deepak-kapa/PancakeActuator/plots/backlash_comparison.png

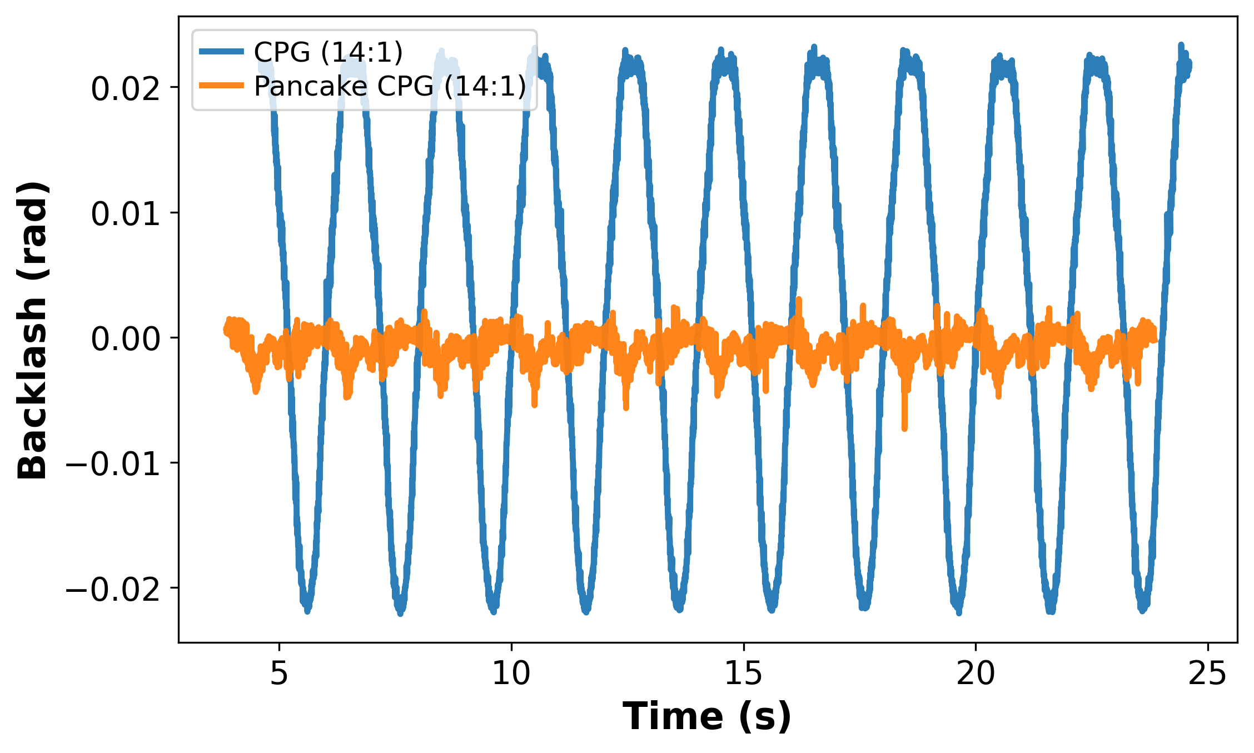
plots/backlash_comparison.png
