deepak-kapa/PancakeActuator/plots/efficiency_comparison.png

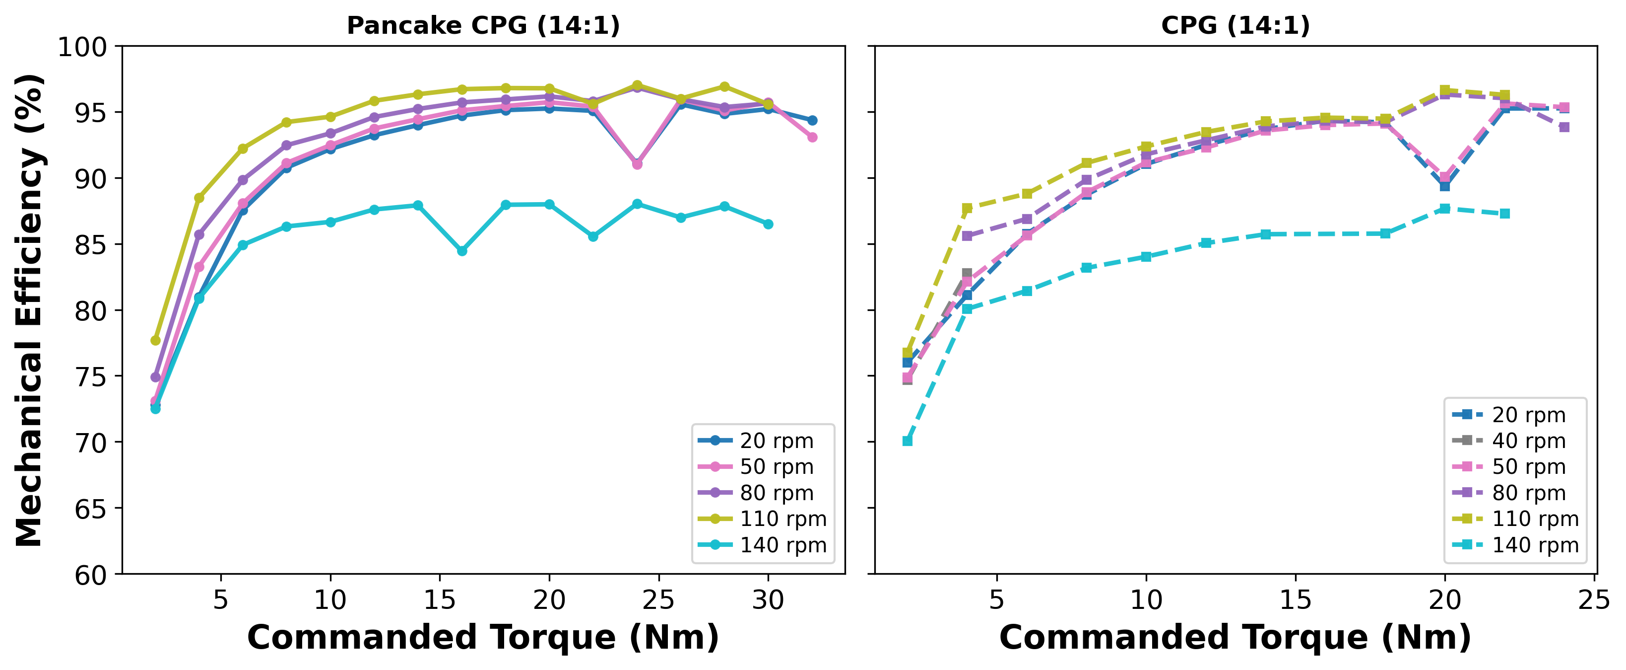
plots/efficiency_comparison.png
