deepak-kapa/PancakeActuator/plots/endurance_eff.png

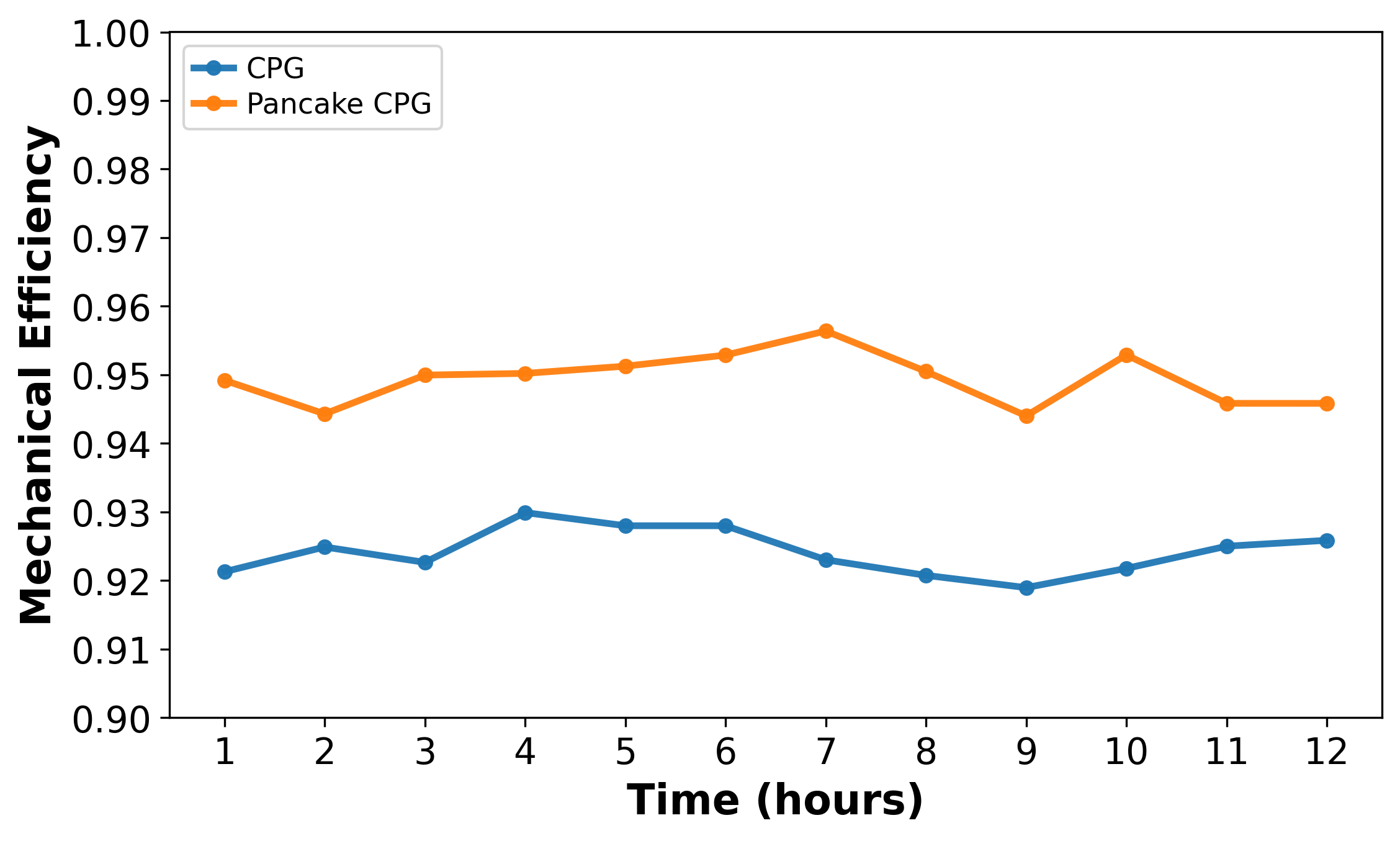
plots/endurance_eff.png
