deepak-kapa/PancakeActuator/plots/mass_width_vs_gear_ratio_metal.png

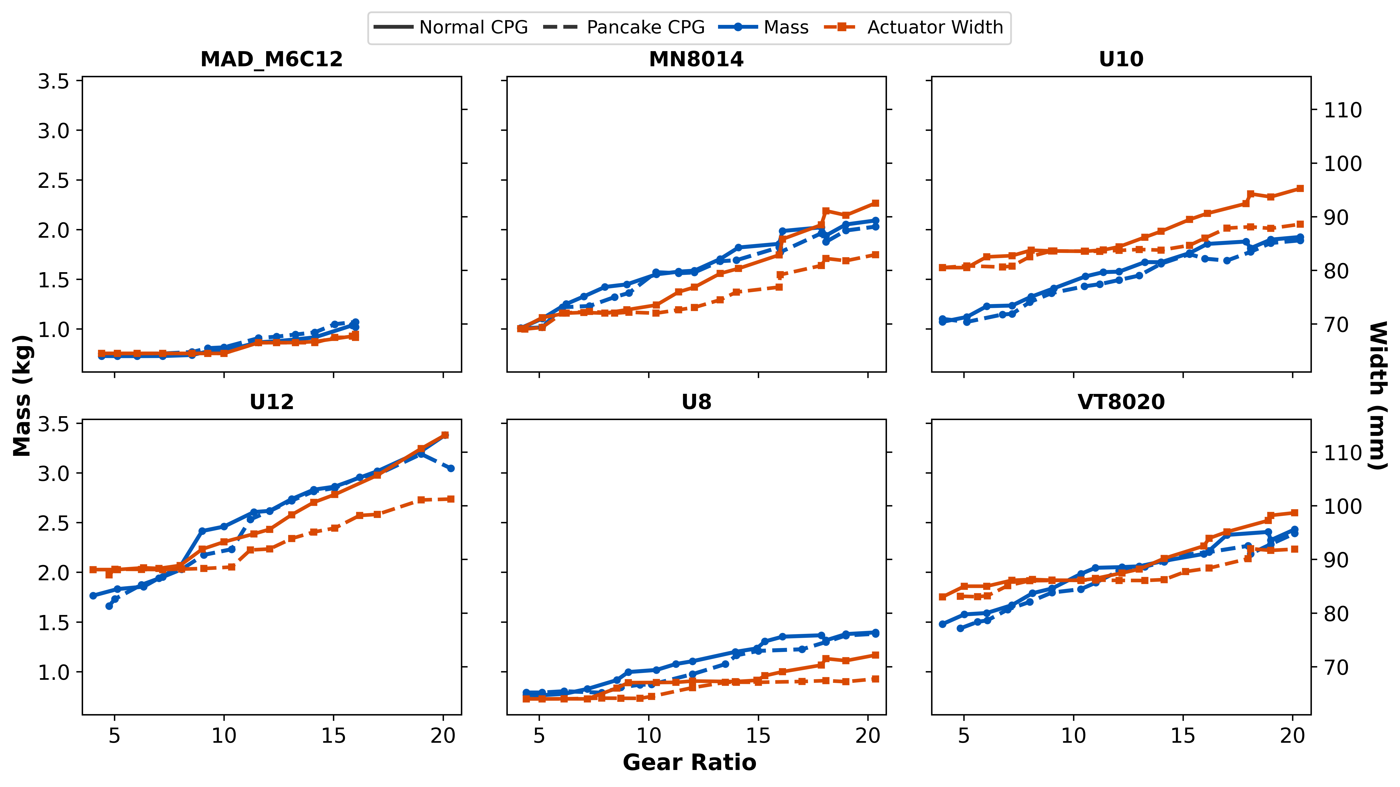
plots/mass_width_vs_gear_ratio_metal.png
