deepak-kapa/PancakeActuator/plots/stiffness_comparison.png

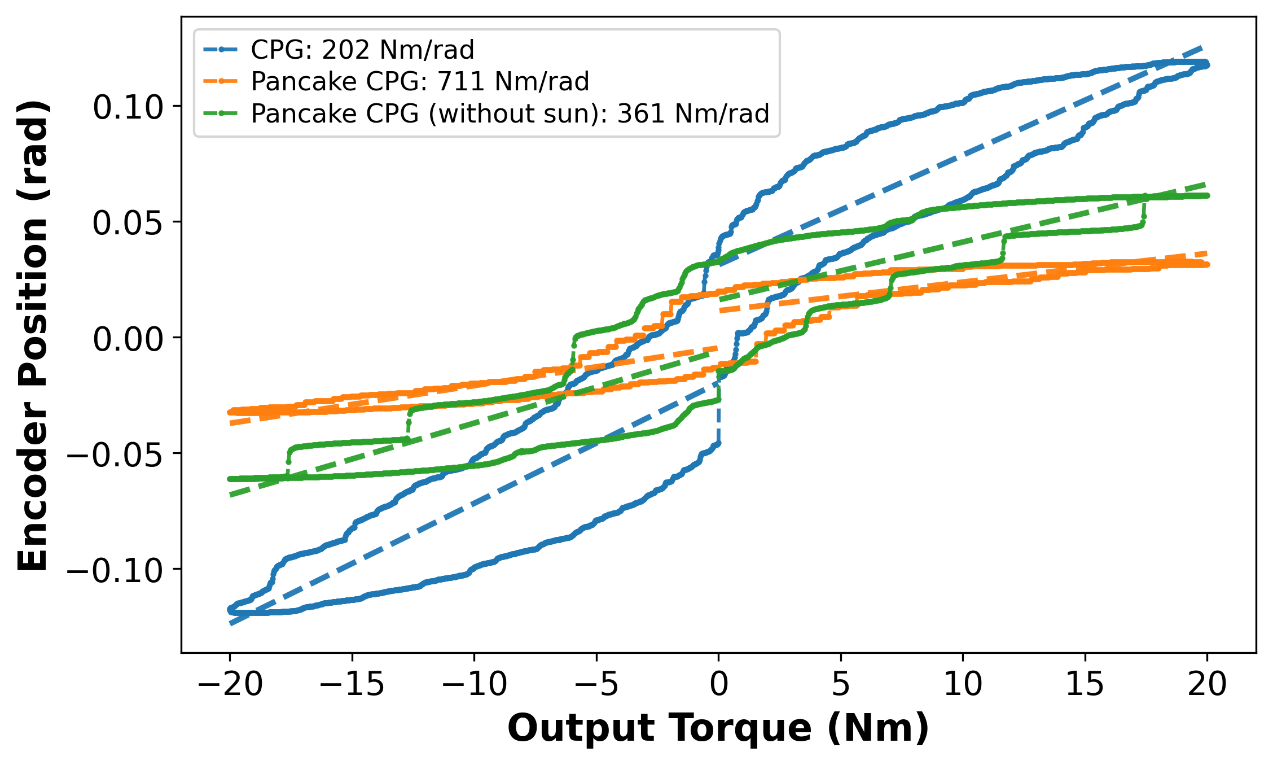
plots/stiffness_comparison.png
