deepak-kapa/PancakeActuator/plots/torque_comparison.png

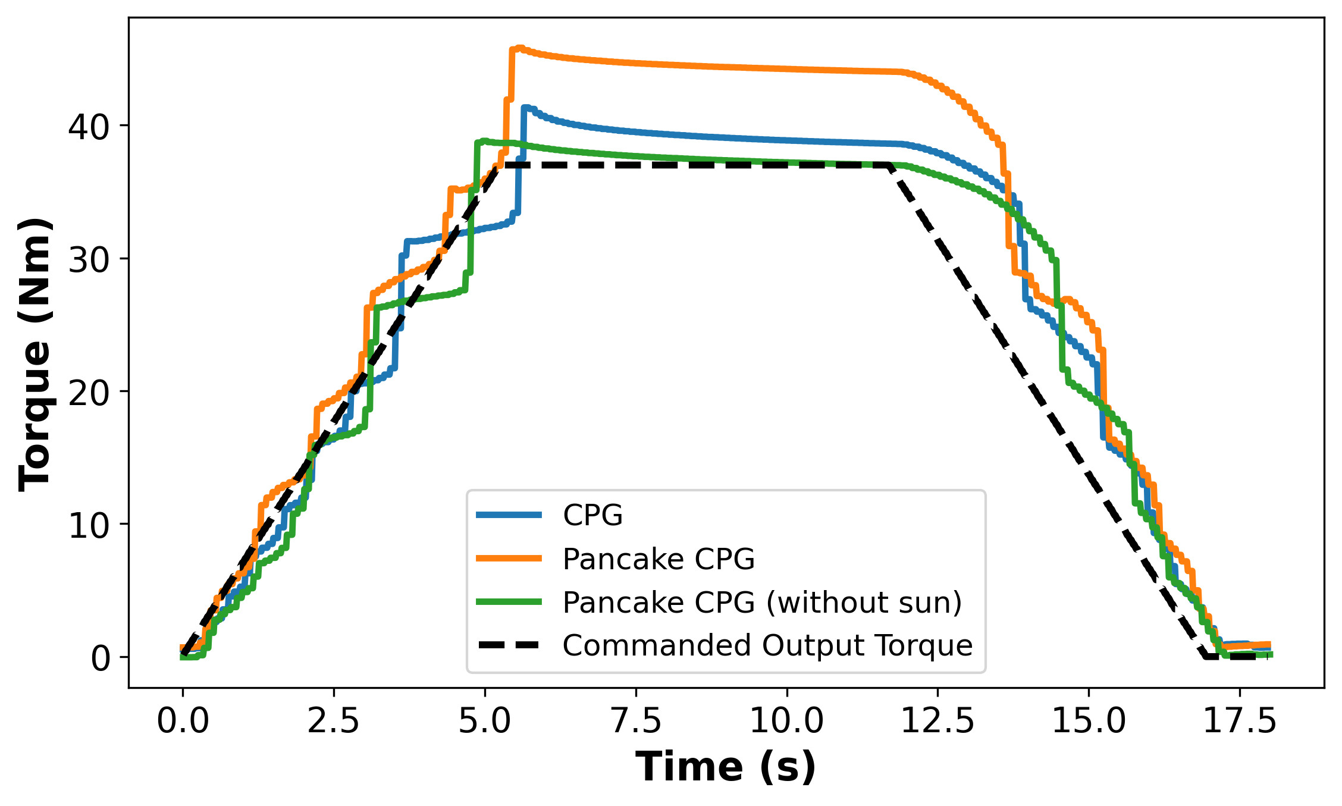
plots/torque_comparison.png
