deepak-kapa/PancakeActuator/CADs/SSPG/sspg_actuator.SLDASM

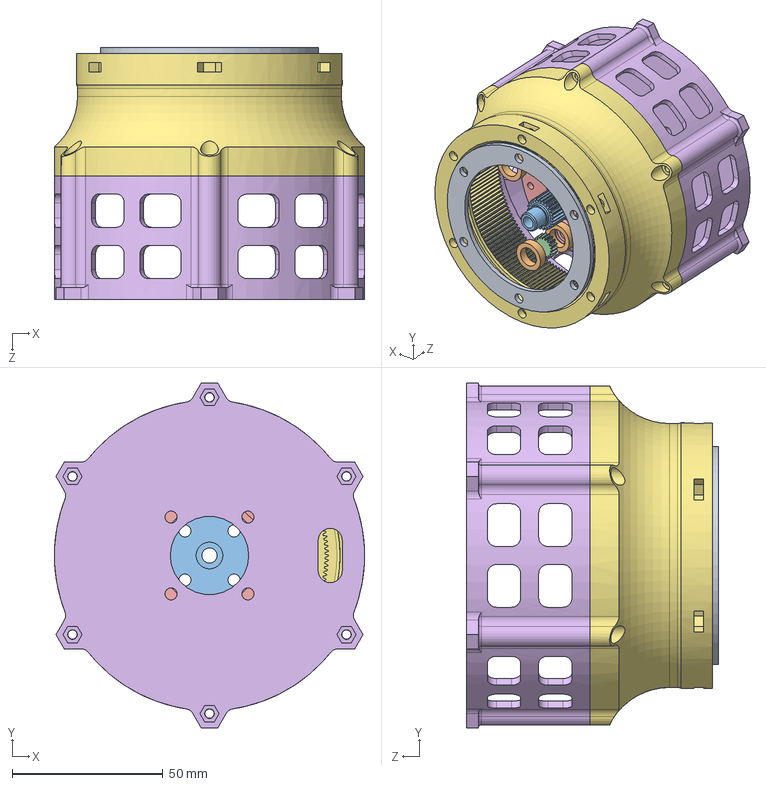
[picture p7: CAD file, 2026-04-23]
CADs/SSPG/sspg_actuator.SLDASM
102.8 x 114.3 x 83.6 mm
sspg_gearbox_casing
sspg_motor_casing
sspg_sec_carrier
sspg_planet x 3
sspg_sun
sspg_planet_bearing x 6
sspg_bearing_retainer
