deepak-kapa/PancakeActuator/CADs/DSPG/dspg_motor.SLDPRT

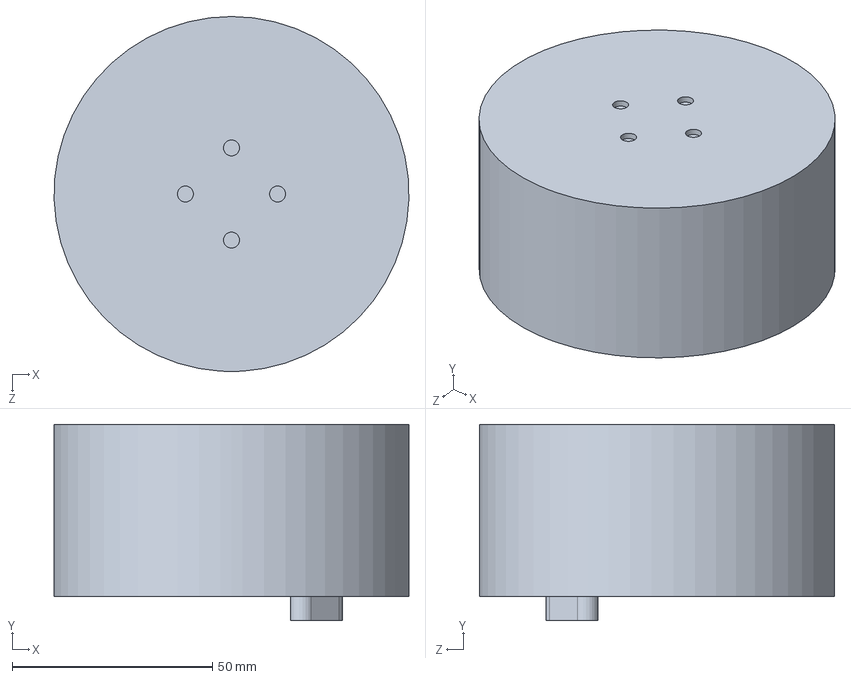
[picture p8: CAD file, 2026-04-23]
CADs/DSPG/dspg_motor.SLDPRT
88.6 x 49.0 x 88.6 mm
