deepak-kapa/PancakeActuator/CADs/WPG/wpg_actuator/wpg_actuator/wpg_bearing.SLDPRT

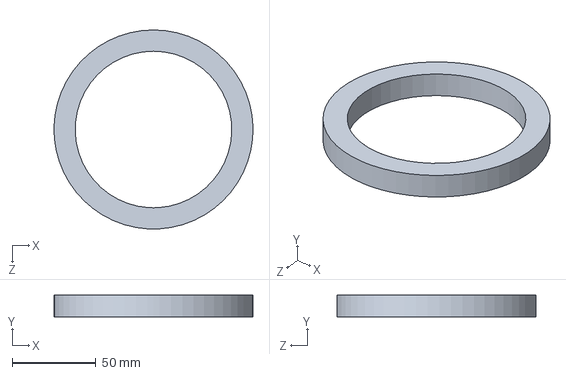
[picture p9: CAD file, 2026-04-23]
CADs/WPG/wpg_actuator/wpg_actuator/wpg_bearing.SLDPRT
119.0 x 13.0 x 119.0 mm
