deepak-kapa/PancakeActuator/pancake cads/cpg_actuator/cpg_motor.SLDPRT

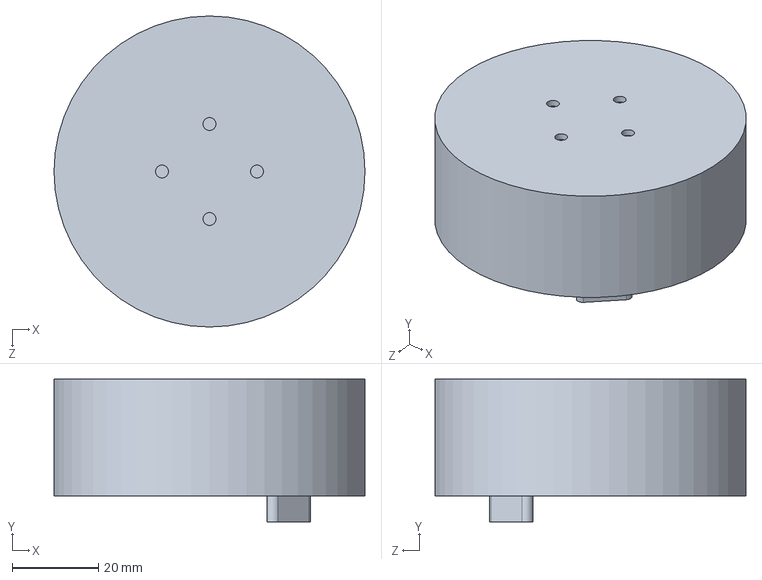
[picture p10: CAD file, 2026-08-31]
pancake cads/cpg_actuator/cpg_motor.SLDPRT
72.0 x 33.0 x 72.0 mm
