deepak-kapa/PancakeActuator/pancake cads/cpg_actuator_pancake/cpg_planet_bearing_pancake.SLDPRT

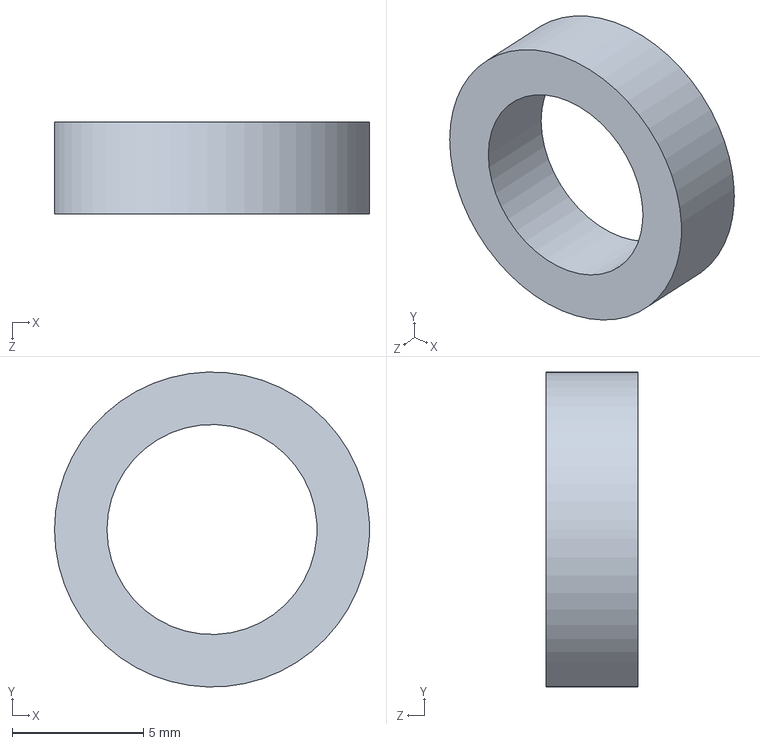
[picture p11: CAD file, 2026-04-23]
pancake cads/cpg_actuator_pancake/cpg_planet_bearing_pancake.SLDPRT
12.0 x 12.0 x 3.50 mm
