deepak-kapa/PancakeActuator/CADs/DSPG/bearing_retainer_stage2.SLDPRT

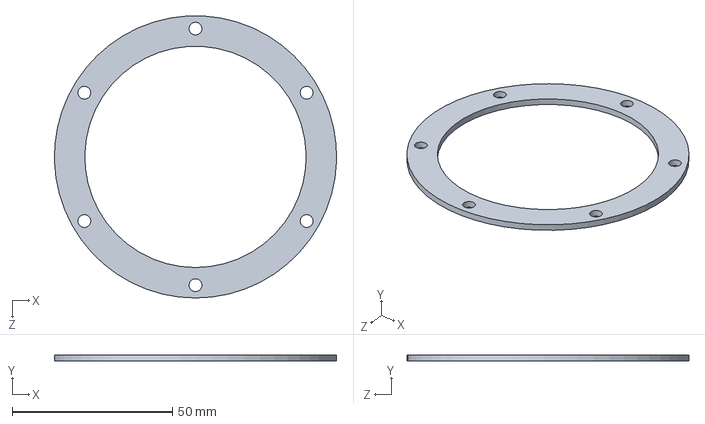
[picture p12: CAD file, 2026-04-23]
CADs/DSPG/bearing_retainer_stage2.SLDPRT
88.0 x 2.00 x 87.9 mm
