deepak-kapa/PancakeActuator/CADs/SSPG/sspg_bearing_retainer.SLDPRT

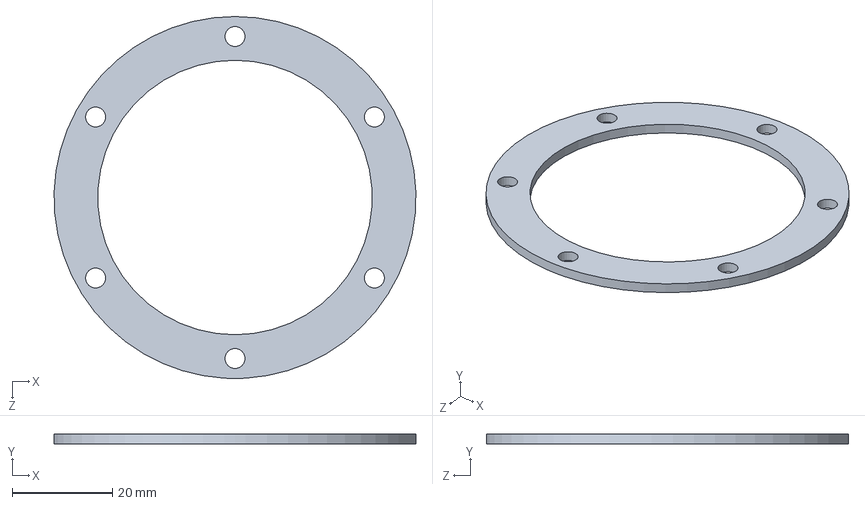
[picture p13: CAD file, 2026-04-23]
CADs/SSPG/sspg_bearing_retainer.SLDPRT
72.3 x 2.00 x 72.4 mm
