deepak-kapa/PancakeActuator/CADs/WPG/wpg_actuator/wpg_actuator/wpg_bearing_retainer.SLDPRT

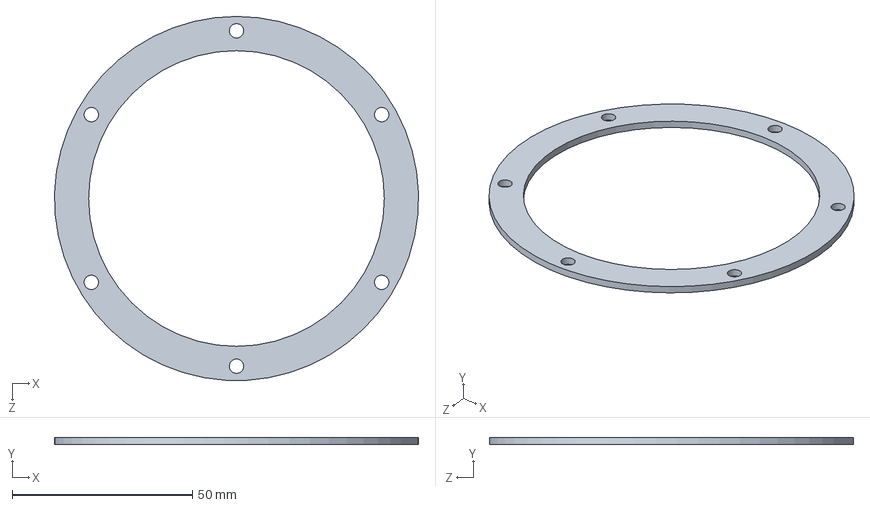
[picture p14: CAD file, 2026-04-23]
CADs/WPG/wpg_actuator/wpg_actuator/wpg_bearing_retainer.SLDPRT
101.0 x 2.00 x 101.0 mm
