deepak-kapa/PancakeActuator/CADs/WPG/wpg_gearbox_casing.SLDPRT

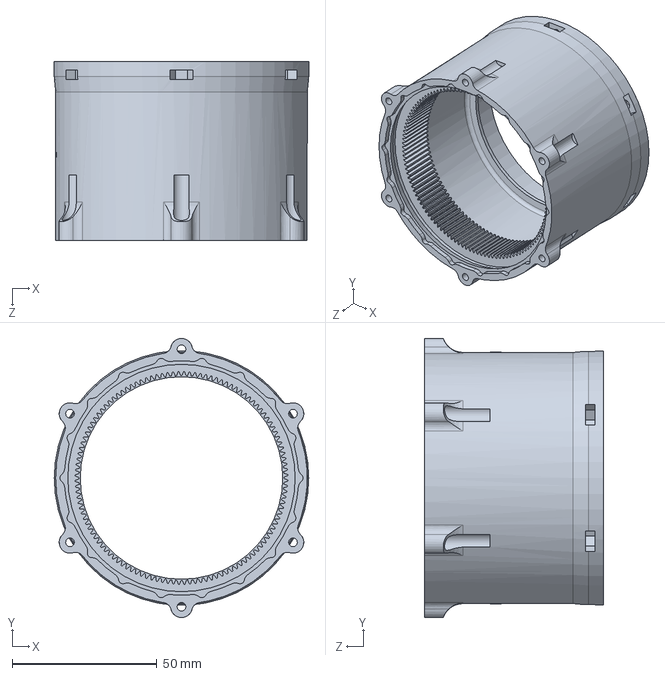
[picture p15: CAD file, 2026-04-23]
CADs/WPG/wpg_gearbox_casing.SLDPRT
88.0 x 96.4 x 61.9 mm
