deepak-kapa/PancakeActuator/pancake cads/cpg_actuator/cpg_motor_casing.SLDPRT

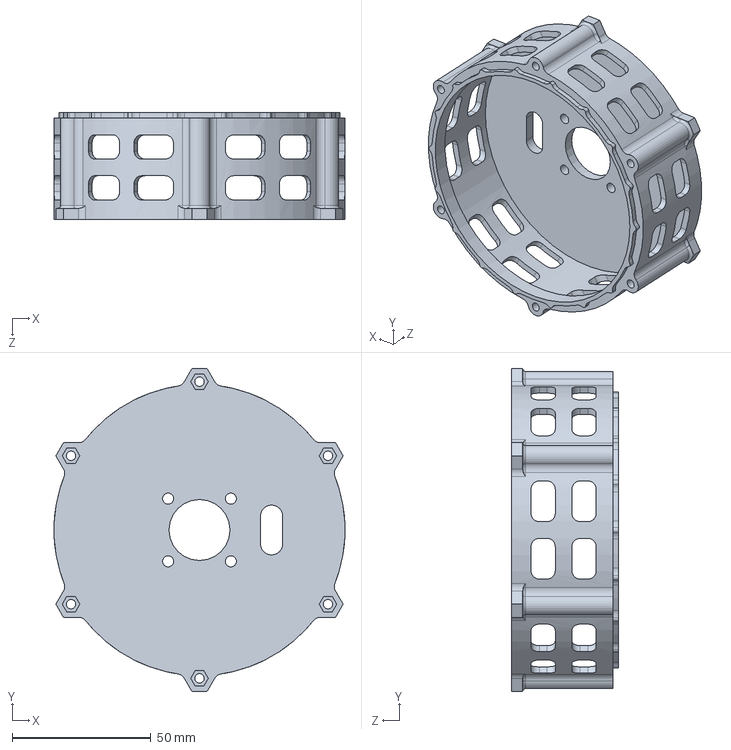
[picture p16: CAD file, 2026-08-31]
pancake cads/cpg_actuator/cpg_motor_casing.SLDPRT
104.8 x 116.5 x 38.5 mm
