deepak-kapa/PancakeActuator/CADs/DSPG/dspg_bearing_stg1.SLDPRT

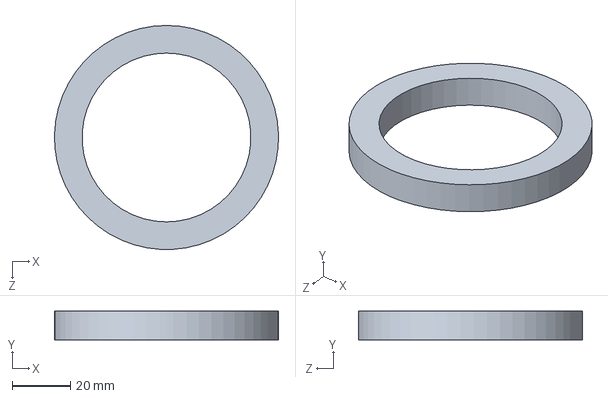
[picture p17: CAD file, 2026-04-23]
CADs/DSPG/dspg_bearing_stg1.SLDPRT
77.0 x 9.84 x 77.0 mm
