deepak-kapa/PancakeActuator/CADs/SSPG/sspg_motor_casing.SLDPRT

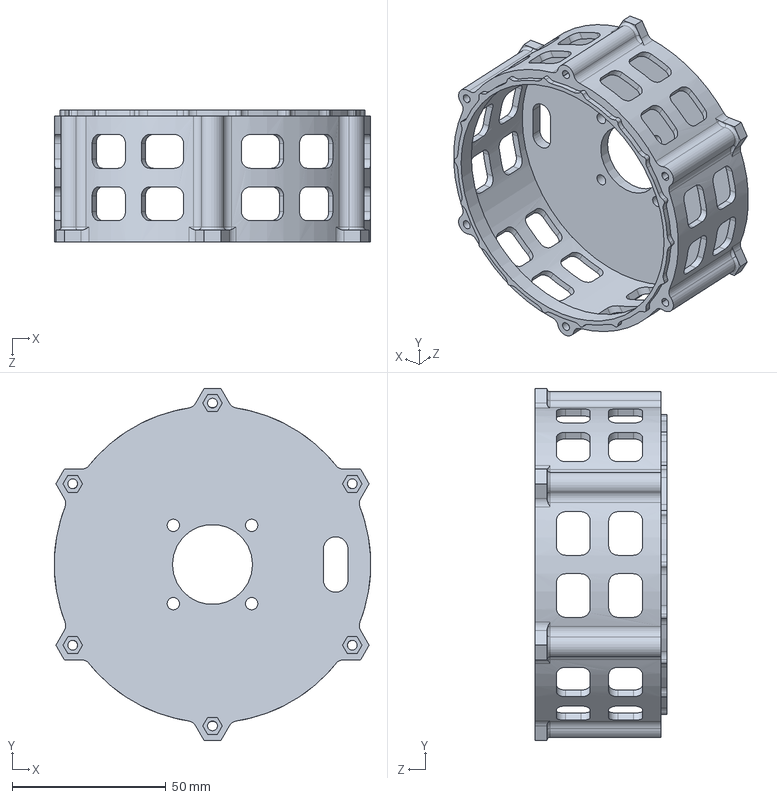
[picture p18: CAD file, 2026-04-23]
CADs/SSPG/sspg_motor_casing.SLDPRT
102.6 x 114.3 x 43.0 mm
