deepak-kapa/PancakeActuator/pancake cads/cpg_actuator/cpg_planet.SLDPRT

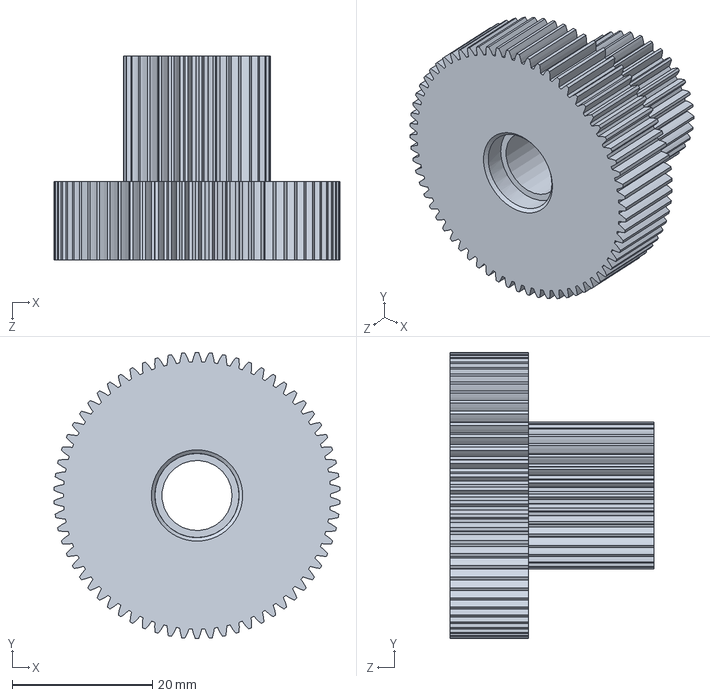
[picture p19: CAD file, 2026-08-31]
pancake cads/cpg_actuator/cpg_planet.SLDPRT
40.8 x 40.8 x 29.1 mm
