deepak-kapa/PancakeActuator/pancake cads/cpg_actuator_pancake/cpg_sec_carrier_pancake.SLDPRT

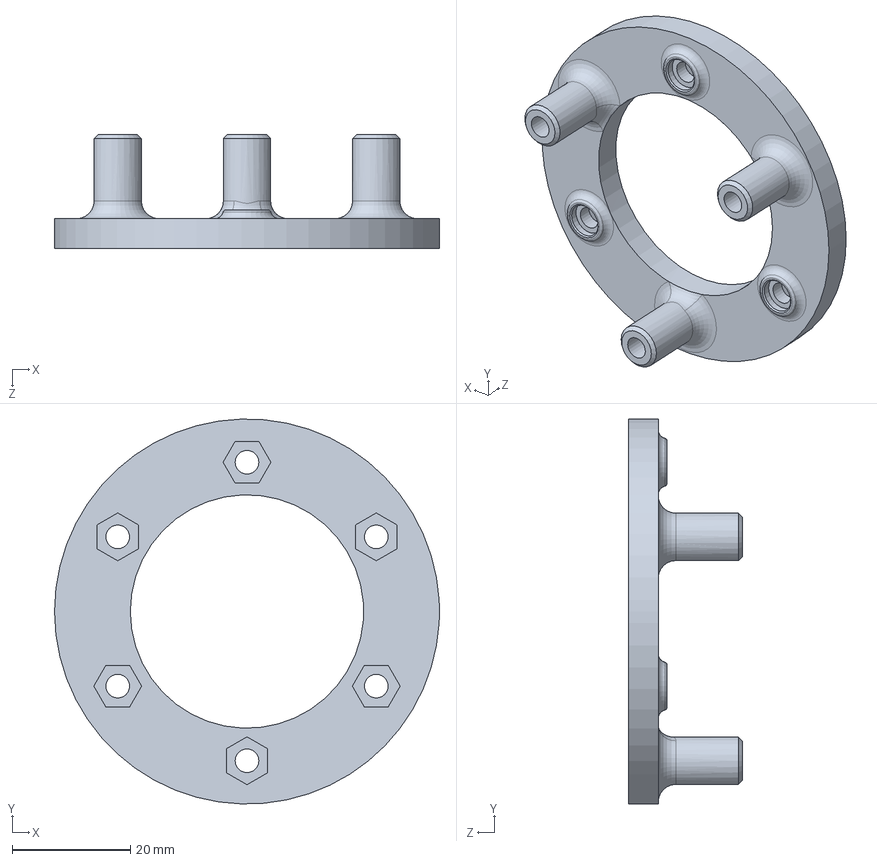
[picture p20: CAD file, 2026-04-23]
pancake cads/cpg_actuator_pancake/cpg_sec_carrier_pancake.SLDPRT
65.0 x 65.0 x 19.2 mm
