deepak-kapa/PancakeActuator/CADs/DSPG/dspg_gearbox_casing_stg1.SLDPRT

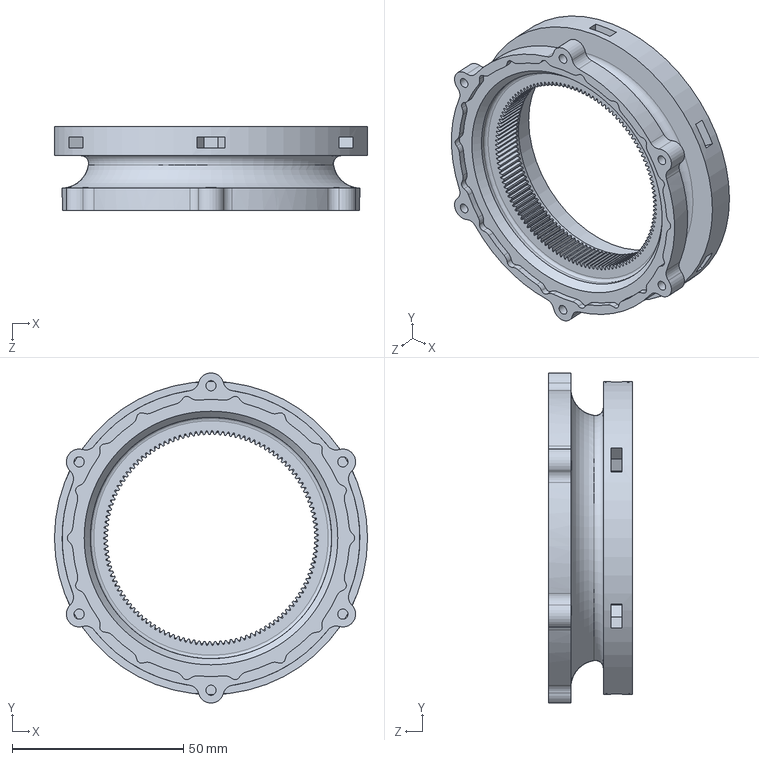
[picture p21: CAD file, 2026-04-23]
CADs/DSPG/dspg_gearbox_casing_stg1.SLDPRT
91.5 x 96.4 x 24.5 mm
