deepak-kapa/PancakeActuator/CADs/SSPG/sspg_gearbox_casing.SLDPRT

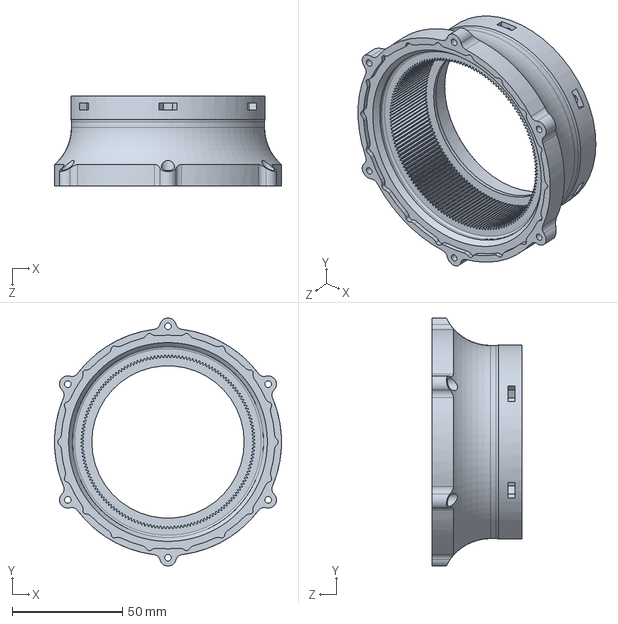
[picture p22: CAD file, 2026-04-23]
CADs/SSPG/sspg_gearbox_casing.SLDPRT
102.8 x 112.3 x 40.6 mm
