deepak-kapa/PancakeActuator/CADs/WPG/wpg_actuator/wpg_actuator/wpg_carrier.SLDPRT

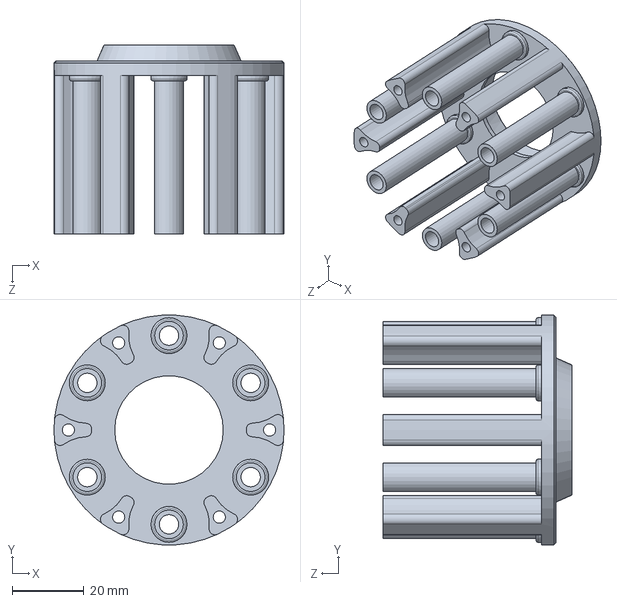
[picture p23: CAD file, 2026-04-23]
CADs/WPG/wpg_actuator/wpg_actuator/wpg_carrier.SLDPRT
64.0 x 63.9 x 52.7 mm
