deepak-kapa/PancakeActuator/CADs/WPG/wpg_small_ring_bearing_shaft.SLDPRT

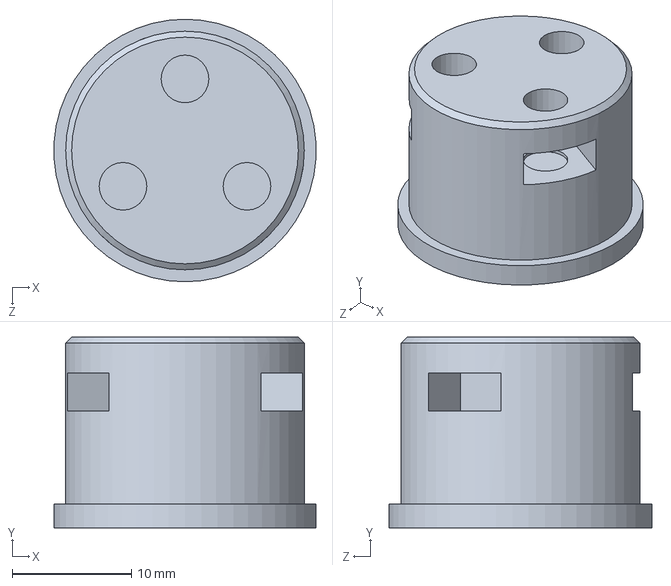
[picture p24: CAD file, 2026-04-23]
CADs/WPG/wpg_small_ring_bearing_shaft.SLDPRT
22.0 x 16.0 x 22.0 mm
