deepak-kapa/PancakeActuator/CADs/DSPG/dspg_planet_stg2.SLDPRT

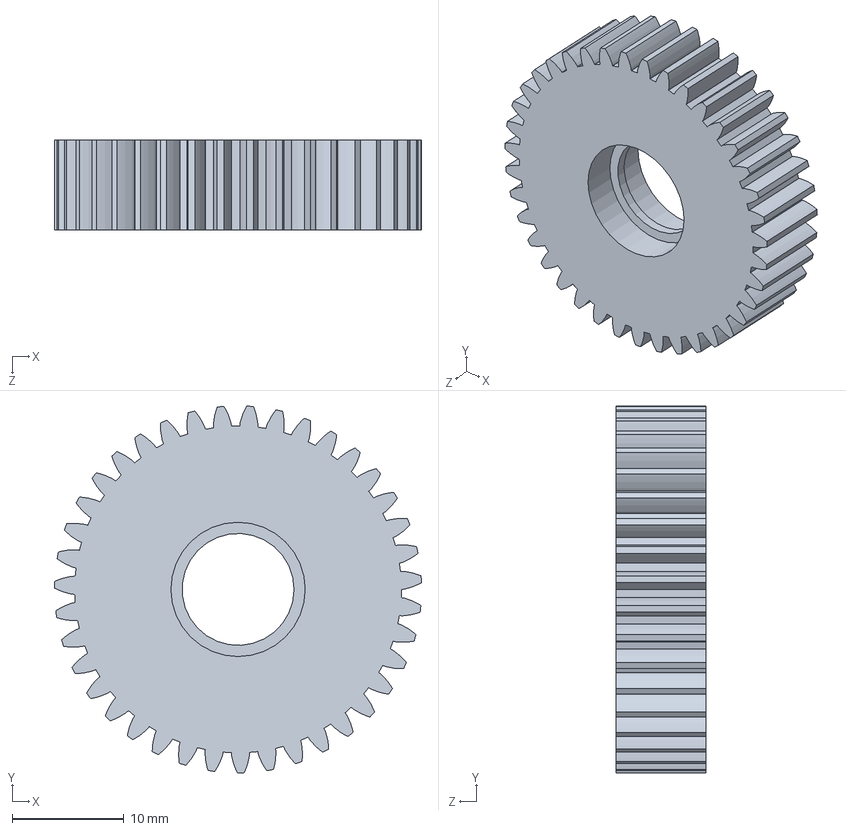
[picture p25: CAD file, 2026-04-23]
CADs/DSPG/dspg_planet_stg2.SLDPRT
32.8 x 32.8 x 8.00 mm
