deepak-kapa/PancakeActuator/CADs/SSPG/sspg_sec_carrier.SLDPRT

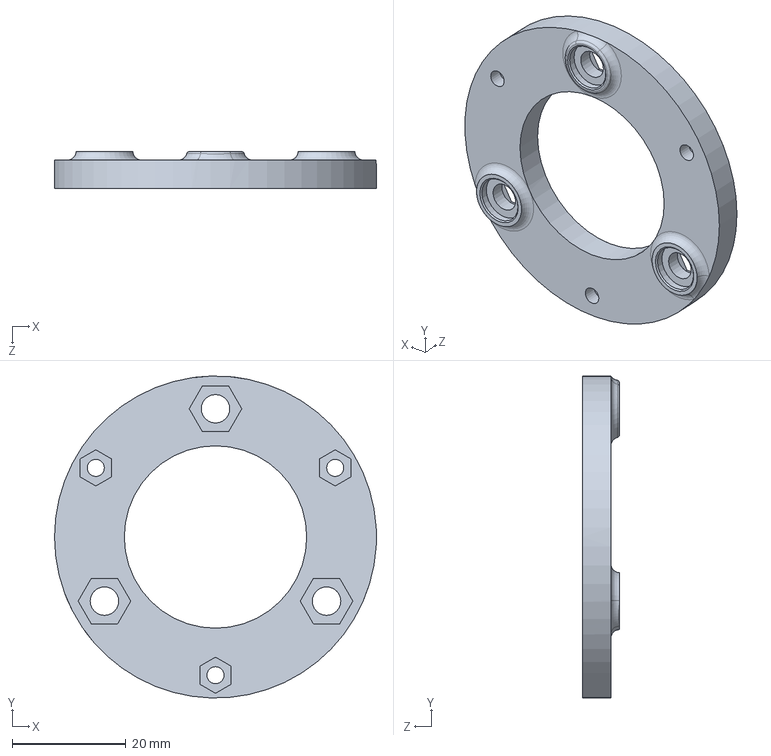
[picture p26: CAD file, 2026-04-23]
CADs/SSPG/sspg_sec_carrier.SLDPRT
56.5 x 56.5 x 6.50 mm
