deepak-kapa/PancakeActuator/pancake cads/cpg_actuator/cpg_carrier.SLDPRT

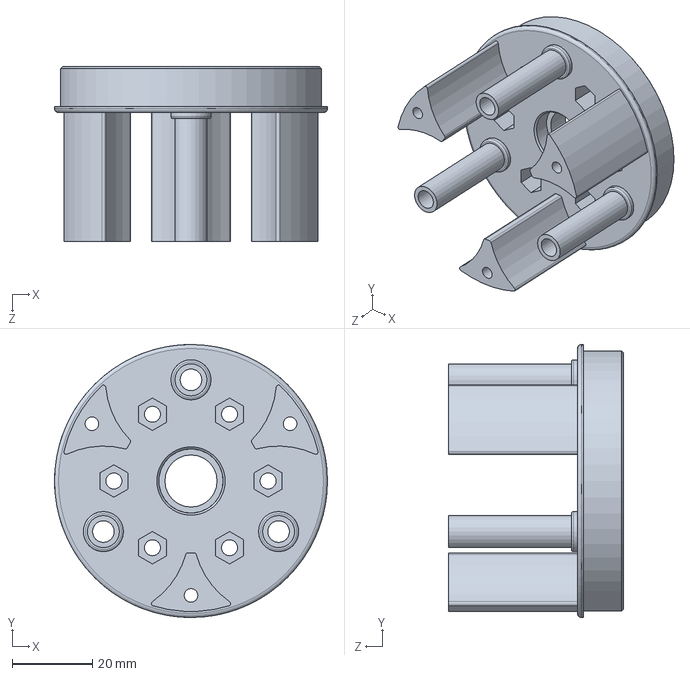
[picture p27: CAD file, 2026-08-31]
pancake cads/cpg_actuator/cpg_carrier.SLDPRT
68.0 x 68.0 x 43.6 mm
