deepak-kapa/PancakeActuator/CADs/DSPG/dspg_carrier_stg1.SLDPRT

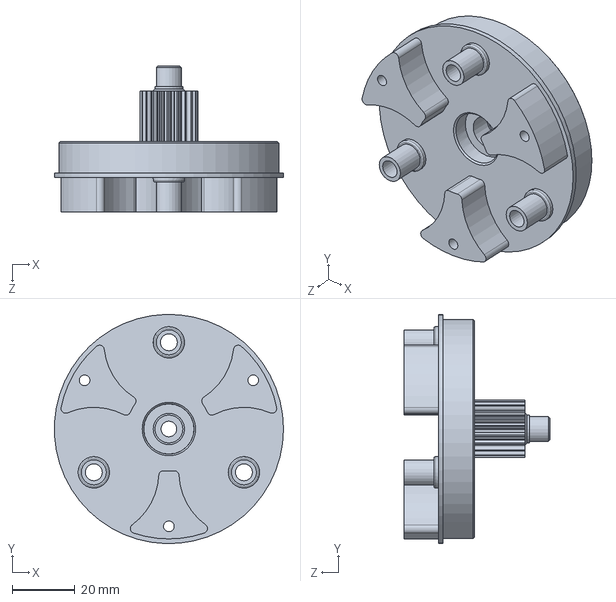
[picture p28: CAD file, 2026-04-23]
CADs/DSPG/dspg_carrier_stg1.SLDPRT
72.9 x 73.0 x 46.5 mm
