deepak-kapa/PancakeActuator/CADs/SSPG/sspg_planet.SLDPRT

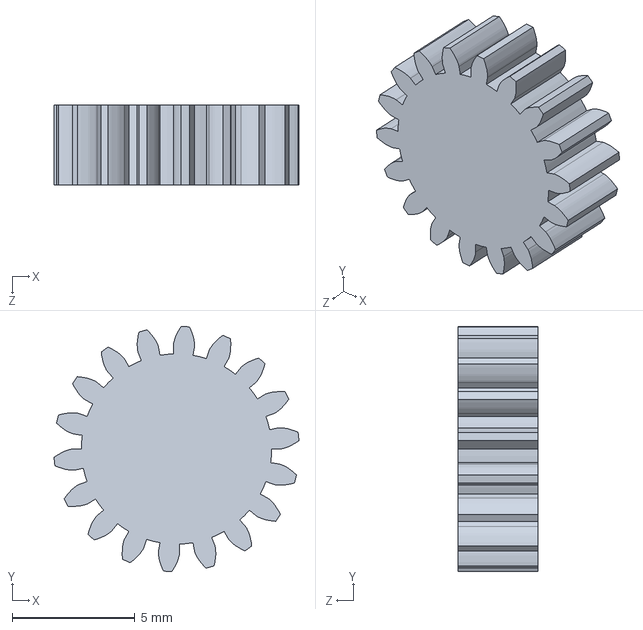
[picture p29: CAD file, 2026-04-23]
CADs/SSPG/sspg_planet.SLDPRT
9.98 x 9.99 x 3.26 mm
