deepak-kapa/PancakeActuator/CADs/WPG/wpg_sec_carrier.SLDPRT

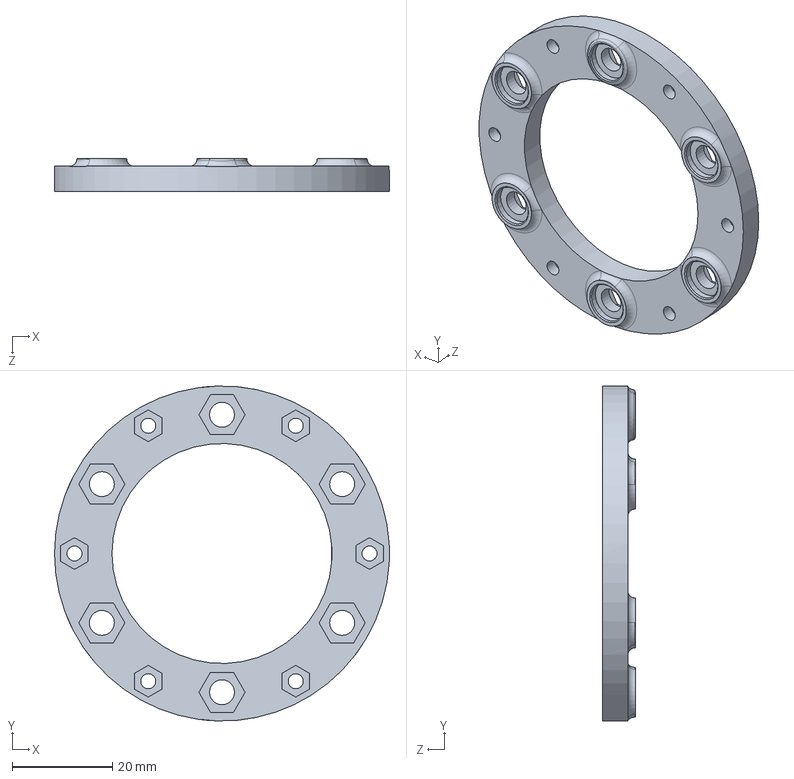
[picture p30: CAD file, 2026-04-23]
CADs/WPG/wpg_sec_carrier.SLDPRT
67.0 x 67.0 x 6.50 mm
