deepak-kapa/PancakeActuator/pancake cads/cpg_actuator/cpg_bearing.SLDPRT

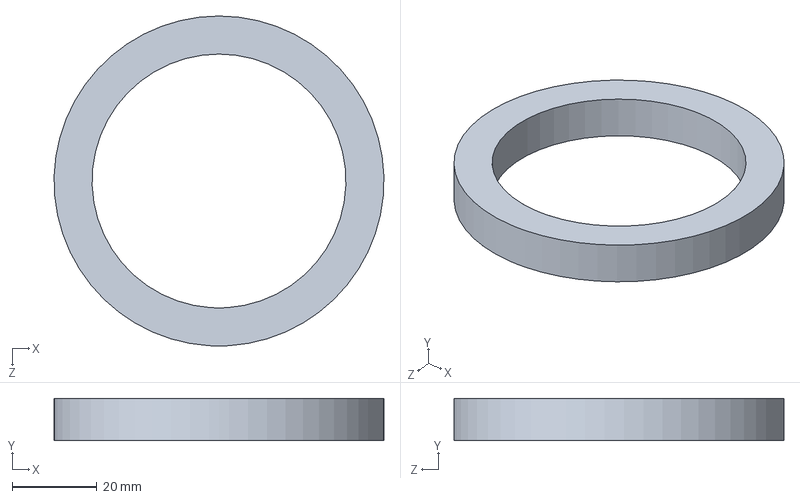
[picture p31: CAD file, 2026-08-31]
pancake cads/cpg_actuator/cpg_bearing.SLDPRT
78.0 x 10.0 x 78.0 mm
