deepak-kapa/PancakeActuator/pancake cads/cpg_actuator_pancake/cpg_sun_shaft_bearing_pancake.SLDPRT

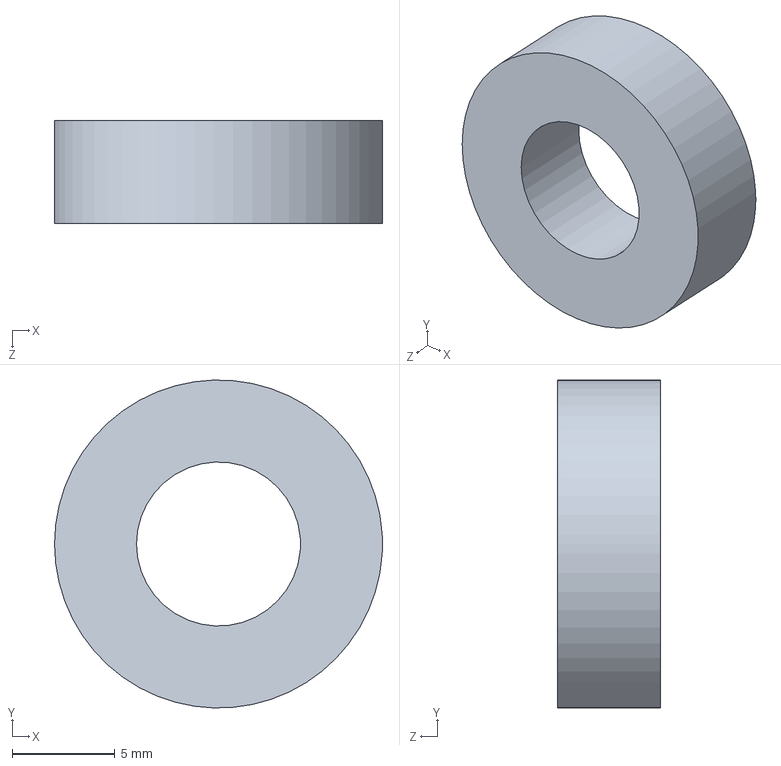
[picture p32: CAD file, 2026-04-23]
pancake cads/cpg_actuator_pancake/cpg_sun_shaft_bearing_pancake.SLDPRT
16.0 x 16.0 x 5.00 mm
