deepak-kapa/PancakeActuator/CADs/DSPG/dspg_driver_mount.SLDPRT

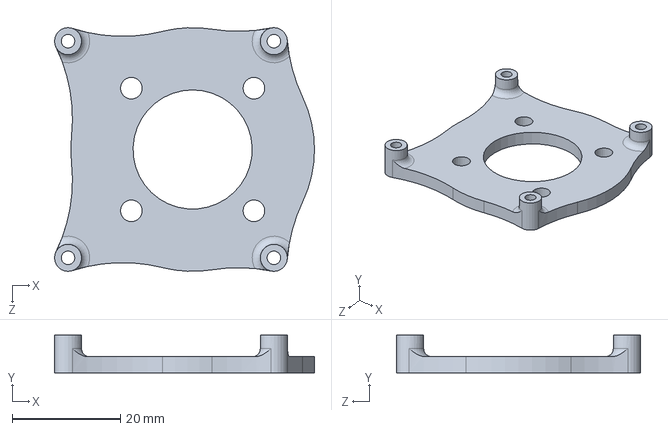
[picture p33: CAD file, 2026-04-23]
CADs/DSPG/dspg_driver_mount.SLDPRT
48.0 x 7.00 x 45.0 mm
