deepak-kapa/PancakeActuator/CADs/SSPG/sspg_sun.SLDPRT

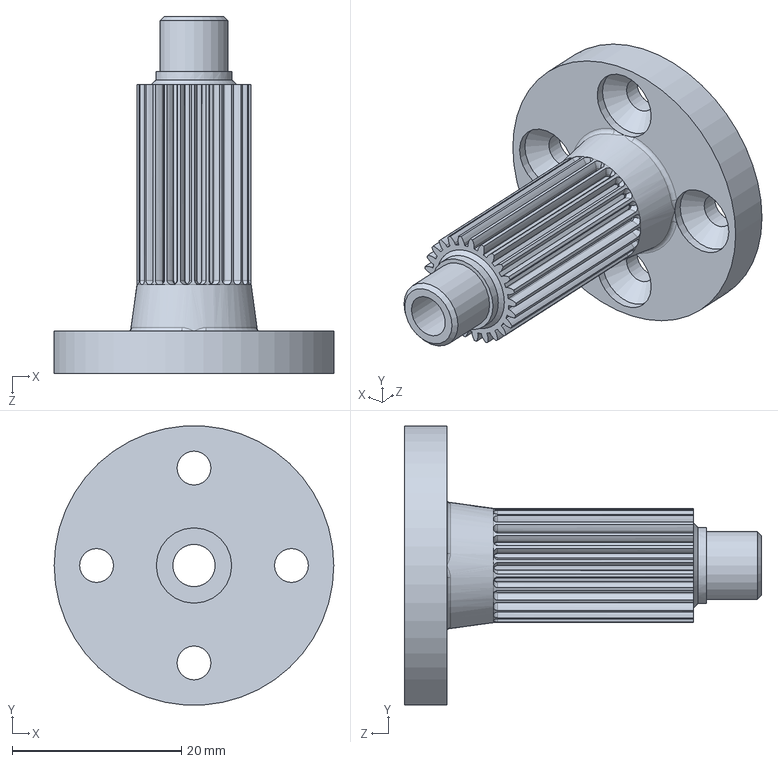
[picture p34: CAD file, 2026-04-23]
CADs/SSPG/sspg_sun.SLDPRT
33.0 x 32.9 x 42.1 mm
