deepak-kapa/PancakeActuator/pancake cads/cpg_actuator/cpg_sun.SLDPRT

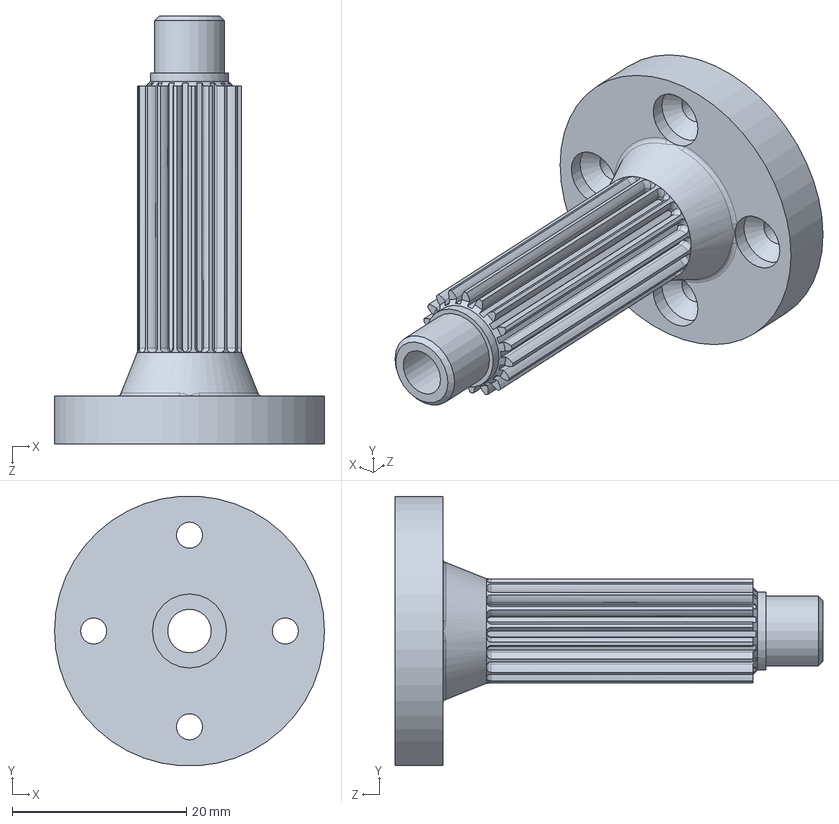
[picture p35: CAD file, 2026-08-31]
pancake cads/cpg_actuator/cpg_sun.SLDPRT
31.0 x 30.9 x 49.1 mm
