deepak-kapa/PancakeActuator/pancake cads/cpg_actuator_pancake/carrier_iros.SLDPRT

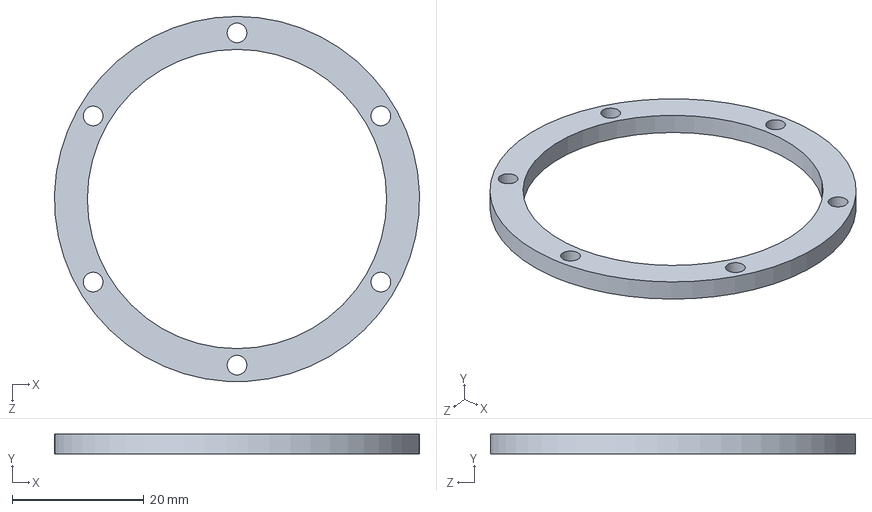
[picture p36: CAD file, 2026-04-23]
pancake cads/cpg_actuator_pancake/carrier_iros.SLDPRT
55.4 x 3.00 x 55.4 mm
