deepak-kapa/PancakeActuator/CADs/CPG/cpg_magnet_mount.SLDPRT

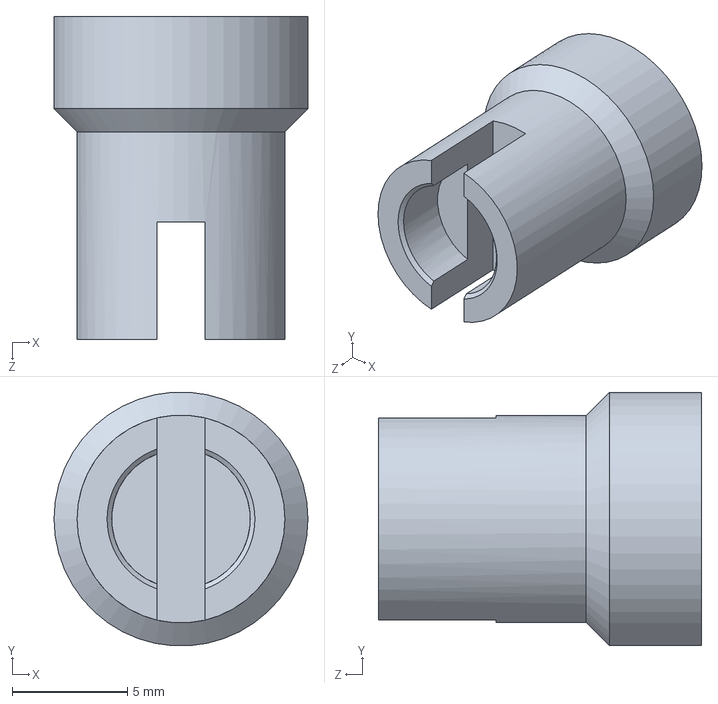
[picture p37: CAD file, 2026-04-23]
CADs/CPG/cpg_magnet_mount.SLDPRT
11.0 x 11.0 x 14.0 mm
