deepak-kapa/PancakeActuator/CADs/DSPG/dspg_gearbox_casing_stg2_new.SLDPRT

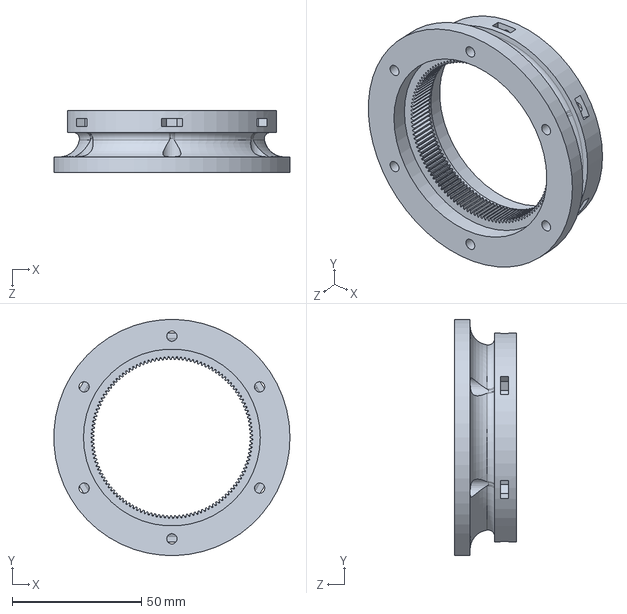
[picture p38: CAD file, 2026-04-23]
CADs/DSPG/dspg_gearbox_casing_stg2_new.SLDPRT
91.4 x 91.5 x 24.0 mm
