deepak-kapa/PancakeActuator/CADs/WPG/wpg_motor_casing.SLDPRT

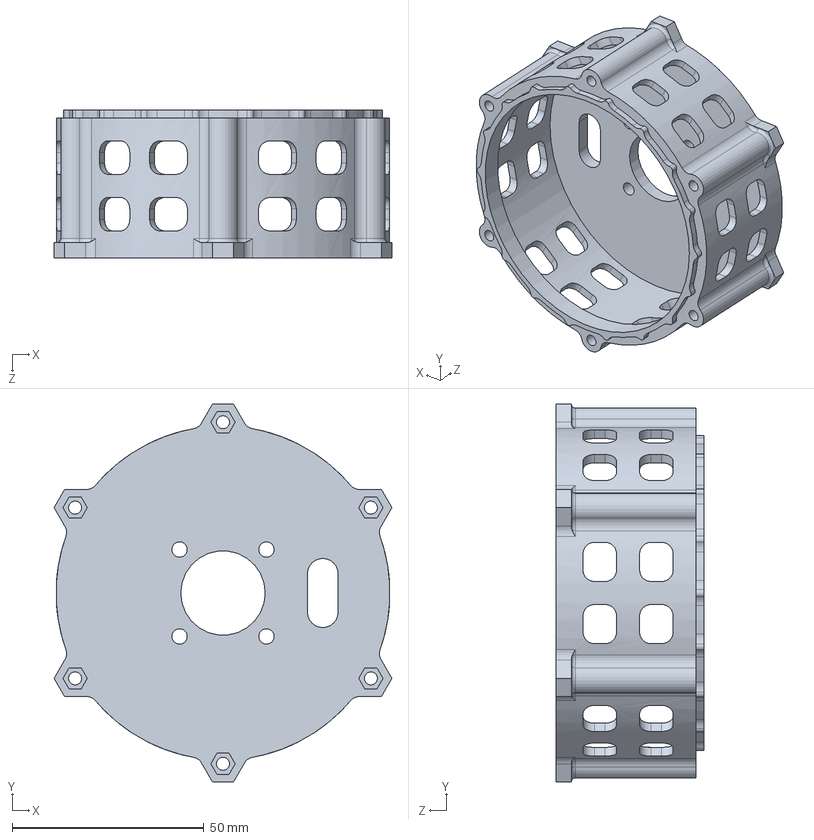
[picture p39: CAD file, 2026-04-23]
CADs/WPG/wpg_motor_casing.SLDPRT
88.0 x 98.5 x 38.5 mm
