deepak-kapa/PancakeActuator/pancake cads/cpg_actuator/cpg_sec_carrier.SLDPRT

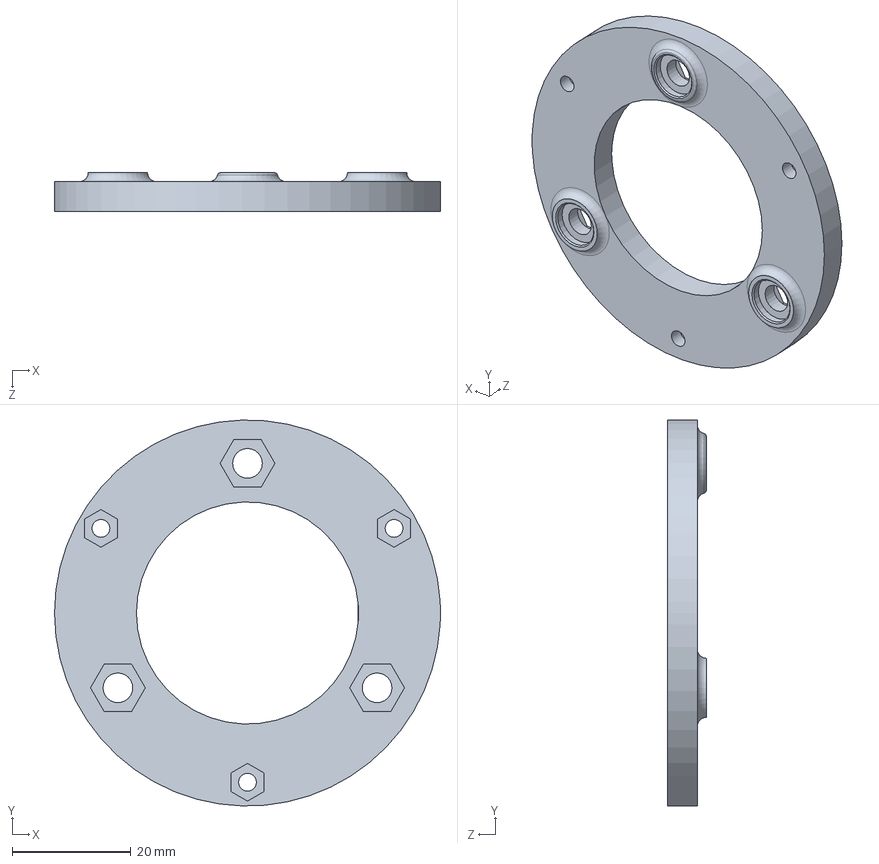
[picture p40: CAD file, 2026-08-31]
pancake cads/cpg_actuator/cpg_sec_carrier.SLDPRT
65.0 x 65.0 x 6.50 mm
