deepak-kapa/PancakeActuator/CADs/DSPG/dspg_sec_carrier_stg2.SLDPRT

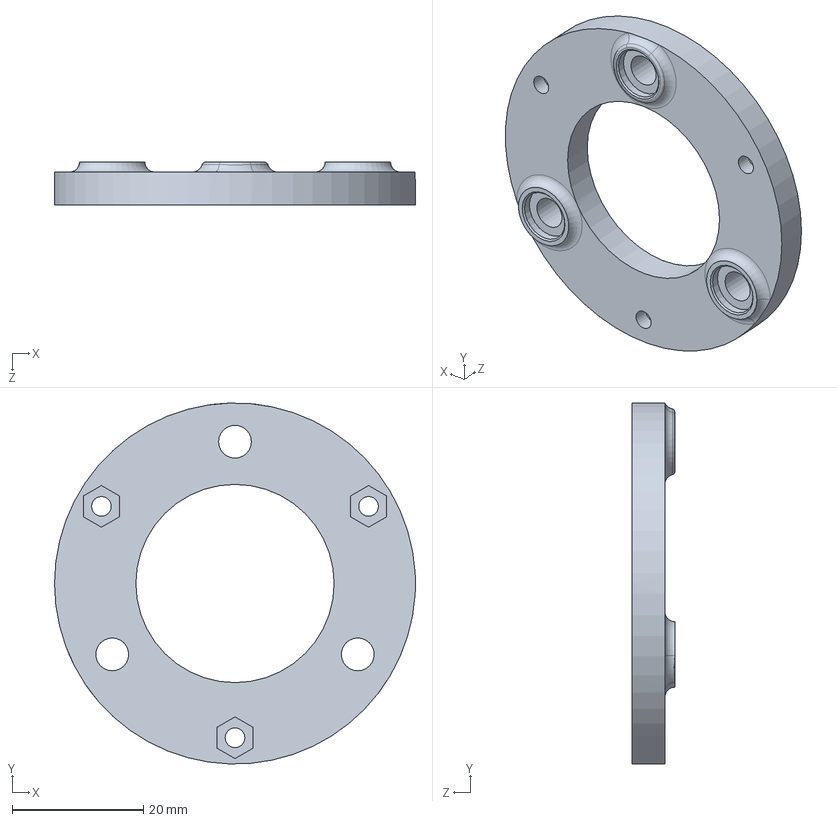
[picture p41: CAD file, 2026-04-23]
CADs/DSPG/dspg_sec_carrier_stg2.SLDPRT
55.0 x 55.0 x 6.50 mm
