deepak-kapa/PancakeActuator/CADs/SSPG/sspg_bearing.SLDPRT

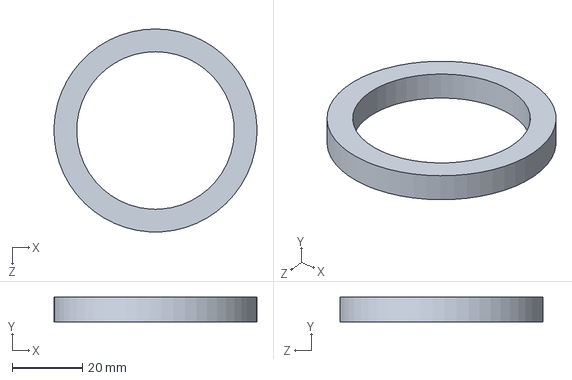
[picture p42: CAD file, 2026-04-23]
CADs/SSPG/sspg_bearing.SLDPRT
58.0 x 7.00 x 58.0 mm
