deepak-kapa/PancakeActuator/CADs/WPG/wpg_actuator/wpg_actuator/wpg_sun.SLDPRT

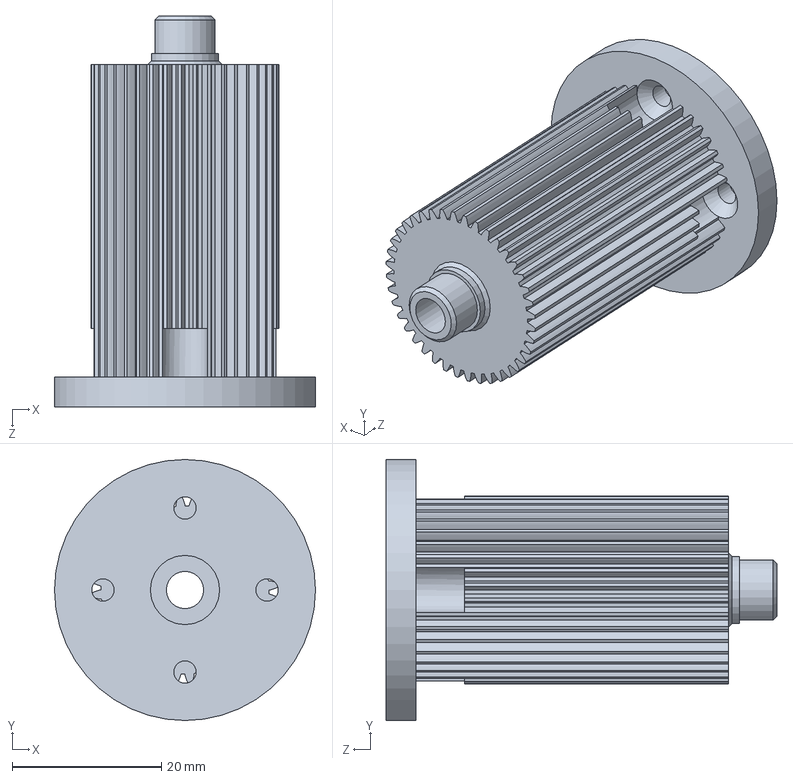
[picture p43: CAD file, 2026-04-23]
CADs/WPG/wpg_actuator/wpg_actuator/wpg_sun.SLDPRT
35.0 x 35.0 x 52.4 mm
