deepak-kapa/PancakeActuator/pancake cads/cpg_actuator/cpg_bearing_retainer.SLDPRT

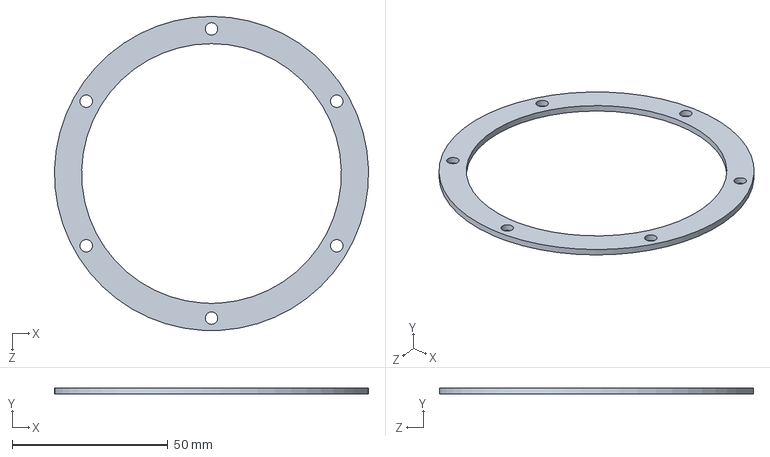
[picture p44: CAD file, 2026-08-31]
pancake cads/cpg_actuator/cpg_bearing_retainer.SLDPRT
101.0 x 2.00 x 101.0 mm
