deepak-kapa/PancakeActuator/CADs/CPG/cpg_sun.SLDPRT

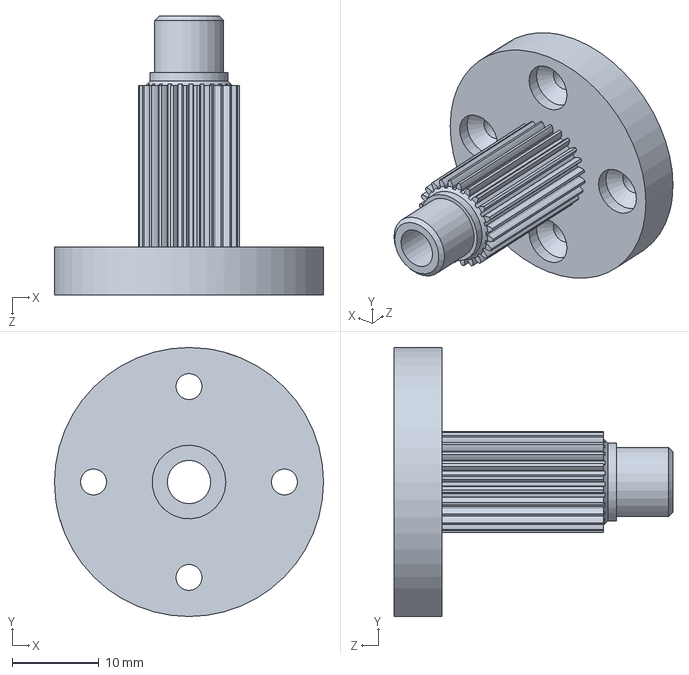
[picture p45: CAD file, 2026-04-23]
CADs/CPG/cpg_sun.SLDPRT
31.0 x 31.0 x 32.1 mm
