deepak-kapa/PancakeActuator/CADs/DSPG/dspg_planet_stg1.SLDPRT

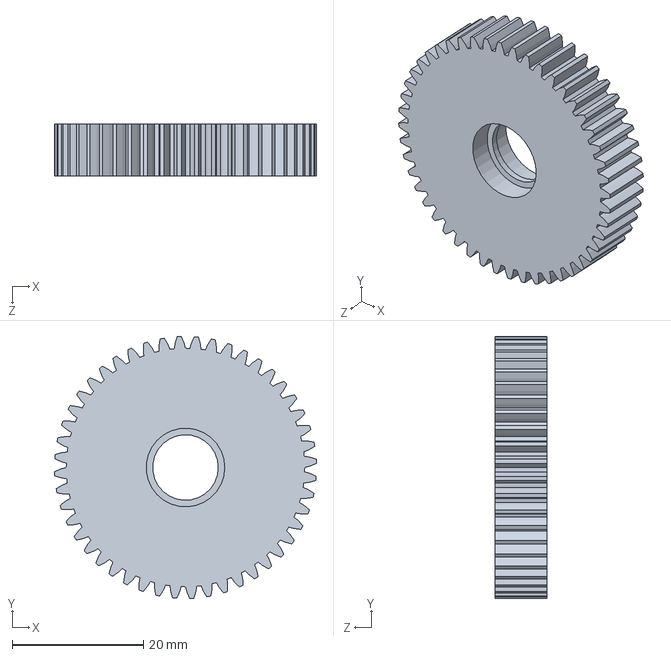
[picture p46: CAD file, 2026-04-23]
CADs/DSPG/dspg_planet_stg1.SLDPRT
40.0 x 40.0 x 8.00 mm
