deepak-kapa/PancakeActuator/CADs/SSPG/sspg_carrier.SLDPRT

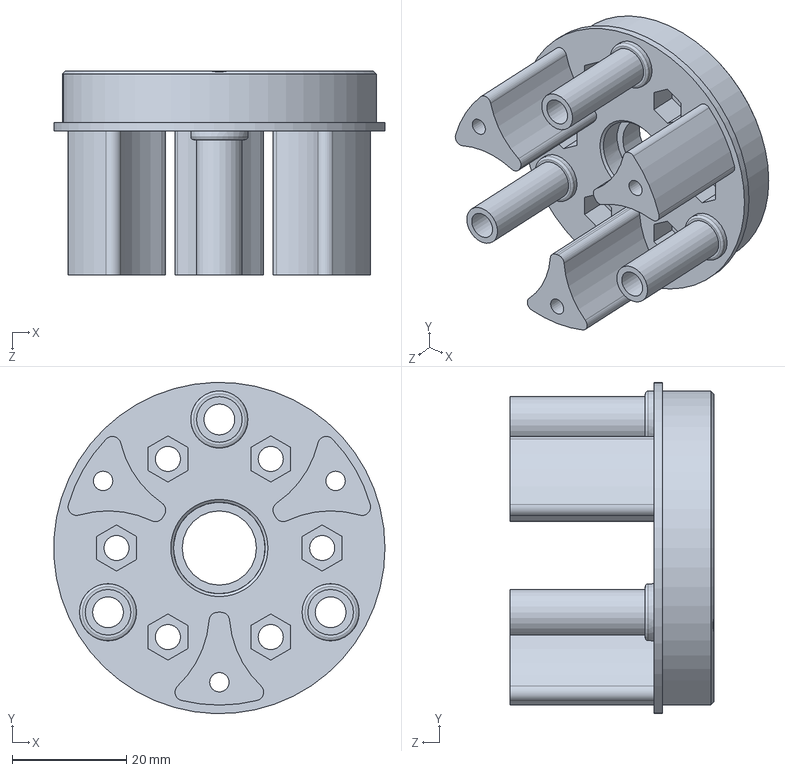
[picture p47: CAD file, 2026-04-23]
CADs/SSPG/sspg_carrier.SLDPRT
57.9 x 58.0 x 35.6 mm
