deepak-kapa/PancakeActuator/pancake cads/cpg_actuator/cpg_driver_mount.SLDPRT

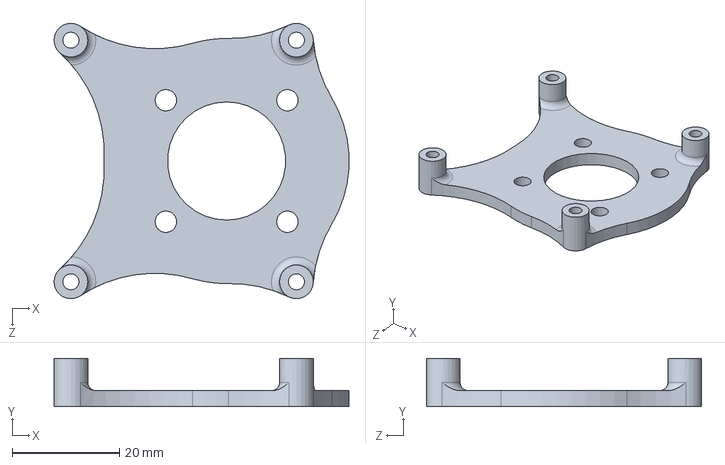
[picture p48: CAD file, 2026-08-31]
pancake cads/cpg_actuator/cpg_driver_mount.SLDPRT
54.9 x 9.00 x 51.3 mm
