deepak-kapa/PancakeActuator/CADs/DSPG/dspg_sun_stg1.SLDPRT

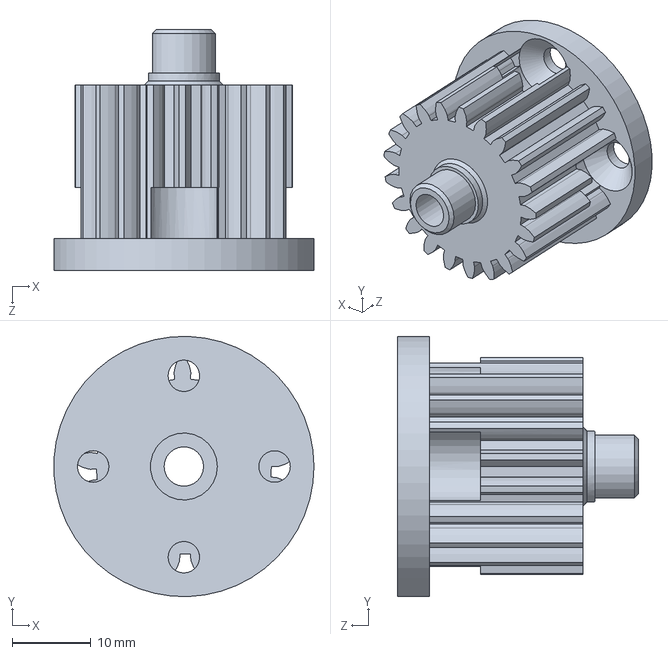
[picture p49: CAD file, 2026-04-23]
CADs/DSPG/dspg_sun_stg1.SLDPRT
33.0 x 33.0 x 30.5 mm
