deepak-kapa/PancakeActuator/CADs/WPG/wpg_small_ring.SLDPRT

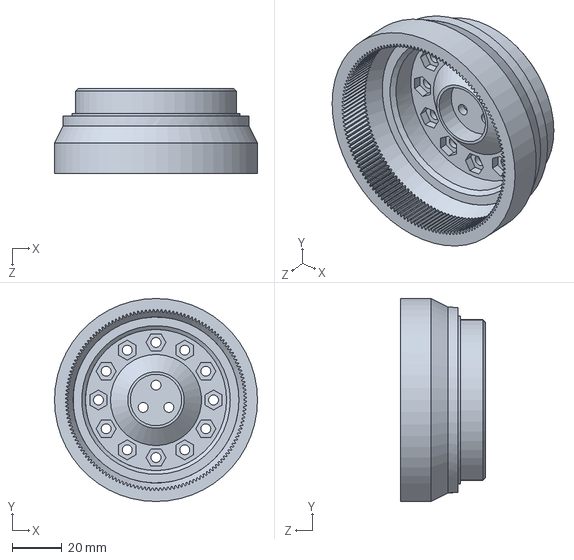
[picture p50: CAD file, 2026-04-23]
CADs/WPG/wpg_small_ring.SLDPRT
82.0 x 82.0 x 34.2 mm
