deepak-kapa/PancakeActuator/pancake cads/cpg_actuator_pancake/cpg_gearbox_casing_pancake.SLDPRT

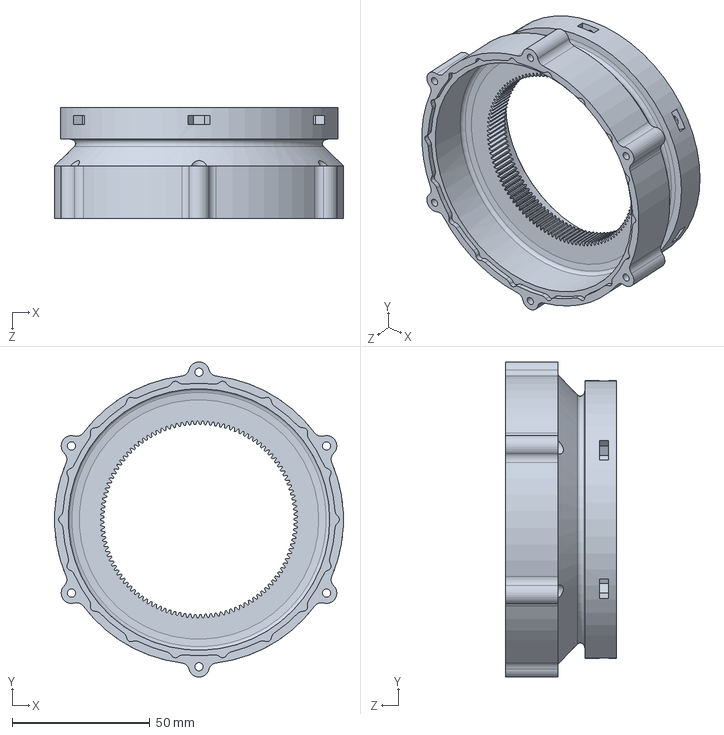
[picture p51: CAD file, 2026-04-23]
pancake cads/cpg_actuator_pancake/cpg_gearbox_casing_pancake.SLDPRT
105.0 x 114.4 x 40.4 mm
