deepak-kapa/PancakeActuator/CADs/WPG/wpg_motor.SLDPRT

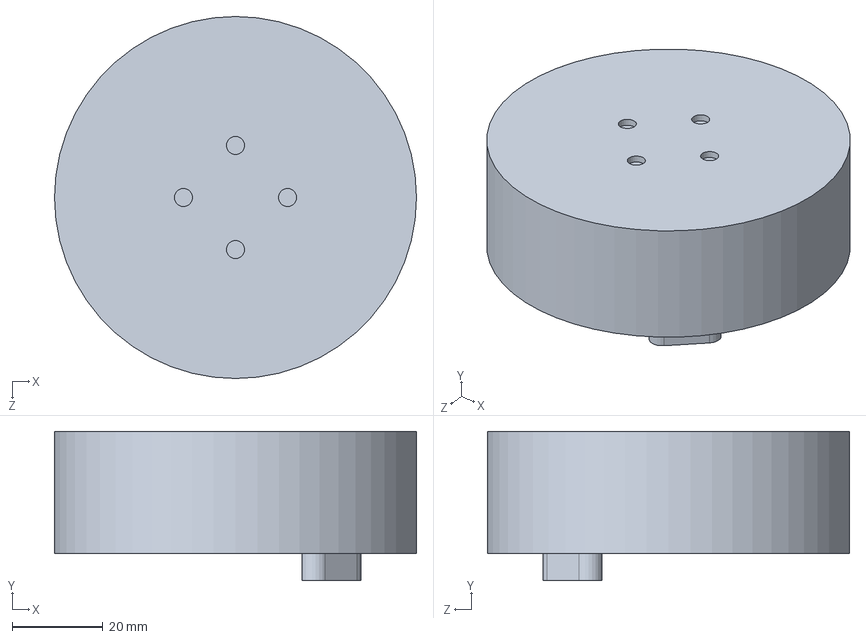
[picture p52: CAD file, 2026-04-23]
CADs/WPG/wpg_motor.SLDPRT
80.0 x 33.0 x 80.0 mm
