deepak-kapa/PancakeActuator/pancake cads/cpg_actuator/cpg_gearbox_casing.SLDPRT

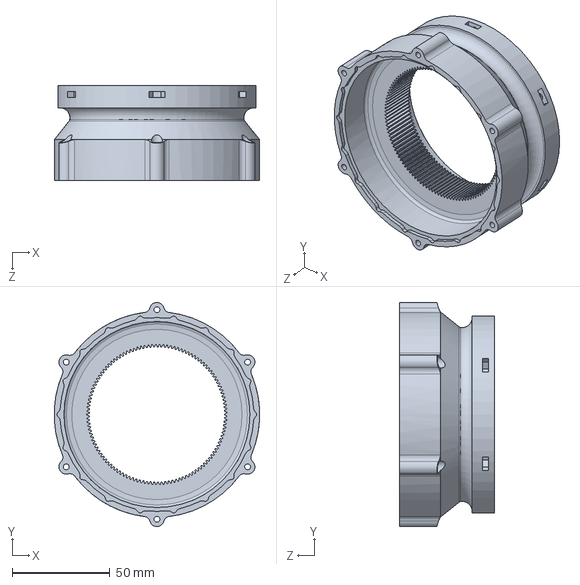
[picture p53: CAD file, 2026-08-31]
pancake cads/cpg_actuator/cpg_gearbox_casing.SLDPRT
104.9 x 114.4 x 48.6 mm
