deepak-kapa/PancakeActuator/CADs/DSPG/dspg_gearbox_casing_stg2.SLDPRT

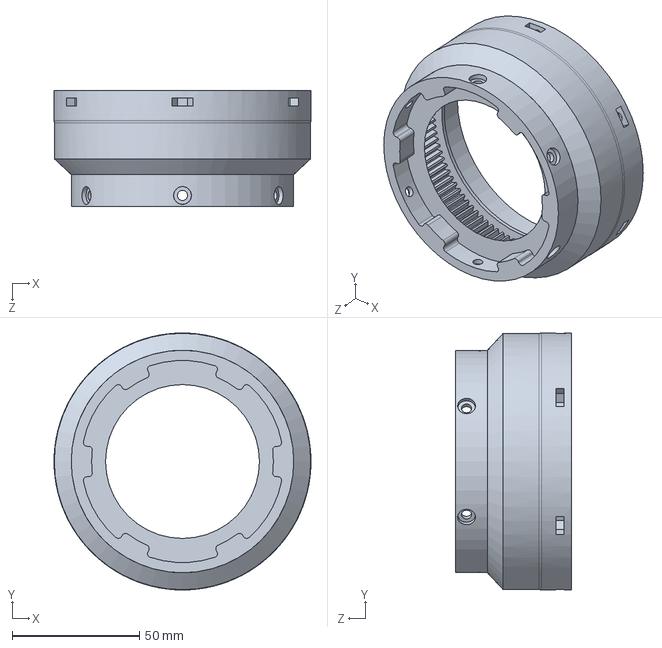
[picture p54: CAD file, 2026-04-23]
CADs/DSPG/dspg_gearbox_casing_stg2.SLDPRT
101.2 x 101.2 x 45.8 mm
