deepak-kapa/PancakeActuator/CADs/DSPG/dspg_motor_casing.SLDPRT

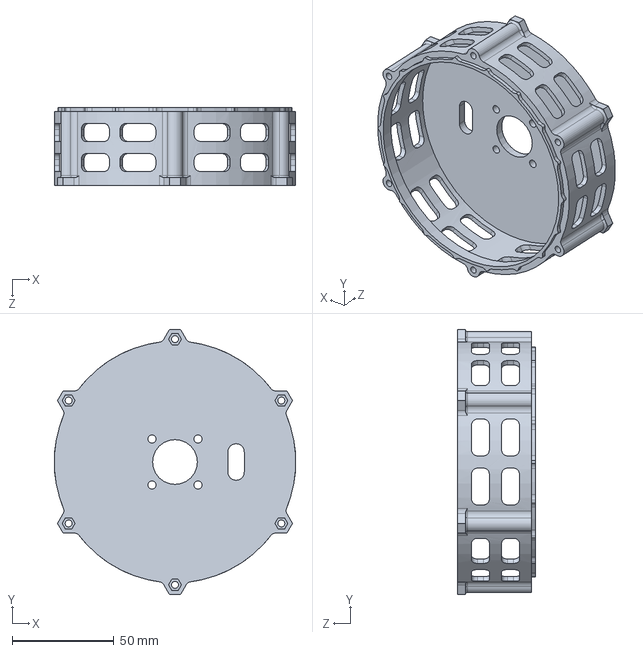
[picture p55: CAD file, 2026-04-23]
CADs/DSPG/dspg_motor_casing.SLDPRT
118.4 x 130.1 x 38.5 mm
