deepak-kapa/PancakeActuator/CADs/DSPG/dspg_sec_carrier_stg1.SLDPRT

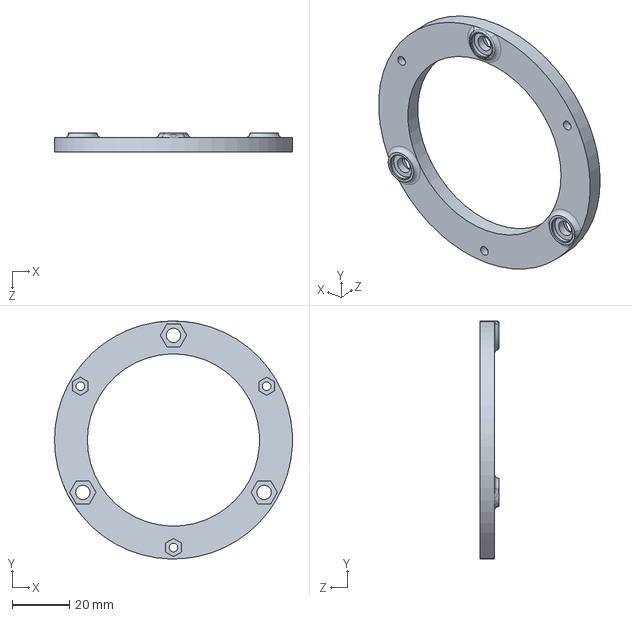
[picture p56: CAD file, 2026-04-23]
CADs/DSPG/dspg_sec_carrier_stg1.SLDPRT
83.2 x 83.2 x 6.50 mm
