deepak-kapa/PancakeActuator/CADs/DSPG/dspg_bearing_stg2.SLDPRT

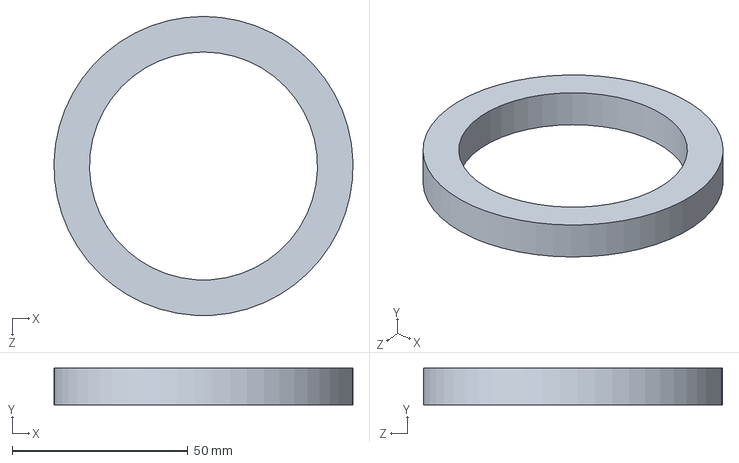
[picture p57: CAD file, 2026-04-23]
CADs/DSPG/dspg_bearing_stg2.SLDPRT
85.1 x 10.5 x 85.2 mm
