deepak-kapa/PancakeActuator/CADs/DSPG/bearing_retainer_stage1.SLDPRT

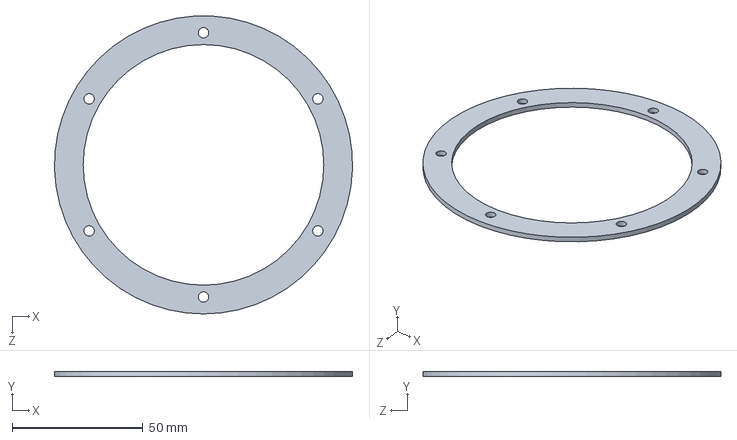
[picture p58: CAD file, 2026-04-23]
CADs/DSPG/bearing_retainer_stage1.SLDPRT
113.9 x 2.00 x 113.9 mm
