deepak-kapa/PancakeActuator/CADs/DSPG/dspg_carrier_stg2.SLDPRT

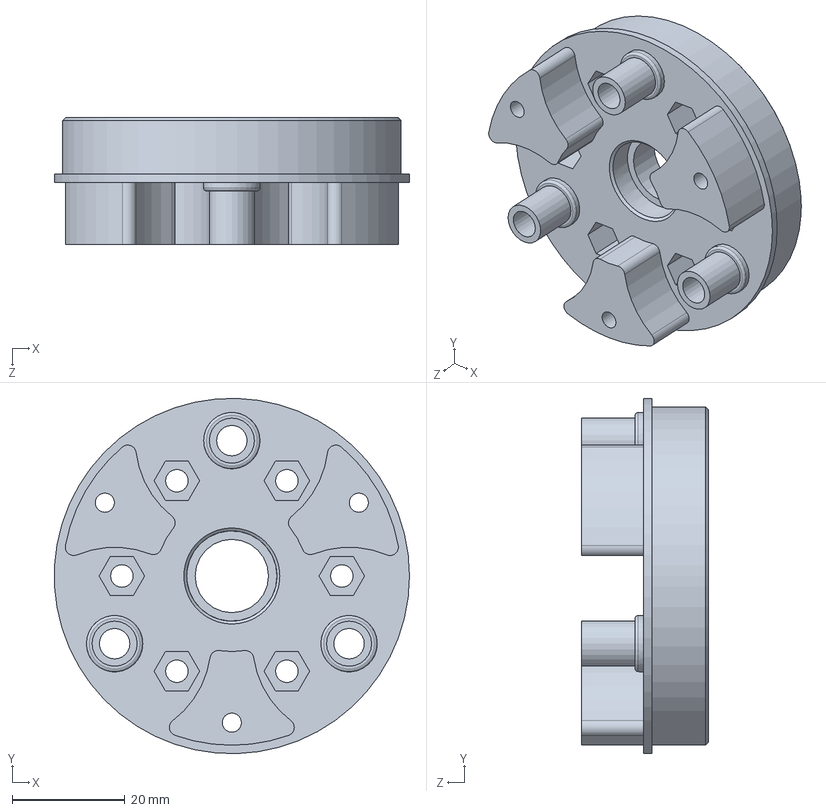
[picture p59: CAD file, 2026-04-23]
CADs/DSPG/dspg_carrier_stg2.SLDPRT
62.9 x 63.0 x 22.5 mm
