deepak-kapa/PancakeActuator/CADs/DSPG/dspg_sun_stg2.SLDPRT

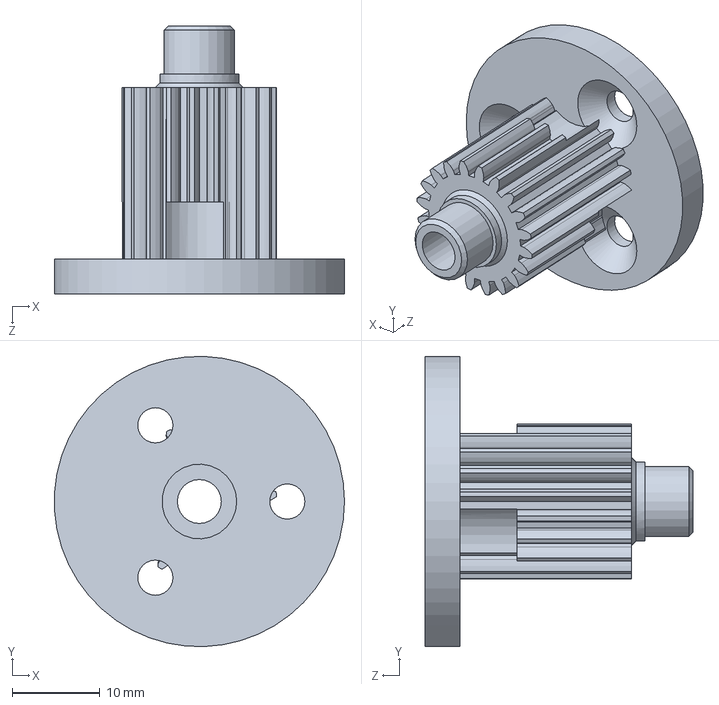
[picture p60: CAD file, 2026-04-23]
CADs/DSPG/dspg_sun_stg2.SLDPRT
33.0 x 33.0 x 30.5 mm
