deepak-kapa/PancakeActuator/pancake cads/cpg_actuator/cpg_actuator.SLDASM

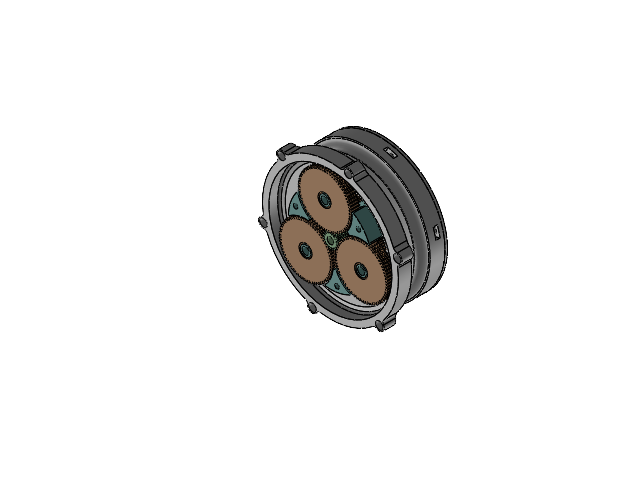
[picture p61: CAD file, 2026-08-31]
pancake cads/cpg_actuator/cpg_actuator.SLDASM
cpg_sec_carrier
cpg_carrier
cpg_planet x 3
cpg_motor
cpg_motor_casing
cpg_bearing
cpg_planet_bearing x 6
cpg_sun
cpg_sun_shaft_bearing
cpg_gearbox_casing
cpg_bearing_retainer
cpg_driver_mount
