deepak-kapa/PancakeActuator/pancake cads/cpg_actuator_pancake/iros_pancake_ci.SLDASM

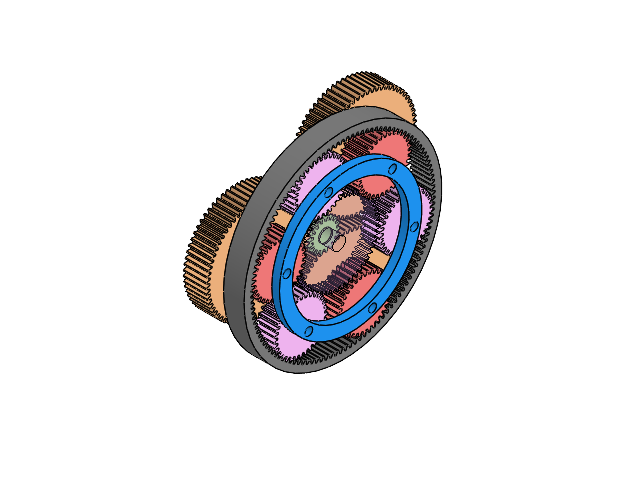
[picture p62: CAD file, 2026-04-23]
pancake cads/cpg_actuator_pancake/iros_pancake_ci.SLDASM
ISO - Spur gear 0.6M 51T 20PA 5FW ---S51A75H50L5.0N
ISO - Internal spur gear 0.6M 117T 20PA 8FW ---S117S77OD 1.0AF
ISO - Spur gear 0.6M 33T 20PA 8FW ---S33A75H50L5.0N x 3
ISO - Spur gear 0.6M 33T 20PA 7.5FW ---S33A75H50L5.0N x 3
ISO - Spur gear 0.6M 66T 20PA 9FW ---S66A75H50L5.0N x 3
carrier_iros
ISO - Spur gear 0.6M 18T 20PA 10FW ---S18A75H50L5.0N
