deepak-kapa/PancakeActuator/CADs/DSPG/dspg_actuator.SLDASM

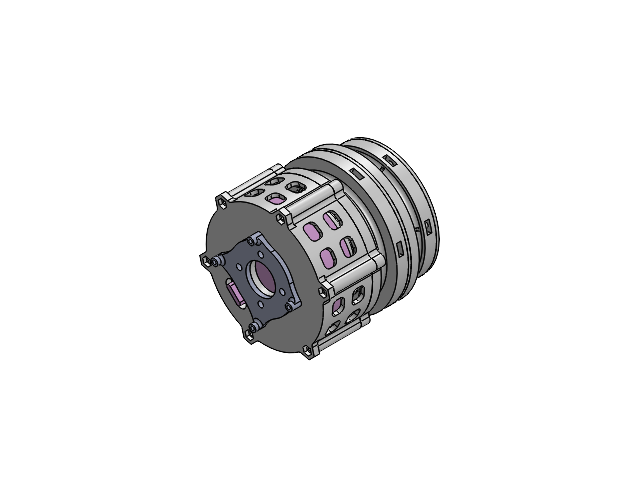
[picture p63: CAD file, 2026-04-23]
CADs/DSPG/dspg_actuator.SLDASM
dspg_carrier_stg1
dspg_gearbox_casing_stg1
dspg_motor
dspg_motor_casing
dspg_planet_stg1 x 3
dspg_sec_carrier_stg1
dspg_sun_stg1
dspg_bearing_stg1
dspg_planet_bearing x 12
dspg_sun_shaft_bearing x 2
dspg_carrier_stg2
dspg_sec_carrier_stg2
dspg_planet_stg2 x 3
dspg_bearing_stg2
dspg_gearbox_casing_stg2_new
bearing_retainer_stage1
bearing_retainer_stage2
dspg_driver_mount
