deepak-kapa/PancakeActuator/CADs/WPG/wpg_actuator/wpg_actuator/wpg_actuator.SLDASM

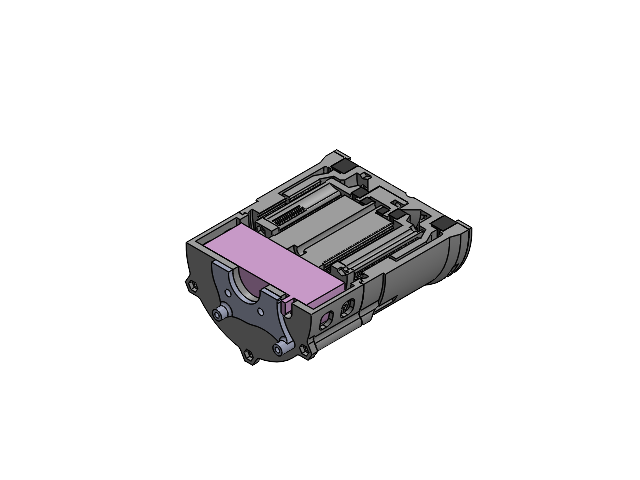
[picture p64: CAD file, 2026-04-23]
CADs/WPG/wpg_actuator/wpg_actuator/wpg_actuator.SLDASM
wpg_gearbox_casing
wpg_motor_casing
wpg_small_ring
wpg_bearing
wpg_planet x 6
wpg_sec_carrier
wpg_carrier
wpg_motor
wpg_sun
wpg_sun_shaft_bearing
wpg_carrier_ring_small_bearing
wpg_small_ring_bearing_shaft
wpg_planet_bearing x 12
wpg_driver_mount
wpg_bearing_retainer
