deepak-kapa/PancakeActuator/pancake cads/cpg_actuator_pancake/cpg_actuator_pancake.SLDASM

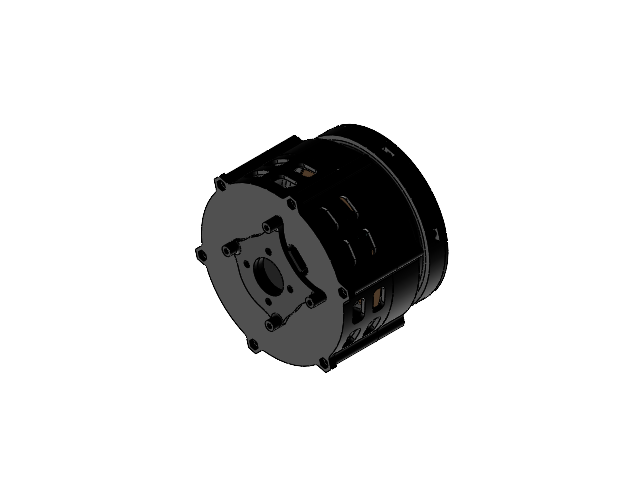
[picture p65: CAD file, 2026-04-23]
pancake cads/cpg_actuator_pancake/cpg_actuator_pancake.SLDASM
cpg_sec_carrier_pancake
cpg_carrier_pancake
cpg_planet_pancake x 3
cpg_motor_pancake
cpg_motor_casing_pancake
cpg_bearing_pancake
cpg_planet_bearing_pancake x 12
cpg_sun_pancake
cpg_sun_shaft_bearing_pancake x 2
cpg_gearbox_casing_pancake
cpg_bearing_retainer_pancake
cpg_driver_mount_pancake
cpg_planet_pancake - Copy x 3
cpg_planet_pancake - Copy - Copy
