deepak-kapa/PancakeActuator/(list of files, cad)

Other CAD files:
pancake cads/cpg_actuator_pancake/cpg_motor_casing_pancake.SLDPRT
CADs/WPG/wpg_actuator/wpg_actuator/wpg_planet.SLDPRT
CADs/WPG/wpg_sun_shaft_bearing.SLDPRT
CADs/SSPG/sspg_planet_bearing.SLDPRT
CADs/WPG/wpg_actuator/wpg_actuator/wpg_carrier_ring_small_bearing.SLDPRT
CADs/SSPG/sspg_motor.SLDPRT
CADs/WPG/wpg_carrier_ring_small_bearing.SLDPRT
pancake cads/cpg_actuator/cpg_sun_shaft_bearing.SLDPRT
pancake cads/cpg_actuator_pancake/cpg_motor_pancake.SLDPRT
CADs/WPG/wpg_planet_bearing.SLDPRT
CADs/WPG/wpg_actuator/wpg_actuator/wpg_planet_bearing.SLDPRT
CADs/SSPG/sspg_sun_shaft_bearing.SLDPRT
pancake cads/cpg_actuator/cpg_planet_bearing.SLDPRT
CADs/DSPG/dspg_planet_bearing.SLDPRT
pancake cads/cpg_actuator_pancake/cpg_bearing_retainer_pancake.SLDPRT
CADs/WPG/wpg_planet.SLDPRT
CADs/DSPG/dspg_sun_shaft_bearing.SLDPRT
CADs/WPG/wpg_actuator/wpg_actuator/wpg_sun_shaft_bearing.SLDPRT
pancake cads/cpg_actuator_pancake/cpg_bearing_pancake.SLDPRT
pancake cads/cpg_actuator_pancake/cpg_driver_mount_pancake.SLDPRT
pancake cads/cpg_actuator_pancake/cpg_planet_pancake - Copy - Copy.SLDPRT
pancake cads/cpg_actuator_pancake/cpg_planet_pancake - Copy.SLDPRT
