deepak-kapa/PancakeActuator/plots/hardware_results/no_load_backlash/cpg_pancake2_sine_vel_2.500tps_2.00s.csv

time_s | odrive_pos_rad | output_pos_rad | diff_rad
3.867094 | 6.372127 | 4.877292 | 1.494835
3.868413 | 6.372526 | 4.877292 | 1.495234
3.871108 | 6.371871 | 4.877292 | 1.494579
3.874677 | 6.371872 | 4.876908 | 1.494963
3.877671 | 6.372200 | 4.877292 | 1.494908
3.880474 | 6.372555 | 4.877292 | 1.495264
3.884027 | 6.373182 | 4.877292 | 1.495890
3.888417 | 6.373719 | 4.877292 | 1.496427
3.890868 | 6.374391 | 4.877292 | 1.497099
3.894510 | 6.375739 | 4.877292 | 1.498448
3.897960 | 6.379197 | 4.876908 | 1.502289
3.901284 | 6.381702 | 4.876908 | 1.504794
3.904328 | 6.383848 | 4.876525 | 1.507323
3.908371 | 6.385285 | 4.876525 | 1.508760
3.910460 | 6.386886 | 4.875758 | 1.511128
3.913773 | 6.389070 | 4.876525 | 1.512546
3.918695 | 6.394340 | 4.875758 | 1.518583
3.920449 | 6.396120 | 4.875758 | 1.520362
3.923572 | 6.401826 | 4.875374 | 1.526452
3.928430 | 6.406875 | 4.874991 | 1.531884
3.930555 | 6.409123 | 4.875374 | 1.533749
3.934098 | 6.413480 | 4.874607 | 1.538873
3.938345 | 6.430527 | 4.873457 | 1.557070
3.940641 | 6.438358 | 4.872690 | 1.565668
3.943538 | 6.453310 | 4.871539 | 1.581771
3.946612 | 6.464608 | 4.871156 | 1.593453
3.950020 | 6.482134 | 4.869622 | 1.612512
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
