deepak-kapa/PancakeActuator/plots/hardware_results/no_load_backlash/cpg_pancake_sine_vel_2.500tps_2.00s.csv

time_s | odrive_pos_rad | output_pos_rad | diff_rad | odrive_disp_rad | output_disp_rad | motor_on_output_side_rad | backlash_rad
3.867094 | 6.372127 | 4.877292 | 1.494835 | -4.827198999999999 | -0.345529 | -0.34479992857142855 | 0.0007290714285714262
3.868413 | 6.372526 | 4.877292 | 1.495234 | -4.8267999999999995 | -0.345529 | -0.34477142857142856 | 0.000757571428571413
3.871108 | 6.371871 | 4.877292 | 1.494579 | -4.827455 | -0.345529 | -0.34481821428571424 | 0.0007107857142857332
3.874677 | 6.371872 | 4.876908 | 1.494963 | -4.8274539999999995 | -0.3451450000000005 | -0.3448181428571428 | 0.00032685714285768386
3.877671 | 6.3722 | 4.877292 | 1.494908 | -4.827125999999999 | -0.345529 | -0.34479471428571423 | 0.0007342857142857429
3.880474 | 6.372555 | 4.877292 | 1.495264 | -4.826770999999999 | -0.345529 | -0.34476935714285706 | 0.000759642857142917
3.884027 | 6.373182 | 4.877292 | 1.49589 | -4.826143999999999 | -0.345529 | -0.3447245714285714 | 0.0008044285714285948
3.888417 | 6.373719 | 4.877292 | 1.496427 | -4.825606999999999 | -0.345529 | -0.3446862142857142 | 0.0008427857142857542
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
