deepak-kapa/PancakeActuator/plots/hardware_results/transmission_stiffness/transmission_stiffness_pancake_cpg.csv

time_s | encoder_pos_rad | output_torque_Nm
0.021667 | -0.227921045 | 0.080000
0.032433 | -0.227921045 | 0.120000
0.043093 | -0.227921045 | 0.160000
0.053733 | -0.227921045 | 0.200000
0.064486 | -0.227921045 | 0.240000
0.075213 | -0.227921045 | 0.280000
0.085888 | -0.227921045 | 0.320000
0.096625 | -0.227921045 | 0.360000
0.107326 | -0.227921045 | 0.400000
0.117872 | -0.225276464 | 0.440000
0.128501 | -0.225276464 | 0.480000
0.139141 | -0.225276464 | 0.520000
0.149823 | -0.225276464 | 0.560000
0.160503 | -0.225276464 | 0.600000
0.171171 | -0.225276464 | 0.640000
0.181787 | -0.225276464 | 0.680000
0.192513 | -0.225276464 | 0.720000
0.203166 | -0.225276464 | 0.760000
0.213839 | -0.225276464 | 0.800000
0.224526 | -0.220508427 | 0.840000
0.235171 | -0.220508427 | 0.880000
0.245849 | -0.220508427 | 0.920000
0.256659 | -0.220508427 | 0.960000
0.267390 | -0.220508427 | 1.000000
0.277961 | -0.220508427 | 1.040000
0.288704 | -0.220508427 | 1.080000
0.299394 | -0.220508427 | 1.120000
0.310023 | -0.220508427 | 1.160000
0.320955 | -0.212497535 | 1.200000
0.331595 | -0.212497535 | 1.240000
0.342355 | -0.212497535 | 1.280000
0.352977 | -0.212497535 | 1.320000
0.363513 | -0.212497535 | 1.360000
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
