deepak-kapa/PancakeActuator/Experimental_Data/PANCAKE_NEW_30AUG/Data_Without_Dummy_sun_and_without_planets/Stiffness_Test/stiffness_20260910_005136.csv

time_s | encoder_pos_rad | output_torque_Nm | cycle
0.012214 | 0.000479369 | 0.000000 | 1
0.026063 | -0.000479369 | 0.015000 | 1
0.039906 | 0.000766990 | 0.030000 | 1
0.053791 | 0.000575243 | 0.045000 | 1
0.067681 | 0.000191748 | 0.060000 | 1
0.082201 | 0.000191748 | 0.075000 | 1
0.095465 | -0.000095874 | 0.090000 | 1
0.109646 | 0.000191748 | 0.105000 | 1
0.123507 | -0.000287621 | 0.120000 | 1
0.137378 | 0.000191748 | 0.135000 | 1
0.151550 | -0.000383495 | 0.150000 | 1
0.165323 | -0.000095874 | 0.165000 | 1
0.179114 | -0.000095874 | 0.180000 | 1
0.193387 | -0.000383495 | 0.195000 | 1
0.206781 | -0.000383495 | 0.210000 | 1
0.220696 | -0.000095874 | 0.225000 | 1
0.235441 | -0.000383495 | 0.240000 | 1
0.248764 | -0.000862864 | 0.255000 | 1
0.262326 | -0.000671117 | 0.270000 | 1
0.276233 | -0.000766990 | 0.285000 | 1
0.289793 | -0.000862864 | 0.300000 | 1
0.303426 | -0.001054612 | 0.315000 | 1
0.317779 | -0.000862864 | 0.330000 | 1
0.331040 | -0.001246359 | 0.345000 | 1
0.344591 | -0.001150486 | 0.360000 | 1
0.358338 | -0.001246359 | 0.375000 | 1
0.371924 | -0.001917476 | 0.390000 | 1
0.385853 | -0.001533981 | 0.405000 | 1
0.400136 | -0.001725728 | 0.420000 | 1
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
