deepak-kapa/PancakeActuator/Experimental_Data/PANCAKE_NEW_30AUG/Data_Without_Dummy_sun_and_without_planets/Stiffness_Test/stiffness_20260910_005525.csv

time_s | encoder_pos_rad | output_torque_Nm | cycle
0.008262 | -0.000479369 | 0.000000 | 1
0.021700 | -0.001438107 | 0.012000 | 1
0.035487 | 0.000383495 | 0.024000 | 1
0.049375 | -0.000479369 | 0.036000 | 1
0.063296 | -0.000287621 | 0.048000 | 1
0.078732 | -0.000095874 | 0.060000 | 1
0.092317 | -0.000958738 | 0.072000 | 1
0.105691 | -0.000575243 | 0.084000 | 1
0.120621 | -0.000287621 | 0.096000 | 1
0.134000 | -0.000191748 | 0.108000 | 1
0.147880 | -0.000575243 | 0.120000 | 1
0.162505 | -0.000383495 | 0.132000 | 1
0.175879 | -0.001054612 | 0.144000 | 1
0.189458 | -0.000862864 | 0.156000 | 1
0.203758 | -0.000479369 | 0.168000 | 1
0.217610 | -0.000479369 | 0.180000 | 1
0.230834 | -0.000287621 | 0.192000 | 1
0.244770 | -0.000479369 | 0.204000 | 1
0.258288 | -0.000479369 | 0.216000 | 1
0.272060 | -0.000383495 | 0.228000 | 1
0.286175 | -0.000575243 | 0.240000 | 1
0.300713 | -0.000287621 | 0.252000 | 1
0.314173 | -0.001054612 | 0.264000 | 1
0.328017 | 0.000000000 | 0.276000 | 1
0.341851 | -0.000766990 | 0.288000 | 1
0.356634 | -0.000095874 | 0.300000 | 1
0.370282 | -0.000671117 | 0.312000 | 1
0.384304 | -0.000383495 | 0.324000 | 1
0.398000 | -0.000383495 | 0.336000 | 1
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
