deepak-kapa/PancakeActuator/Experimental_Data/PANCAKE_NEW_30AUG/Data_Without_Dummy_sun_and_without_planets/Stiffness_Test/stiffness_20260910_010118.csv

time_s | encoder_pos_rad | output_torque_Nm | cycle
0.010036 | -0.000575243 | 0.000000 | 1
0.023684 | -0.000191748 | 0.012000 | 1
0.037508 | -0.000479369 | 0.024000 | 1
0.051551 | -0.000191748 | 0.036000 | 1
0.065722 | 0.000000000 | 0.048000 | 1
0.080128 | -0.000575243 | 0.060000 | 1
0.093808 | 0.000095874 | 0.072000 | 1
0.108019 | -0.000095874 | 0.084000 | 1
0.122105 | 0.000095874 | 0.096000 | 1
0.136089 | -0.000479369 | 0.108000 | 1
0.150043 | -0.000191748 | 0.120000 | 1
0.164855 | 0.000000000 | 0.132000 | 1
0.178658 | 0.000000000 | 0.144000 | 1
0.192616 | 0.000191748 | 0.156000 | 1
0.206275 | 0.000191748 | 0.168000 | 1
0.220527 | 0.000191748 | 0.180000 | 1
0.233946 | 0.000575243 | 0.192000 | 1
0.248307 | -0.000191748 | 0.204000 | 1
0.262407 | 0.000479369 | 0.216000 | 1
0.275785 | 0.000287621 | 0.228000 | 1
0.289537 | 0.000862864 | 0.240000 | 1
0.303507 | 0.000671117 | 0.252000 | 1
0.317541 | -0.000095874 | 0.264000 | 1
0.331305 | 0.000575243 | 0.276000 | 1
0.345021 | 0.000862864 | 0.288000 | 1
0.359061 | 0.000479369 | 0.300000 | 1
0.373165 | 0.001054612 | 0.312000 | 1
0.386856 | 0.000958738 | 0.324000 | 1
0.400592 | 0.000383495 | 0.336000 | 1
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
