deepak-kapa/PancakeActuator/plots/hardware_results/pancake/CPG_PANCAKE_M6C12_14/Stiffness Test/stiffness_20251223_173844.csv

time_s | encoder_pos_rad | output_torque_Nm
0.074876 | 0.001029145 | 0.280000
0.085461 | 0.001029145 | 0.320000
0.096112 | 0.001029145 | 0.360000
0.106810 | 0.001029145 | 0.400000
0.117464 | 0.001029145 | 0.440000
0.128083 | 0.001029145 | 0.480000
0.138758 | 0.001029145 | 0.520000
0.149396 | 0.001029145 | 0.560000
0.160135 | 0.001029145 | 0.600000
0.170704 | 0.002168021 | 0.640000
0.181358 | 0.002168021 | 0.680000
0.192027 | 0.002168021 | 0.720000
0.202775 | 0.002168021 | 0.760000
0.213406 | 0.002168021 | 0.800000
0.224045 | 0.002168021 | 0.840000
0.234972 | 0.002168021 | 0.880000
0.245627 | 0.002168021 | 0.920000
0.256311 | 0.002168021 | 0.960000
0.267697 | 0.002168021 | 1.000000
0.278368 | 0.010267110 | 1.040000
0.289139 | 0.010267110 | 1.080000
0.299777 | 0.010267110 | 1.120000
0.310478 | 0.010267110 | 1.160000
0.321224 | 0.010267110 | 1.200000
0.331858 | 0.010267110 | 1.240000
0.342520 | 0.010267110 | 1.280000
0.353270 | 0.010267110 | 1.320000
0.363942 | 0.010267110 | 1.360000
0.374586 | 0.027650603 | 1.400000
0.385382 | 0.027650603 | 1.440000
0.396033 | 0.027650603 | 1.480000
0.406735 | 0.027650603 | 1.520000
0.417432 | 0.027650603 | 1.560000
0.428082 | 0.027650603 | 1.600000
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
