deepak-kapa/PancakeActuator/plots/hardware_results/pancake/CPG_PANCAKE_M6C12_14/Stiffness Test/stiffness_20251223_174012.csv

time_s | encoder_pos_rad | output_torque_Nm
0.096133 | -0.232135373 | 0.360000
0.106847 | -0.232135373 | 0.400000
0.117620 | -0.232135373 | 0.440000
0.128386 | -0.232135373 | 0.480000
0.139073 | -0.232135373 | 0.520000
0.149803 | -0.232135373 | 0.560000
0.160493 | -0.232135373 | 0.600000
0.171021 | -0.232135373 | 0.640000
0.181582 | -0.232135373 | 0.680000
0.192822 | -0.232135373 | 0.720000
0.203666 | -0.224767321 | 0.760000
0.214325 | -0.224767321 | 0.800000
0.225037 | -0.224767321 | 0.840000
0.235753 | -0.224767321 | 0.880000
0.246398 | -0.224767321 | 0.920000
0.257154 | -0.224767321 | 0.960000
0.267966 | -0.224767321 | 1.000000
0.278615 | -0.224767321 | 1.040000
0.289367 | -0.224767321 | 1.080000
0.300007 | -0.219640320 | 1.120000
0.310613 | -0.219640320 | 1.160000
0.321245 | -0.219640320 | 1.200000
0.331967 | -0.219640320 | 1.240000
0.342657 | -0.219640320 | 1.280000
0.353364 | -0.219640320 | 1.320000
0.364063 | -0.219640320 | 1.360000
0.374810 | -0.219640320 | 1.400000
0.385639 | -0.219640320 | 1.440000
0.396465 | -0.193996700 | 1.480000
0.407084 | -0.193996700 | 1.520000
0.417852 | -0.193996700 | 1.560000
0.428619 | -0.193996700 | 1.600000
0.439284 | -0.193996700 | 1.640000
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
