deepak-kapa/PancakeActuator/Experimental_Data/CPG_NEW/Backdrivability test/backdrive_0to-2.0Nm_40s_t1_opp.csv

time_s | load_velocity_rpm | load_torque_nm | load_pos_native_deg | load_pos_integrated_deg | test_velocity_rpm | test_torque_nm | test_pos_native_deg | test_pos_integrated_deg | static_torque_cell_nm | cmd_test_torque_nm | load_voltage_v | test_voltage_v | load_temp_c | test_temp_c
0.014 | 0.03 | 0.000 | 0.0000 | 0.0018 | -1.92 | 0.000 | 0.0000 | -0.1151 | nan | -0.001 | 48.01 | 48.28 | 31.8 | nan
0.022 | -0.02 | 0.000 | 0.0000 | 0.0005 | -1.92 | 0.000 | 0.0000 | -0.2301 | 0.000 | -0.001 | 48.01 | 48.28 | 31.8 | nan
0.031 | -0.02 | 0.000 | 0.0000 | -0.0005 | 1.75 | 0.015 | 0.0989 | -0.1253 | 0.000 | -0.001 | 48.01 | 48.28 | 31.8 | nan
0.038 | 0.05 | 0.000 | 0.0000 | 0.0023 | 1.75 | 0.015 | 0.0989 | -0.0204 | 0.000 | -0.001 | 48.01 | 48.28 | 31.8 | nan
0.052 | -0.04 | 0.000 | 0.0000 | -0.0002 | -1.70 | 0.015 | 0.0220 | -0.1226 | 0.000 | -0.002 | 48.01 | 48.28 | 31.7 | nan
0.059 | -0.06 | 0.000 | 0.0000 | -0.0040 | -1.70 | 0.015 | 0.0220 | -0.2247 | 0.000 | -0.002 | 48.02 | 48.28 | 31.7 | nan
0.070 | 0.02 | 0.000 | 0.0000 | -0.0030 | -0.46 | 0.005 | 0.0549 | -0.2524 | 0.000 | -0.003 | 48.00 | 48.31 | 31.7 | nan
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
