deepak-kapa/PancakeActuator/Experimental_Data/CPG_NEW/Backdrivability test/backdrive_0to-2.0Nm_40s_t2_opp.csv

time_s | load_velocity_rpm | load_torque_nm | load_pos_native_deg | load_pos_integrated_deg | test_velocity_rpm | test_torque_nm | test_pos_native_deg | test_pos_integrated_deg | static_torque_cell_nm | cmd_test_torque_nm | load_voltage_v | test_voltage_v | load_temp_c | test_temp_c
0.018 | 0.08 | 0.000 | 0.0000 | 0.0049 | -6.43 | 0.000 | 0.0000 | -0.3856 | 0.000 | -0.001 | 48.01 | 48.28 | 31.6 | nan
0.027 | 0.09 | 0.000 | 0.0126 | 0.0104 | -6.35 | 0.005 | 0.0220 | -0.7665 | 0.000 | -0.001 | 48.02 | 48.28 | 31.6 | nan
0.034 | -0.00 | 0.000 | 0.0000 | 0.0102 | -6.35 | 0.005 | 0.0220 | -1.1473 | 0.000 | -0.001 | 48.01 | 48.28 | 31.6 | nan
0.044 | 0.04 | 0.000 | 0.0126 | 0.0128 | -1.28 | -0.006 | 0.1868 | -1.2241 | 0.000 | -0.002 | 48.02 | 48.28 | 31.6 | nan
0.050 | -0.12 | 0.000 | 0.0000 | 0.0058 | -1.28 | -0.006 | 0.1868 | -1.3010 | 0.000 | -0.002 | 48.02 | 48.28 | 31.6 | nan
0.062 | -0.05 | 0.000 | 0.0000 | 0.0028 | -1.28 | -0.006 | 0.1868 | -1.3778 | 0.000 | -0.003 | 48.02 | 48.28 | 31.6 | nan
0.070 | -0.04 | 0.000 | 0.0126 | 0.0005 | -3.31 | -0.001 | 0.0879 | -1.5766 | 0.000 | -0.003 | 48.01 | 48.31 | 31.6 | nan
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
