deepak-kapa/PancakeActuator/Experimental_Data/CPG_NEW/Backdrivability test/backdrive_0to-2.0Nm_40s_t3_opp.csv

time_s | load_velocity_rpm | load_torque_nm | load_pos_native_deg | load_pos_integrated_deg | test_velocity_rpm | test_torque_nm | test_pos_native_deg | test_pos_integrated_deg | static_torque_cell_nm | cmd_test_torque_nm | load_voltage_v | test_voltage_v | load_temp_c | test_temp_c
0.020 | 0.06 | 0.000 | 0.0000 | 0.0036 | 2.93 | 0.000 | 0.0000 | 0.1759 | 0.010 | -0.001 | 48.02 | 48.28 | 31.6 | nan
0.027 | 0.19 | 0.000 | 0.0000 | 0.0152 | 2.93 | 0.000 | 0.0000 | 0.3517 | 0.010 | -0.001 | 48.01 | 48.28 | 31.6 | nan
0.035 | 0.07 | 0.000 | 0.0000 | 0.0195 | 10.48 | 0.003 | 0.0989 | 0.9806 | 0.010 | -0.001 | 48.01 | 48.28 | 31.6 | nan
0.045 | -0.00 | 0.000 | 0.0126 | 0.0194 | 10.48 | 0.003 | 0.0989 | 1.6094 | 0.010 | -0.002 | 48.01 | 48.28 | 31.6 | nan
0.054 | 0.01 | 0.000 | 0.0000 | 0.0200 | 2.92 | -0.001 | -0.1099 | 1.7849 | 0.010 | -0.002 | 48.01 | 48.28 | 31.6 | nan
0.065 | 0.04 | 0.000 | 0.0000 | 0.0227 | -6.13 | -0.006 | -0.1758 | 1.4170 | 0.010 | -0.003 | 48.01 | 48.31 | 31.6 | nan
0.072 | -0.09 | 0.000 | 0.0000 | 0.0170 | -6.13 | -0.006 | -0.1758 | 1.0490 | 0.010 | -0.003 | 48.01 | 48.31 | 31.6 | nan
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
