deepak-kapa/PancakeActuator/Experimental_Data/CPG_NEW/Backdrivability test/backdrive_0to-2.0Nm_40s_t4_opp.csv

time_s | load_velocity_rpm | load_torque_nm | load_pos_native_deg | load_pos_integrated_deg | test_velocity_rpm | test_torque_nm | test_pos_native_deg | test_pos_integrated_deg | static_torque_cell_nm | cmd_test_torque_nm | load_voltage_v | test_voltage_v | load_temp_c | test_temp_c
0.015 | -0.06 | 0.000 | 0.0000 | -0.0038 | -4.78 | 0.000 | 0.0000 | -0.2867 | nan | -0.001 | 48.02 | 48.28 | 31.5 | nan
0.021 | 0.00 | 0.000 | 0.0126 | -0.0035 | -4.78 | 0.000 | 0.0000 | -0.5734 | nan | -0.001 | 48.02 | 48.28 | 31.5 | nan
0.031 | 0.09 | 0.000 | 0.0126 | 0.0018 | 4.82 | -0.001 | 0.1978 | -0.2845 | nan | -0.001 | 48.00 | 48.28 | 31.5 | nan
0.041 | 0.01 | 0.000 | 0.0126 | 0.0024 | 4.82 | -0.001 | 0.1978 | 0.0045 | 0.000 | -0.001 | 48.02 | 48.28 | 31.5 | nan
0.050 | -0.03 | 0.000 | 0.0126 | 0.0006 | -2.28 | 0.004 | -0.0110 | -0.1322 | 0.000 | -0.002 | 48.01 | 48.28 | 31.5 | nan
0.058 | 0.01 | 0.000 | 0.0126 | 0.0012 | -2.28 | 0.004 | -0.0110 | -0.2690 | 0.000 | -0.002 | 48.01 | 48.28 | 31.5 | nan
0.069 | 0.01 | 0.000 | 0.0126 | 0.0019 | -0.14 | -0.020 | 0.0110 | -0.2775 | 0.000 | -0.003 | 48.02 | 48.28 | 31.5 | nan
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
