deepak-kapa/PancakeActuator/Experimental_Data/CPG_NEW/Backdrivability test/backdrive_0to-2.0Nm_40s_t5_opp.csv

time_s | load_velocity_rpm | load_torque_nm | load_pos_native_deg | load_pos_integrated_deg | test_velocity_rpm | test_torque_nm | test_pos_native_deg | test_pos_integrated_deg | static_torque_cell_nm | cmd_test_torque_nm | load_voltage_v | test_voltage_v | load_temp_c | test_temp_c
0.014 | -0.00 | 0.000 | 0.0000 | -0.0002 | 4.24 | 0.000 | 0.0000 | 0.2543 | nan | -0.001 | 48.01 | 48.28 | 31.5 | nan
0.021 | -0.15 | 0.000 | -0.0126 | -0.0094 | 4.24 | 0.000 | 0.0000 | 0.5086 | nan | -0.001 | 48.01 | 48.28 | 31.5 | nan
0.032 | 0.08 | 0.000 | 0.0000 | -0.0047 | -2.36 | 0.002 | -0.1208 | 0.3670 | 0.000 | -0.001 | 48.02 | 48.28 | 31.5 | nan
0.039 | -0.06 | 0.000 | 0.0000 | -0.0081 | -2.36 | 0.002 | -0.1208 | 0.2254 | 0.000 | -0.001 | 48.01 | 48.28 | 31.5 | nan
0.050 | 0.22 | 0.000 | -0.0126 | 0.0049 | -0.41 | -0.002 | -0.1099 | 0.2008 | 0.000 | -0.002 | 48.02 | 48.28 | 31.5 | nan
0.056 | 0.01 | 0.000 | 0.0000 | 0.0056 | -0.41 | -0.002 | -0.1099 | 0.1763 | 0.000 | -0.002 | 48.02 | 48.28 | 31.5 | nan
0.068 | 0.06 | 0.000 | 0.0000 | 0.0093 | 3.10 | -0.019 | 0.0110 | 0.3626 | 0.000 | -0.003 | 48.02 | 48.28 | 31.5 | nan
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
