deepak-kapa/PancakeActuator/Experimental_Data/CPG_NEW/Backdrivability test/backdrive_0to2.0Nm_40s_t1.csv

time_s | load_velocity_rpm | load_torque_nm | load_pos_native_deg | load_pos_integrated_deg | test_velocity_rpm | test_torque_nm | test_pos_native_deg | test_pos_integrated_deg | static_torque_cell_nm | cmd_test_torque_nm | load_voltage_v | test_voltage_v | load_temp_c | test_temp_c
0.019 | 0.11 | 0.000 | 0.0000 | 0.0064 | -4.03 | 0.000 | 0.0000 | -0.2418 | 0.040 | 0.001 | 48.01 | 48.28 | 31.9 | nan
0.027 | 0.08 | 0.000 | -0.0014 | 0.0109 | -4.03 | 0.000 | 0.0000 | -0.4837 | 0.040 | 0.001 | 48.02 | 48.28 | 31.9 | nan
0.040 | 0.01 | 0.000 | 0.0002 | 0.0116 | -2.95 | -0.006 | 0.0824 | -0.6608 | 0.040 | 0.001 | 48.01 | 48.28 | 31.9 | nan
0.053 | 0.00 | 0.000 | -0.0016 | 0.0117 | 1.73 | 0.015 | 0.1758 | -0.5568 | 0.040 | 0.002 | 48.00 | 48.28 | 31.9 | nan
0.070 | -0.00 | 0.000 | -0.0004 | 0.0115 | -2.03 | -0.005 | 0.1428 | -0.6785 | 0.040 | 0.003 | 48.00 | 48.28 | 31.9 | nan
0.088 | 0.15 | 0.000 | 0.0024 | 0.0206 | 1.52 | 0.010 | 0.1538 | -0.5870 | 0.040 | 0.003 | 48.00 | 48.28 | 31.9 | nan
0.110 | -0.06 | 0.000 | -0.0016 | 0.0168 | 2.24 | -0.010 | 0.1318 | -0.4528 | 0.040 | 0.004 | 48.01 | 48.31 | 31.9 | nan
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
