deepak-kapa/PancakeActuator/Experimental_Data/CPG_NEW/Backlash_Fixed_Output_data/backlash.png

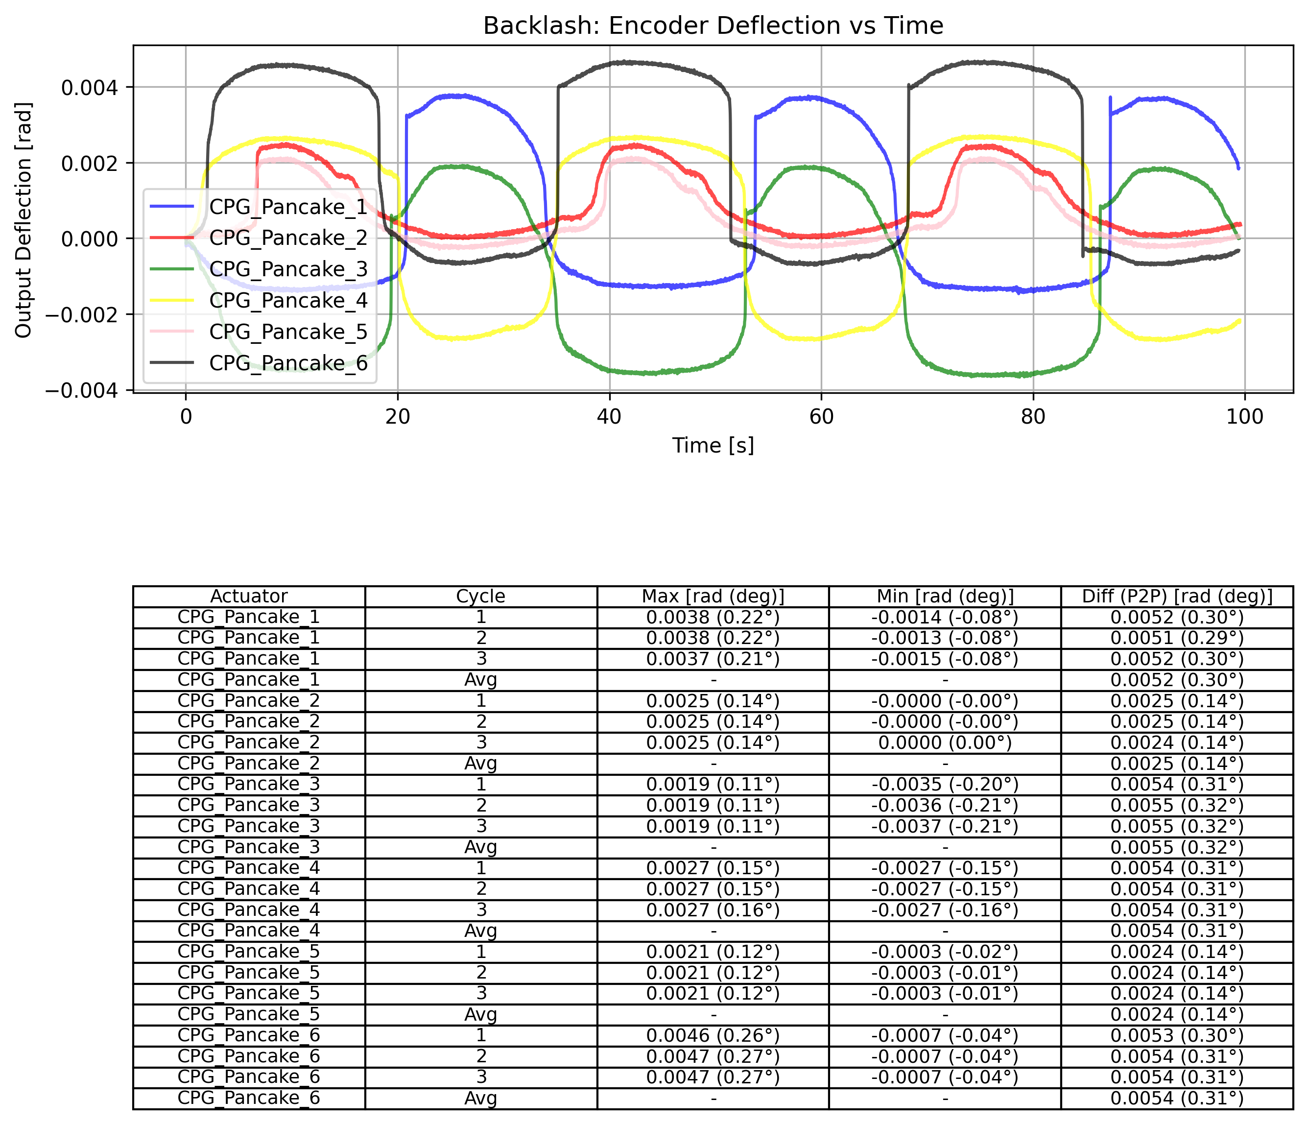
Experimental_Data/CPG_NEW/Backlash_Fixed_Output_data/backlash.png
