deepak-kapa/PancakeActuator/Experimental_Data/CPG_NEW/Stiffness_Fixed_Output_data/stiffness.png

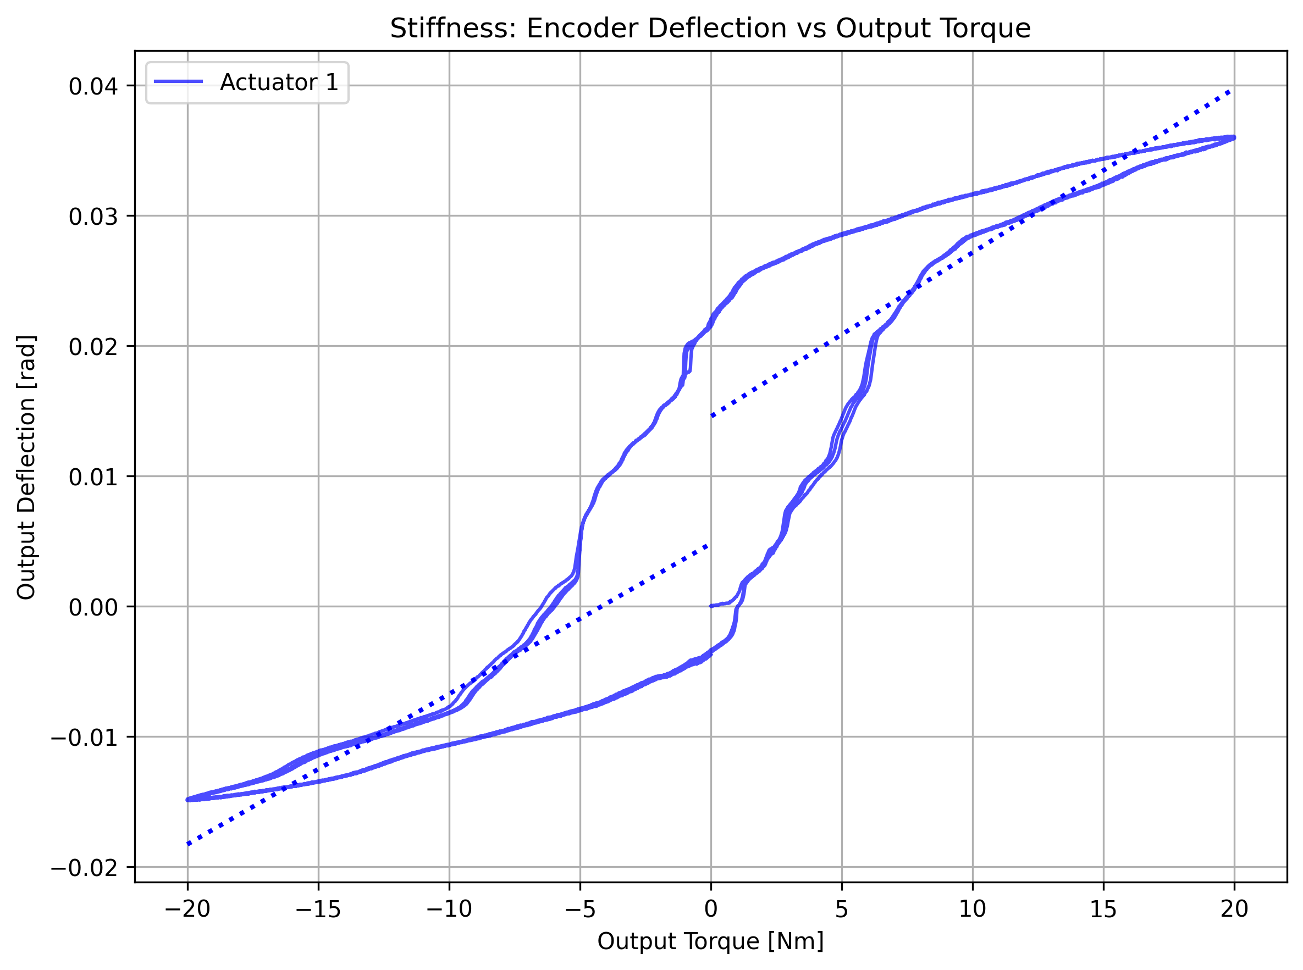
Experimental_Data/CPG_NEW/Stiffness_Fixed_Output_data/stiffness.png
