deepak-kapa/PancakeActuator/Experimental_Data/efficiency_static_torque_cell.png

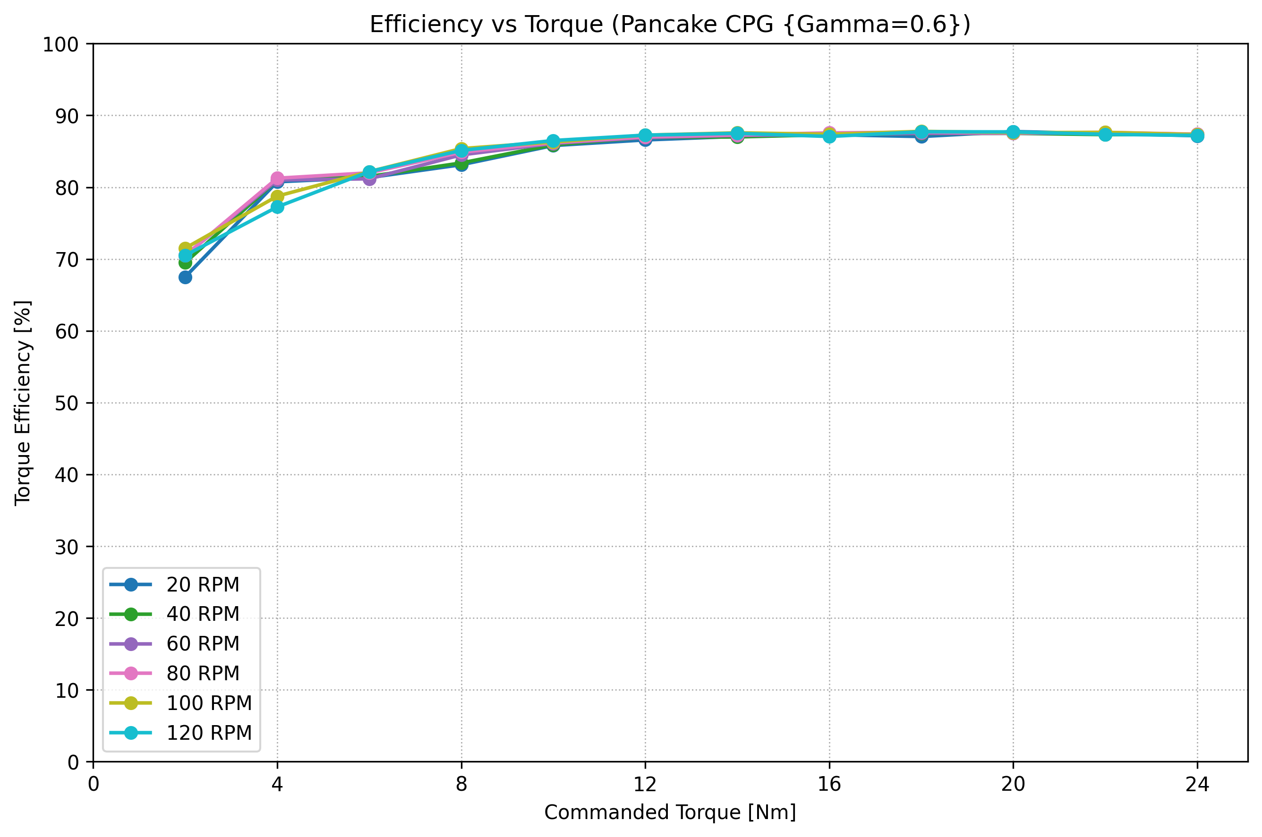
Experimental_Data/efficiency_static_torque_cell.png
