deepak-kapa/PancakeActuator/Experimental_Data/PANCAKE_NEW_30AUG/Backlash_Fixed-Output_Data/backlash.png

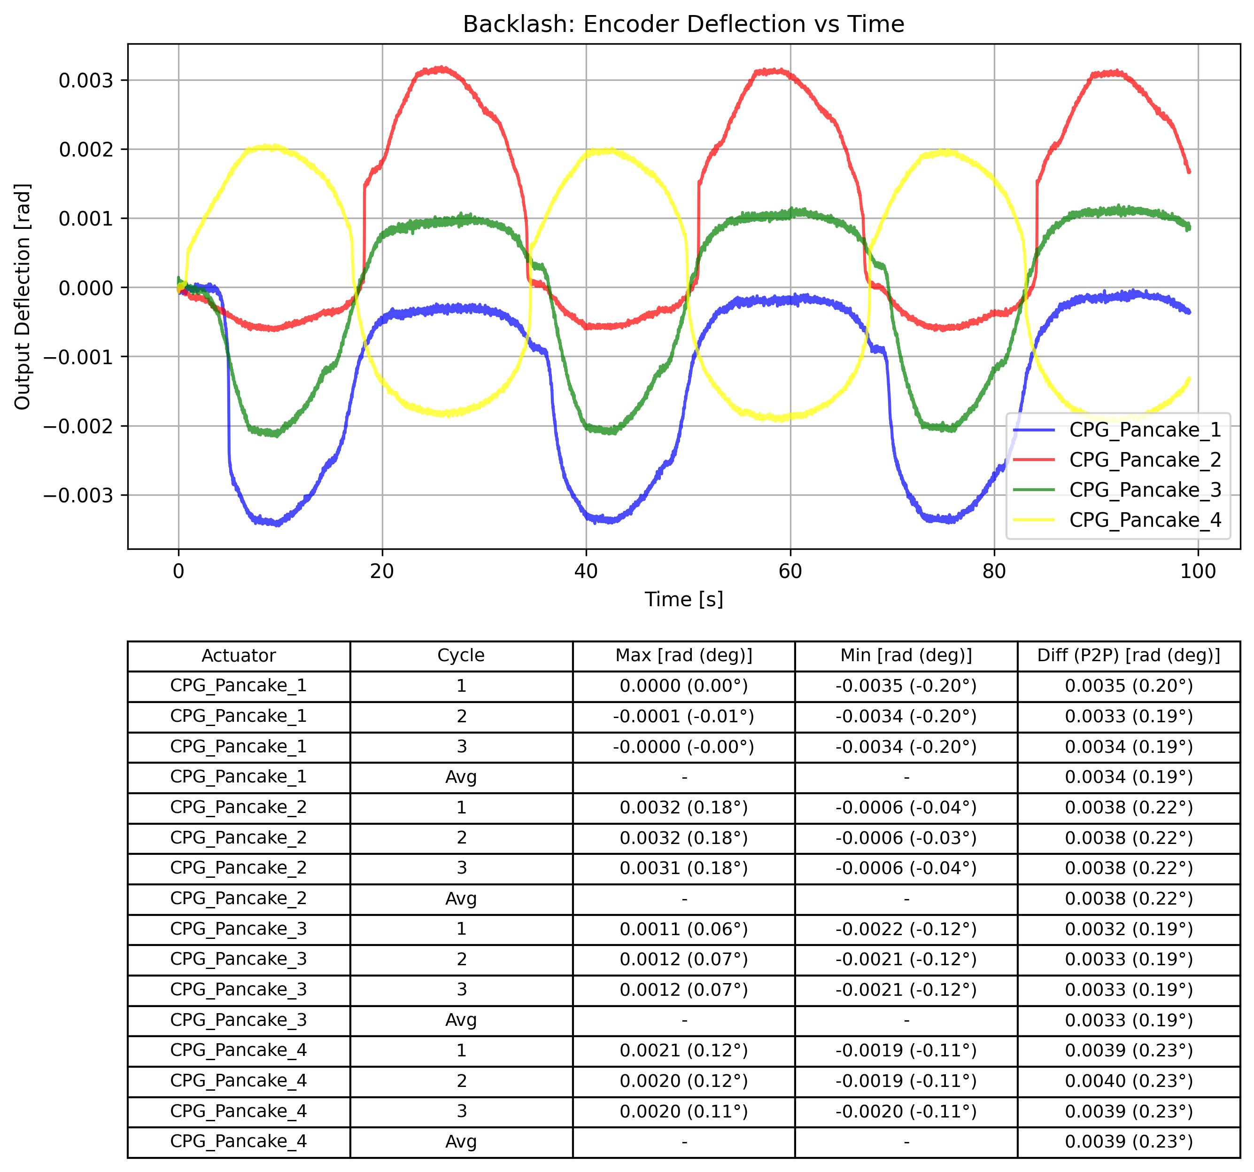
Experimental_Data/PANCAKE_NEW_30AUG/Backlash_Fixed-Output_Data/backlash.png
