deepak-kapa/PancakeActuator/Experimental_Data/PANCAKE_NEW_30AUG/Stiffness_Fixed_Output_Data/stiffness.png

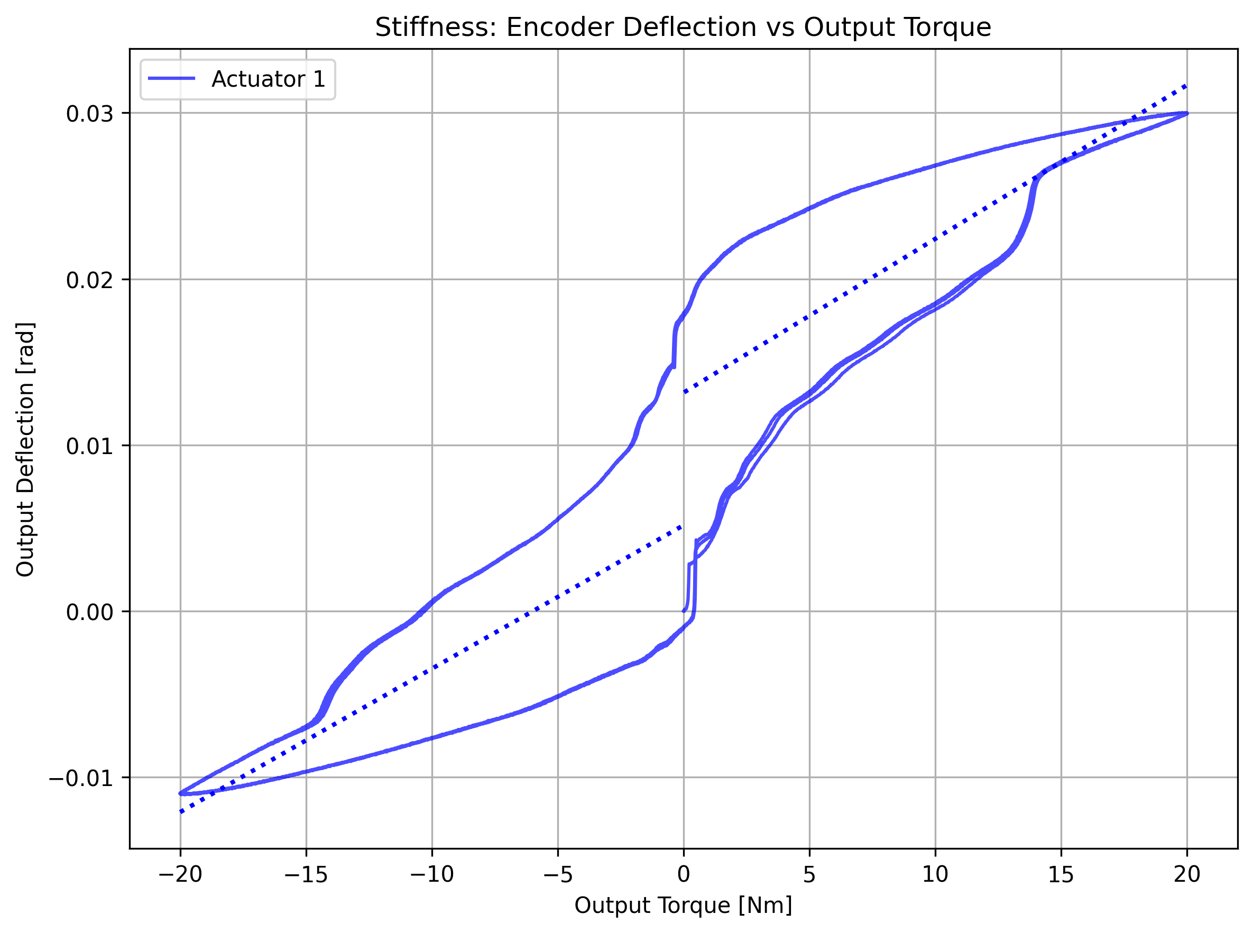
Experimental_Data/PANCAKE_NEW_30AUG/Stiffness_Fixed_Output_Data/stiffness.png
