deepak-kapa/PancakeActuator/ActuatorAndGearbox.py

from typing import Any
import numpy as np
import os
import sys
import time

# base directory for results (absolute path)
RESULTS_DIR = os.path.join(os.path.dirname(os.path.abspath(__file__)), "results")

#-------------------------------------------------------------------------
# class material
#-------------------------------------------------------------------------
class material:
    def __init__(self, density, maxAllowableStressMPa = 400, bhn = 2, youngsModulus = 10):
        self.maxAllowableStressMPa = maxAllowableStressMPa
        self.bhn = bhn
        self.youngsModulus = youngsModulus
        self.density = density

#-------------------------------------------------------------------------
# class bearings
#-------------------------------------------------------------------------
class bearings_discrete:
    def __init__(self,idRequiredMM):
        # Bearing dataset entered according to e1102 in [idMM,odMM,widthMM,massKG] format pg no b10-12
        self.data_bearings = [[10,19,5,0.005],[12,21,5,0.006],[15,24,5,0.007],[17,26,5,0.007],[20,32,7,0.017],[25,37,7,0.021],[28,52,12,0.096],[30,42,7,0.024],[32,58,13,0.122],[35,47,7,0.027],[40,52,7,0.031],[45,58,7,0.038],[50,65,7,0.050],[55,72,9,0.081],[60,78,10,0.103],[65,85,10,0.128],[70,90,10,0.134],[75,95,10,0.149],[80,100,10,0.151],[85,110,13,0.263],
                              [90,115,13,0.276],[95,120,13,0.297],[100,125,13,0.31],[105,130,13,0.324],[110,140,16,0.497],[120,150,16,0.537],[130,165,18,0.758],[140,170,18,0.832],[150,190,20,1.15],[160,200,20,1.23]]
        self.idRequiredMM = idRequiredMM
        self.indexBearing =   0
        while (self.data_bearings[self.indexBearing][0] < self.idRequiredMM):
            self.indexBearing +=1
        # # Extract columns
        # data_bearings = np.array(self.data_bearings)
        # self.d = data_bearings[:, 0].reshape(-1, 1)  # Inner diameters
        # self.D = data_bearings[:, 1]  # Outer diameters
        # self.B = data_bearings[:, 2]  # Widths
        # self.L = data_bearings[:, 3]  # Load ratings

        # # Create linear regression models
        # self.lr_D = LinearRegression().fit(self.d, self.D)
        # self.lr_B = LinearRegression().fit(self.d, self.B)
        # self.lr_L = LinearRegression().fit(self.d, self.L)

    def getBearingIDMM(self):
        return self.data_bearings[self.indexBearing][0]
    
    def getBearingODMM(self):
        return self.data_bearings[self.indexBearing][1]
    
    def getBearingWidthMM(self):
        return self.data_bearings[self.indexBearing][2]
    
    def getBearingMassKG(self):
        return self.data_bearings[self.indexBearing][3]

    # # Continuous functions
    # def getBearingIDMM(self):
    #     return self.idRequiredMM  # Identity function for d

    # def getBearingODMM(self):
    #     return np.round(self.lr_D.predict(np.array([[self.idRequiredMM]]))[0],3)

    # def getBearingWidthMM(self):
    #     return np.round(self.lr_B.predict(np.array([[self.idRequiredMM]]))[0],2)

    # def getBearingMassKG(self):
    #     return np.round(self.lr_L.predict(np.array([[self.idRequiredMM]]))[0],3)

class bearings_continuous:
    def __init__(self,idRequiredMM):
        # Bearing dataset entered according to e1102 in [idMM,odMM,widthMM,massKG] format pg no b10-12
        self.data_bearings = [[25,37,7,0.021],
                              [28,52,12,0.096],
                              [30,42,7,0.024],
                              [32,58,13,0.122],
                              [35,47,7,0.027],
                              [40,52,7,0.031],
                              [45,58,7,0.038],
                              [50,65,7,0.050],
                              [55,72,9,0.081],
                              [60,78,10,0.103],
                              [65,85,10,0.128],
                              [70,90,10,0.134],
                              [75,95,10,0.149],
                              [80,100,10,0.151],
                              [85,110,13,0.263],
                              [90,115,13,0.276],
                              [95,120,13,0.297],
                              [100,125,13,0.31],
                              [105,130,13,0.324],
                              [110,140,16,0.497],
                              [120,150,16,0.537],
                              [130,165,18,0.758],
                              [140,170,18,0.832],
                              [150,190,20,1.15],
                              [160,200,20,1.23]]
        self.idRequiredMM = idRequiredMM
        self.indexBearing =   0

        # while (self.data_bearings[self.indexBearing][0] < self.idRequiredMM):
        #     self.indexBearing +=1
        # # Extract columns
        # data_bearings = np.array(self.data_bearings)
        # self.d = data_bearings[:, 0].reshape(-1, 1)  # Inner diameters
        # self.D = data_bearings[:, 1]  # Outer diameters
        # self.B = data_bearings[:, 2]  # Widths
        # self.L = data_bearings[:, 3]  # Load ratings

        # # Create linear regression models
        # self.lr_D = LinearRegression().fit(self.d, self.D)
        # self.lr_B = LinearRegression().fit(self.d, self.B)
        # self.lr_L = LinearRegression().fit(self.d, self.L)

    def getBearingIDMM(self):
        return self.idRequiredMM
        return self.data_bearings[self.indexBearing][0]
    
    def getBearingODMM(self):
        a_OD = 1.180682635961756 
        b_OD = 8.566071759021273
        Bearing_OD = a_OD * self.idRequiredMM + b_OD
        return Bearing_OD
        return self.data_bearings[self.indexBearing][1]
    
    def getBearingWidthMM(self):
        a_widths  = 0.09293718515472396
        b_widths  = 4.617962372776808

        Bearing_Width = a_widths * self.idRequiredMM + b_widths
        return Bearing_Width
        return self.data_bearings[self.indexBearing][2]
    
    def getBearingMassKG(self):
        a_weights = 8.4777526725202e-05
        b_weights = -0.006890846402773096
        c_weights = 0.18849936113412308

        Bearing_Weight = a_weights * self.idRequiredMM * self.idRequiredMM + b_weights * self.idRequiredMM + c_weights
        return Bearing_Weight
        return self.data_bearings[self.indexBearing][3]

#-------------------------------------------------------------------------
# Nuts and bolts class
#-------------------------------------------------------------------------
class nuts_and_bolts_dimensions:
    def __init__(self, bolt_dia, bolt_type="socket_head"):
        self.bolt_dia  = bolt_dia
        self.bolt_type = bolt_type
        self.bolt_head_dia, self.bolt_head_height = self.get_bolt_head_dimensions(diameter=self.bolt_dia, bolt_type=self.bolt_type)
        self.nut_width_across_flats, self.nut_thickness = self.get_nut_dimensions(diameter=self.bolt_dia)

    def get_bolt_head_dimensions(self, diameter, bolt_type="socket_head"):
        diameter = float(diameter)

        socket_head_table = {
            1.6: {"d2": (3.00), "k": (1.60)},
            2.0: {"d2": (3.80), "k": (2.00)},
            2.5: {"d2": (4.50), "k": (2.50)},
            3.0: {"d2": (5.50), "k": (3.00)},
            4.0: {"d2": (7.00), "k": (4.00)},
            5.0: {"d2": (8.50), "k": (5.00)},
            6.0: {"d2": (10.00), "k": (6.00)},
            8.0: {"d2": (13.00), "k": (8.00)},
            10.0: {"d2": (16.00), "k": (10.00)}
        }

        # Only dk is stored for CSK, t is calculated as (dk - d) / 2
        csk_table = {
            3.0: {"dk": 6},
            4.0: {"dk": 8},
            5.0: {"dk": 10},
            6.0: {"dk": 12},
            8.0: {"dk": 16},
            10.0: {"dk": 20},
            12.0: {"dk": 24},
            16.0: {"dk": 30},
            20.0: {"dk": 36}
        }

        if bolt_type == "socket_head":
            spec = socket_head_table.get(diameter)
            if not spec:
                raise ValueError(f"Socket head bolt M{diameter} not found.")
            return [spec["d2"], spec["k"]]  # Return d2, k

        elif bolt_type == "CSK":
            spec = csk_table.get(diameter)
            if not spec:
                raise ValueError(f"CSK bolt M{diameter} not found.")
            dk = spec["dk"]
            t = (dk - diameter) / 2
            return [dk, round(t, 3)]  # Rounded for clarity

        else:
            raise ValueError("bolt_type must be 'socket_head' or 'CSK'")

    def get_nut_dimensions(self, diameter):
        diameter = float(diameter)

        nut_table = {
            2.0: {"width_across_flats": 4, "height": 1.6},
            2.5: {"width_across_flats": 5, "height": 2},
            3.0: {"width_across_flats": 5.5, "height": 2.4},
            4.0: {"width_across_flats": 7, "height": 3.2},
            5.0: {"width_across_flats": 8, "height": 4},
            6.0: {"width_across_flats": 10, "height": 5},
            7.0: {"width_across_flats": None, "height": 5.5},  # ISO not defined
            8.0: {"width_across_flats": 13, "height": 6.5},
            10.0: {"width_across_flats": 16, "height": 8},
            12.0: {"width_across_flats": 18, "height": 10},
            14.0: {"width_across_flats": 21, "height": 13},
            16.0: {"width_across_flats": 24, "height": 13},
            18.0: {"width_across_flats": 27, "height": 15},
            20.0: {"width_across_flats": 30, "height": 16},
            24.0: {"width_across_flats": 36, "height": 18},
            27.0: {"width_across_flats": 40, "height": 20},
            30.0: {"width_across_flats": 43, "height": 22},
        }

        spec = nut_table.get(diameter)
        if not spec:
            raise ValueError(f"No nut data found for bolt diameter M{diameter}")

        width_across_flats = spec["width_across_flats"]
        height = spec["height"]

        return [width_across_flats, height]

#=========================================================================
# Gearbox classes
#=========================================================================
#-------------------------------------------------------------------------
# Compound Planetary Gearbox
#-------------------------------------------------------------------------
class compoundPlanetaryGearbox:
    def __init__(self,
                 design_parameters,
                 gear_standard_parameters,
                 Ns                        = 20,
                 NpBig                     = 20,
                 NpSmall                   = 20,
                 Nr                        = 60,
                 numPlanet                 =  2,
                 moduleBig                 = 0.8,
                 moduleSmall               = 0.8,
                 fwSunMM                   = 5.0,
                 fwPlanetBigMM             = 5.0,
                 fwPlanetSmallMM           = 5.0,
                 fwRingMM                  = 5.0,
                 densityGears              = 7850.0,
                 densityStructure          = 2710.0,
                 maxGearAllowableStressMPa = 400.0):
        
        self.Ns                        = Ns
        self.NpBig                     = NpBig
        self.NpSmall                   = NpSmall
        self.Nr                        = Nr
        self.numPlanet                 = numPlanet
        self.moduleBig                 = moduleBig
        self.moduleSmall               = moduleSmall
        self.densityGears              = densityGears
        self.densityStructure          = densityStructure
        self.fwSunMM                   = fwSunMM
        self.fwPlanetBigMM             = fwPlanetBigMM
        self.fwPlanetSmallMM           = fwPlanetSmallMM
        self.fwRingMM                  = fwRingMM
        self.maxGearAllowableStressMPa = maxGearAllowableStressMPa # MPa
        self.maxGearAllowableStressPa  = maxGearAllowableStressMPa * 10**6 # Pa

        # Carrier Parameters for the No planet Interference constraint
        self.mu               = gear_standard_parameters["coefficientOfFriction"] # 0.3
        self.pressureAngleDEG = gear_standard_parameters["pressureAngleDEG"]      # 20  # deg

        # self.carrierWidthMM    = design_parameters["carrierWidthMM"]    # carrierWidthMM
        self.ringRadialWidthMM = design_parameters["ringRadialWidthMM"] # ringRadialWidth

        self.planetMinDistanceMM          = design_parameters["planetMinDistanceMM"]          # 5.0 # mm
        self.sCarrierExtrusionDiaMM       = design_parameters["sCarrierExtrusionDiaMM"]       # 8.0 # mm
        self.sCarrierExtrusionClearanceMM = design_parameters["sCarrierExtrusionClearanceMM"] # 1.0 # mm

    def geometricConstraint(self):
        return ((self.Ns + self.NpBig) * self.moduleBig == (self.Nr - self.NpSmall) * self.moduleSmall)
        
    def meshingConstraint(self):
        # TODO: This is a conservative approach. Later make it more general
        Ns2 = self.Nr - self.NpSmall * 2
        return ((self.Ns % self.numPlanet == 0) and (self.Nr % (self.numPlanet) == 0)) and ((self.Nr + Ns2) % (self.numPlanet * 2) == 0)
    
    def noPlanetInterferenceConstraint_old(self):
        return 2*(self.Ns + self.NpBig)*self.moduleBig*np.sin(np.pi/self.numPlanet) >= 2*self.moduleBig*self.NpBig + self.planetMinDistanceMM

    def noPlanetInterferenceConstraint(self):
        module1   = self.moduleBig  # Module of the gear
        module2   = self.moduleSmall  # Module of the gear
        Ns        = self.Ns
        Np1       = self.NpBig
        Np2       = self.NpSmall
        Nr        = self.Nr
        numPlanet = self.numPlanet
        
        Rs                        = (Ns)  * (module1) / 2
        Rp1                       = (Np1) * (module1) / 2
        Rr                        = (Nr)  * (module2) / 2
        Rp2                       = (Np2) * (module2) / 2
        sCarrierExtrusionRadiusMM = self.sCarrierExtrusionDiaMM * 0.5
        return (2 * (Rs + Rp1) * np.sin(np.pi/(2 * numPlanet)) - Rp1 - sCarrierExtrusionRadiusMM >= self.sCarrierExtrusionClearanceMM) and (2 * (Rr - Rp2) * np.sin(np.pi/(2 * numPlanet * 2)) - Rp2 >= 0.5)

    def getMassKG(self):
        # Volume of the Sun gear
        fwSunM            = (self.fwSunMM / 1000.0)
        fwPlanetBigM      = (self.fwPlanetBigMM / 1000.0)
        fwPlanetSmallM    = (self.fwPlanetSmallMM / 1000.0)
        fwRingM           = (self.fwRingMM / 1000.0)
        carrierWidthM     = (self.carrierWidthMM / 1000.0)
        sunVolume         = np.pi * fwSunM * (self.getPCRadiusSunM()**2)
        planetBigVolume   = np.pi * fwPlanetBigM * (self.getPCRadiusPlanetBigM()**2)
        planetSmallVolume = np.pi * fwPlanetSmallM * (self.getPCRadiusPlanetSmallM()**2)
        ringVolume        = np.pi * fwRingM * (self.getOuterRadiusRingM()**2 - self.getPCRadiusRingM()**2)
        carrierVolume     = 2 * np.pi * carrierWidthM * (self.getCarrierRadiusM()**2)
        
        # Total mass of the compound planetary gearbox
        combinedGearVolume = sunVolume + (self.numPlanet * planetBigVolume) + planetSmallVolume + ringVolume
        TotalMassKG        = (combinedGearVolume * self.densityGears + carrierVolume * self.densityStructure)
        return TotalMassKG
    
    def gearRatio(self):
        # Radii of the sun, planet, and ring gears
        Rs = self.Ns * self.moduleBig
        RpBig = self.NpBig * self.moduleBig
        RpSmall = self.NpSmall * self.moduleSmall
        Rr = self.Nr * self.moduleSmall

        GR = ((Rs + RpBig) * (RpSmall + RpBig)) / (Rs * RpSmall)
        return GR

    #------------------------------
    # Utility Functions
    #------------------------------
    def inverse_involute(self,inv_alpha):
        # This is an approximation of the inverse involute function
        alpha  = ((3*inv_alpha)**(1/3) - 
                  (2*inv_alpha)/5 + 
                  (9/175)*(3)**(2/3)*inv_alpha**(5/3) - 
                  (2/175)*(3)**(1/3)*(inv_alpha)**(7/3) - 
                  (144/67375)*(inv_alpha)**(3) + 
                  (3258/3128125)*(3)**(2/3)*(inv_alpha)**(11/3) - 
                  (49711/153278125)*(3)**(1/3)*(inv_alpha)**(13/3))
        return alpha

    def involute(self,alpha):
        return (np.tan(alpha) - alpha)

    # Define the differentiable quadratic approximation of the min function
    def quadratic_min(self, a, b, k=0.01):
        return (a + b - np.sqrt((a - b)**2 + k**2)) / 2

    #-------------------------------------------------------------------------
    # Gear Tooth profile parameters
    #-------------------------------------------------------------------------
    def getPressureAngleRad(self):
        return self.pressureAngleDEG * np.pi / 180  # Pressure angle in radians
 
    def getWorkingPressureAngle(self):
        module1 = self.moduleBig  # Module of the gear
        module2 = self.moduleSmall  # Module of the gear
        Ns      = self.Ns
        Np1     = self.NpBig
        Np2     = self.NpSmall
        Nr      = self.Nr
        xs      = 0
        xp1     = 0
        xp2     = 0
        xr      = 0
        
        #---------------------------------
        # Pressure Angle
        #---------------------------------
        alpha = self.getPressureAngleRad()

        #---------------------------------
        # Working pressure angle
        #---------------------------------
        # Sun-Planet
        inv_alpha_w_sunPlanet = 2*np.tan(alpha)*((xs + xp1)/(Ns + Np1)) + self.involute(alpha)
        alpha_w_sunPlanet = self.inverse_involute(inv_alpha_w_sunPlanet)

        # Planet-Ring
        inv_alpha_w_planetRing = 2*np.tan(alpha)*((xr-xp2)/(Nr - Np2)) + self.involute(alpha)
        alpha_w_planetRing = self.inverse_involute(inv_alpha_w_planetRing)

        return alpha_w_sunPlanet, alpha_w_planetRing

    def getCenterDistModificationCoeff(self):
        module1 = self.moduleBig  # Module of the gear
        module2 = self.moduleSmall  # Module of the gear
        Ns      = self.Ns
        Np1     = self.NpBig
        Np2     = self.NpSmall
        Nr      = self.Nr

        #------------------------------
        # Pressure Angle
        #------------------------------
        alpha = self.getPressureAngleRad()  # Pressure angle in radians

        #------------------------------
        # Working pressure angle
        #------------------------------
        alpha_w_sunPlanet, alpha_w_planetRing = self.getWorkingPressureAngle()

        #------------------------------
        # Centre distance modification coefficient
        #------------------------------
        y_sunPlanet  = ((Ns + Np1) / 2) * ((np.cos(alpha) / np.cos(alpha_w_sunPlanet)) - 1)
        y_planetRing = ((Nr - Np2) / 2) * ((np.cos(alpha) / np.cos(alpha_w_planetRing)) - 1)

        return y_sunPlanet, y_planetRing

    def getCenterDistance(self):
        module1 = self.moduleBig  # Module of the gear
        module2 = self.moduleSmall  # Module of the gear
        Ns      = self.Ns
        Np1     = self.NpBig
        Np2     = self.NpSmall
        Nr      = self.Nr
    
        #-------------------------------
        # Centre distance modification coefficient
        #-------------------------------
        y_sunPlanet, y_planetRing = self.getCenterDistModificationCoeff()

        #-------------------------------
        # Centre distance
        #-------------------------------
        centerDist_sunPlanet = ((Ns + Np1)/2  + y_sunPlanet)* module1
        centerDist_planetRing = ((Nr - Np2)/2  + y_planetRing)* module2

        return centerDist_sunPlanet, centerDist_planetRing

    def getBaseDia(self):
        module1 = self.moduleBig  # Module of the gear
        module2 = self.moduleSmall  # Module of the gear
        Ns      = self.Ns
        Np1     = self.NpBig
        Np2     = self.NpSmall
        Nr      = self.Nr

        # Pressure Angle
        alpha = self.getPressureAngleRad() # Rad

        # Reference Diameter
        D_sun     = module1 * Ns # Sun's reference diameter
        D_planet1 = module1 * Np1 # Planet's reference diameter
        D_planet2 = module2 * Np2 # Planet's reference diameter
        D_ring    = module2 * Nr # Ring's reference diameter

        # Base Diameter
        D_b_sun     = D_sun * np.cos(alpha)
        D_b_planet1 = D_planet1 * np.cos(alpha)
        D_b_planet2 = D_planet2 * np.cos(alpha)
        D_b_ring    = D_ring * np.cos(alpha)

        return D_b_sun, D_b_planet1, D_b_planet2, D_b_ring
 
    def getTipCircleDia(self):
        module1 = self.moduleBig  # Module of the gear
        module2 = self.moduleSmall  # Module of the gear
        Ns      = self.Ns
        Np1     = self.NpBig
        Np2     = self.NpSmall
        Nr      = self.Nr
        xs      = 0
        xp1     = 0
        xp2     = 0
        xr      = 0
        
        #----------------------------
        # Pressure Angle
        #----------------------------
        alpha = self.getPressureAngleRad() # Rad

        #----------------------------
        # Reference Diameter
        #----------------------------
        D_sun     = module1 * Ns # Sun's reference diameter
        D_planet1 = module1 * Np1 # Planet's reference diameter
        D_planet2 = module2 * Np2 # Planet's reference diameter
        D_ring    = module2 * Nr # Ring's reference diameter

        #----------------------------
        # Center Distance Modification Coefficient
        #----------------------------
        y_sunPlanet, y_planetRing = self.getCenterDistModificationCoeff()

        #----------------------------
        # Tip circle diameter
        #----------------------------
        # Sun
        D_a_sun = D_sun + 2 * module1 * (1 + y_sunPlanet - xp1)

        # Planet
        D_a_planet1  = D_planet1 + 2 * module1 * (1 + self.quadratic_min((y_sunPlanet - xs), xp1))  
        D_a_planet2  = D_planet2 + 2 * module2 * (1 + self.quadratic_min((y_planetRing - xs),xp2)) 
        # D_a_planet = D_planet + 2 * module * (1 + xp) 
        
        # Ring
        D_a_ring = D_ring - 2 * module2 * (1 - xr)
        
        return D_a_sun, D_a_planet1, D_a_planet2, D_a_ring
 
    def getTipPressureAngle(self):
        module1 = self.moduleBig  # Module of the gear
        module2 = self.moduleSmall  # Module of the gear
        Ns      = self.Ns
        Np1     = self.NpBig
        Np2     = self.NpSmall
        Nr      = self.Nr

        alpha = self.getPressureAngleRad() # Pressure Angle (Rad)
        D_b_sun, D_b_planet1, D_b_planet2, D_b_ring = self.getBaseDia() # Base Diameter
        D_a_sun, D_a_planet1, D_a_planet2, D_a_ring = self.getTipCircleDia() # Tip Circle Diameter

        #----------------------------
        # Tip Pressure angle
        #----------------------------
        alpha_a_sun     = np.arccos(D_b_sun / D_a_sun)
        alpha_a_planet1 = np.arccos(D_b_planet1/D_a_planet1)
        alpha_a_planet2 = np.arccos(D_b_planet2/D_a_planet2)
        alpha_a_ring    = np.arccos(D_b_ring / D_a_ring)

        return alpha_a_sun, alpha_a_planet1, alpha_a_planet2, alpha_a_ring

    def getErrorTipCircleDia_planet(self):
        module1 = self.moduleBig  # Module of the gear
        module2 = self.moduleSmall  # Module of the gear
        Ns      = self.Ns
        Np1     = self.NpBig
        Np2     = self.NpSmall
        Nr      = self.Nr
        xs      = 0
        xp1     = 0
        xp2     = 0
        xr      = 0
        
        # Centre distance modification coefficient
        y_sunPlanet, y_planetRing = self.getCenterDistModificationCoeff()

        # Tip Circle Diameter
        _, D_a_planet1_quadMin, D_a_planet2_quadMin, _ = self.getTipCircleDia()
        D_a_planet1_actMin = module1 * Np1 + 2 * module1 * (1 + np.minimum((y_sunPlanet - xs),xp1)) # TODO: How will we implement min function 
        D_a_planet2_actMin = module2 * Np2 + 2 * module2 * (1 + np.minimum((y_planetRing - xs),xp2)) # TODO: How will we implement min function 

        return np.abs(D_a_planet1_quadMin - D_a_planet1_actMin), np.abs(D_a_planet2_quadMin - D_a_planet2_actMin)

    #-----------------------------------------
    # Contact Ratio
    #-----------------------------------------
    def contactRatio_sunPlanet(self):
        module1 = self.moduleBig  # Module of the gear
        module2 = self.moduleSmall  # Module of the gear
        Ns      = self.Ns
        Np1     = self.NpBig
        Np2     = self.NpSmall
        Nr      = self.Nr

        # Working pressure angle
        alpha_w_sunPlanet, _ = self.getWorkingPressureAngle()

        # Tip pressure angle
        alpha_a_sun, alpha_a_planet1, _, _ = self.getTipPressureAngle()

        # Contact ratio
        Approach_CR_sunPlanet = (Np1 / (2 * np.pi)) * (np.tan(alpha_a_planet1) - np.tan(alpha_w_sunPlanet)) # Approach contact ratio
        Recess_CR_sunPlanet   =  (Ns / (2 * np.pi)) * (np.tan(alpha_a_sun) - np.tan(alpha_w_sunPlanet))    # Recess contact ratio

        # write the final formula
        CR_sunPlanet = Approach_CR_sunPlanet + Recess_CR_sunPlanet

        return Approach_CR_sunPlanet, Recess_CR_sunPlanet, CR_sunPlanet

    def contactRatio_planetRing(self):
        module1 = self.moduleBig  # Module of the gear
        module2 = self.moduleSmall  # Module of the gear
        Ns      = self.Ns
        Np1     = self.NpBig
        Np2     = self.NpSmall
        Nr      = self.Nr

        # Working pressure angle
        _, alpha_w_planetRing = self.getWorkingPressureAngle()

        # Tip pressure angle
        _, _, alpha_a_planet2, alpha_a_ring = self.getTipPressureAngle()

        # Contact ratio
        Approach_CR_planetRing = -(Nr / (2 * np.pi)) * (np.tan(alpha_a_ring) - np.tan(alpha_w_planetRing)) # Approach contact ratio
        Recess_CR_planetRing   =   Np2 / (2 * np.pi) * (np.tan(alpha_a_planet2) - np.tan(alpha_w_planetRing)) # Recess contact ratio
        
        # Contact Ratio
        CR_planetRing = Approach_CR_planetRing + Recess_CR_planetRing

        return Approach_CR_planetRing, Recess_CR_planetRing, CR_planetRing

    #-------------------------------------------
    # Efficiency Calculation
    #-------------------------------------------
    def getEfficiency(self):
        # TODO: VERIFY THIS EFFICIENCY FORMULA
        module1 = self.moduleBig  # Module of the gear
        module2 = self.moduleSmall  # Module of the gear
        Ns      = self.Ns
        Np1     = self.NpBig
        Np2     = self.NpSmall
        Nr      = self.Nr

        # Contact ratio
        eps_sunPlanetA, eps_sunPlanetR, _ = self.contactRatio_sunPlanet()
        eps_planetRingA, eps_planetRingR, _ = self.contactRatio_planetRing()
        
        # Contact-Ratio-Factor
        epsilon_sunPlanet = eps_sunPlanetA**2 + eps_sunPlanetR**2 - eps_sunPlanetA - eps_sunPlanetR + 1 
        epsilon_planetRing = eps_planetRingA**2 + eps_planetRingR**2 - eps_planetRingA - eps_planetRingR + 1 
        
        # Efficiency
        eff_SP = 1 - self.mu * np.pi * ((1 / Np1) + (1 / Ns)) * epsilon_sunPlanet
        eff_PR = 1 - self.mu * np.pi * ((1 / Np2) - (1 / Nr)) * epsilon_planetRing

        Numerator   = (Ns * Np2 + eff_SP * eff_PR * Np1 * Nr)
        Denominator = (Ns + Np1) * (Np2 + Np1)
        return Numerator / Denominator
    
    #-------------------------------------------------
    # Get functions below (Not much calculations)
    #-------------------------------------------------
    def getPCRadiusSunM(self):
        return ((self.Ns * self.moduleBig / 2) / 1000.0)

    def getPCRadiusPlanetBigM(self):
        return ((self.NpBig * self.moduleBig / 2) / 1000.0)

    def getPCRadiusPlanetSmallM(self):
        return ((self.NpSmall * self.moduleSmall / 2) / 1000.0)

    def getPCRadiusRingM(self):
        return ((self.Nr * self.moduleSmall / 2) / 1000.0)
    
    def getGearboxOuterDiaMaxM(self):
        Rs       = self.Ns * self.moduleBig * 0.5
        RpBig   = self.NpBig * self.moduleBig * 0.5
        Rr = self.Nr * self.moduleSmall + 8

        return ((Rs  + 2*RpBig)*2/1000.0)

    def getPCRadiusSunMM(self):
        return ((self.Ns * self.moduleBig / 2))

    def getPCRadiusPlanetBigMM(self):
        return ((self.NpBig * self.moduleBig / 2))

    def getPCRadiusPlanetSmallMM(self):
        return ((self.NpSmall * self.moduleSmall / 2))

    def getPCRadiusRingMM(self):#?
        return ((self.Nr * self.moduleSmall) / 2)
    
    def getOuterRadiusRingM(self):
        ringPCDiameterMM = self.Nr * self.moduleSmall 
        ringPCRadiusMM = ringPCDiameterMM / 2
        return (ringPCRadiusMM + self.ringRadialWidthMM) / 1000.0

    def getCarrierRadiusM(self):
        return (((self.Ns + self.NpBig + self.NpBig/2)/2)*self.moduleBig) / 1000.0

    #--------------------------------------------
    # Set functions
    #--------------------------------------------
    def setfwSunMM(self, fwSunMM):
        self.fwSunMM = fwSunMM

    def setfwPlanetBigMM(self, fwPlanetBigMM):
        self.fwPlanetBigMM = fwPlanetBigMM

    def setfwPlanetSmallMM(self, fwPlanetSmallMM):
        self.fwPlanetSmallMM = fwPlanetSmallMM

    def setfwRingMM(self, fwRingMM):
        self.fwRingMM = fwRingMM
    
    def setModuleBig(self, moduleBig):
        self.moduleBig = moduleBig

    def setModuleSmall(self, moduleSmall):
        self.moduleSmall = moduleSmall

    def setNs(self, Ns):
        self.Ns = Ns

    def setNpBig(self, NpBig):
        self.NpBig = NpBig
    
    def setNpSmall(self, NpSmall):
        self.NpSmall = NpSmall
    
    def setNr(self, Nr):
        self.Nr = Nr

    def setNumPlanet(self, numPlanet):
        self.numPlanet = numPlanet
  
    #--------------------------------------------
    # Print Functions
    #--------------------------------------------
    def printParameters(self):
        print("Ns = ", self.Ns)
        print("NpBig = ", self.NpBig)
        print("NpSmall = ", self.NpSmall)
        print("Nr = ", self.Nr)
        print("Module (First Layer) = ", self.moduleBig)
        print("Module (Second Layer) = ", self.moduleSmall)
        print("Number of planets = ", self.numPlanet)
        print("Face width of sun gear = ", round(self.fwSunMM,2), " mm")
        print("Face width of Bigger planet gear = ", round(self.fwPlanetBigMM,2), " mm")
        print("Face width of Smaller planet gear = ", round(self.fwPlanetSmallMM,2), " mm")
        print("Face width of ring gear = ", round(self.fwRingMM,2), " mm")
        print("Carrier width = ", self.carrierWidthMM, " mm")
        print("Ring radial width = ", self.ringRadialWidthMM, " mm")
        print("Pitch circle radius of sun gear = ", self.getPCRadiusSunM() * 1000, " mm")
        print("Pitch circle radius of Bigger planet gear = ", self.getPCRadiusPlanetBigM() * 1000, " mm")
        print("Pitch circle radius of Smaller planet gear = ", self.getPCRadiusPlanetSmallM() * 1000, " mm")
        print("Pitch circle radius of ring gear = ", self.getPCRadiusRingM() * 1000, " mm")
        print("Outer radius of ring gear = ", self.getOuterRadiusRingM() * 1000, " mm")
        print("Carrier radius = ", self.getCarrierRadiusM() * 1000, " mm")
        print("Geometric constraint = ", self.geometricConstraint())
        print("Meshing constraint = ", self.meshingConstraint())
        print("No planet interference constraint = ", self.noPlanetInterferenceConstraint())
        print("Mass of the planetary gearbox = ", self.getMassKG(), " kg")
        print("Efficiency of the planetary gearbox = ", self.getEfficiency())
        
    def printParametersLess(self):
        vars = [self.moduleBig, self.moduleSmall, self.Ns, self.NpBig, self.NpSmall, self.Nr, self.numPlanet]
        faceWidths = [round(self.fwSunMM,2), round(self.fwPlanetBigMM,2), round(self.fwPlanetSmallMM,2), round(self.fwRingMM,2)]
        print("[mB, mS, Ns, NpB, NpS, Nr, numPl]:", vars) 
        print("Face widths = ", faceWidths)
        print(" ")
        print("Gear ratio = ", self.gearRatio())
        print("Efficiency = ", round(self.getEfficiency(),4))
        print("Mass (gearbox, kg) = ", round(self.getMassKG(),3), " kg")
        # print("--------------------------------------------------------------------------")

#-------------------------------------------------------------------------

# Motor class
#=========================================================================
class motor:
    def __init__(self, 
                 maxMotorAngVelRPM     = 1190, # RPM
                 maxMotorTorque        = 8.83, # Nm
                 maxMotorPower         = 8.83 * 1190 * 2*np.pi/60, # W 
                 motorMass             = 0.778, # KG
                 motorDia              = 106.8, # mm
                 motorLength           = 47.6,  # mm
                 motor_mount_hole_PCD       = 32,
                 motor_mount_hole_dia       = 4,
                 motor_mount_hole_num       = 4,
                 motor_output_hole_PCD      = 23,
                 motor_output_hole_dia      = 4,
                 motor_output_hole_num      = 4,
                 wire_slot_dist_from_center = 30,
                 wire_slot_length           = 10,
                 wire_slot_radius           = 4,
                 motorName             = "U12"):
        
        self.motorName                  = motorName
        self.maxMotorAngVelRPM          = maxMotorAngVelRPM
        self.maxMotorAngVelRadPerSec    = maxMotorAngVelRPM * (2 * np.pi / 60)
        self.maxMotorTorque             = maxMotorTorque
        self.maxMotorPower              = maxMotorPower
        self.massKG                     = motorMass     # kg
        self.motorDiaMM                 = motorDia      # mm #TODO: make use of this parameter
        self.motorLengthMM              = motorLength   # mm #TODO: make use of this parameter
        self.motor_mount_hole_PCD       = motor_mount_hole_PCD 
        self.motor_mount_hole_dia       = motor_mount_hole_dia
        self.motor_mount_hole_num       = motor_mount_hole_num
        self.motor_output_hole_PCD      = motor_output_hole_PCD 
        self.motor_output_hole_dia      = motor_output_hole_dia
        self.motor_output_hole_num      = motor_output_hole_num
        self.wire_slot_dist_from_center = wire_slot_dist_from_center 
        self.wire_slot_length           = wire_slot_length 
        self.wire_slot_radius           = wire_slot_radius

    # Maximum motor angular velocity in rad/s
    def getMaxMotorAngVelRadPerSec(self):
        return self.maxMotorAngVelRadPerSec
    
    # Maximum motor power in W
    def getMaxMotorPower(self):
        return self.maxMotorPower
    
    # Maximum motor torque in Nm
    def getMaxMotorTorque(self):
        return self.maxMotorTorque
    
    # Mass of the motor in kg
    def getMassKG(self):
        return self.massKG
    
    #dimension of the motor in MM
    def getDiaMM(self):
        return self.motorDiaMM
    
    def getLengthMM(self):
        return self.motorLengthMM
    
    #dimensions of Stator
    def getStatorIDMM(self):
        return self.motorStatorIDMM
    
    def getStatorODMM(self):
        return self.motorStatorODMM
    
    def getStatorHeight(self):
        return self.motorStatorHeightMM
    
    # Print the motor parameters
    def printParameters(self):
        print("Maximum motor angular velocity = ", self.maxMotorAngVelRPM, " RPM")
        print("Maximum motor power = ", self.maxMotorPower, " W")
        print("Maximum motor torque = ", self.maxMotorTorque, " Nm")
        print("Maximum motor angular velocity = ", self.maxMotorAngVelRadPerSec, " rad/s")
        print("Mass of the motor = ", self.massKG, " kg")
        print ('Diameter of the motor = ', self.motorDiaMM, ' mm')
        print( " Length of the motor = ", self.motorLengthMM, ' mm')
        if (self.motorStatorIDMM != 0 and self.motorStatorODMM != 0 and self.motorStatorHeightMM !=0):
            print (' Inner Diameter of Stator = ', self.motorStatorIDMM, ' mm')
            print (' Outer Diameter of Stator = ', self.motorStatorODMM, ' mm')
            print (' Height of Stator = ', self.motorStatorIDMM, ' mm')

#=========================================================================
# Motor Driver class
#=========================================================================
class motor_driver:
    def __init__(self, driver_name, motor_driver_data):
        self.driver_name                          = driver_name
        self.driver_upper_holes_dist_from_center  = motor_driver_data["driver_upper_holes_dist_from_center"]
        self.driver_lower_holes_dist_from_center  = motor_driver_data["driver_lower_holes_dist_from_center"]
        self.driver_side_holes_dist_from_center   = motor_driver_data["driver_side_holes_dist_from_center"]
        self.driver_mount_holes_dia               = motor_driver_data["driver_mount_holes_dia"]
        self.driver_mount_inserts_OD              = motor_driver_data["driver_mount_inserts_OD"]
        self.driver_mount_thickness               = motor_driver_data["driver_mount_thickness"]
        self.driver_mount_height                  = motor_driver_data["driver_mount_height"]

        # self.print_vars()
    
    def print_vars(self):
        print("driver_name:", self.driver_name)
        print("driver_upper_holes_dist_from_center: ", self.driver_upper_holes_dist_from_center)
        print("driver_lower_holes_dist_from_center: ", self.driver_lower_holes_dist_from_center)
        print("driver_side_holes_dist_from_center: ", self.driver_side_holes_dist_from_center)
        print("driver_mount_holes_dia: ", self.driver_mount_holes_dia)
        print("driver_mount_inserts_OD: ", self.driver_mount_inserts_OD)
        print("driver_mount_thickness: ", self.driver_mount_thickness)
        print("driver_mount_height: ", self.driver_mount_height)
        print("---")

#=========================================================================
# Actuator classes
#=========================================================================
#-------------------------------------------------------------------------
# Pancake Compound Actuator class
#-------------------------------------------------------------------------
class pancakeCompoundActuator:
    def __init__(self, 
                 design_parameters,
                 motor_driver_params,
                 motor                    = motor, 
                 compoundPlanetaryGearbox = compoundPlanetaryGearbox, 
                 FOS                      = 2.0, 
                 serviceFactor            = 2.0, 
                 maxGearboxDiameter       = 140.0,
                 stressAnalysisMethodName = "Lewis"):
        
        self.motor                    = motor
        self.compoundPlanetaryGearbox = compoundPlanetaryGearbox
        self.FOS                      = FOS
        self.serviceFactor            = serviceFactor
        self.maxGearboxDiameter       = maxGearboxDiameter # TODO: convert it to 
                                                           # outer diameter of 
                                                           # the motor
        self.stressAnalysisMethodName = stressAnalysisMethodName

        #============================================
        # Motor Parameters
        #============================================
        self.motorLengthMM           = self.motor.getLengthMM()
        self.motorDiaMM              = self.motor.getDiaMM()
        self.motorMassKG             = self.motor.getMassKG()
        self.MaxMotorTorque          = self.motor.maxMotorTorque          # U12_maxTorque          # Nm
        self.MaxMotorAngVelRPM       = self.motor.maxMotorAngVelRPM       # U12_maxAngVelRPM       # RPM
        self.MaxMotorAngVelRadPerSec = self.motor.maxMotorAngVelRadPerSec # U12_maxAngVelRadPerSec # radians/sec

        #============================================
        # Actuator Design Parameters
        #============================================
        self.design_params = design_parameters
        self.motor_driver_params = motor_driver_params

        #--------------------------------------------
        # Independent Parameters
        #--------------------------------------------
        self.ringRadialWidthMM    = self.compoundPlanetaryGearbox.ringRadialWidthMM  

        #-----------------------------------------------------
        # Dependent parameters
        #-----------------------------------------------------
        self.setVariables()

    def cost(self):
        massActuator = self.getMassKG_3DP()
        effActuator  = self.compoundPlanetaryGearbox.getEfficiency()
        widthActuator = self.compoundPlanetaryGearbox.fwPlanetBigMM + self.compoundPlanetaryGearbox.fwPlanetSmallMM
        cost = massActuator - 2 * effActuator + 0.2 * widthActuator
        return cost

    def setVariables(self):
        #--------- Optimization Variable-----------
        self.Ns         = self.compoundPlanetaryGearbox.Ns
        self.Np_b       = self.compoundPlanetaryGearbox.NpBig
        self.Np_s       = self.compoundPlanetaryGearbox.NpSmall
        self.Nr         = self.Ns + self.Np_b + self.Np_s
        self.num_planet = self.compoundPlanetaryGearbox.numPlanet
        self.module     = self.compoundPlanetaryGearbox.moduleBig

        #------------------------------------------------------
        # Indepent Constant variables
        #------------------------------------------------------
        #----------------- Gear Profile --------------------
        self.pressure_angle     = self.compoundPlanetaryGearbox.getPressureAngleRad() # 20
        self.pressure_angle_deg = self.compoundPlanetaryGearbox.getPressureAngleRad() * 180 / np.pi # 20

        #-------------Clearances---------------------
        self.clearance_planet                           = self.design_params["clearance_planet"]                           # 1.5
        self.clearance_case_mount_holes_shell_thickness = self.design_params["clearance_case_mount_holes_shell_thickness"] # 1
        self.standard_clearance_1_5mm                   = self.design_params["standard_clearance_1_5mm"]                   # 1.5
        self.case_mounting_nut_clearance                = self.design_params["case_mounting_nut_clearance"]                # 2
        self.standard_fillet_1_5mm                      = self.design_params["standard_fillet_1_5mm"]                      # 1.5
        self.standard_bearing_insertion_chamfer         = self.design_params["standard_bearing_insertion_chamfer"]         # 0.5
        self.bearingIDClearanceMM                       = self.design_params["bearingIDClearanceMM"]                       # 10
        self.clearance_sun_coupler_sec_carrier          = self.design_params["clearance_sun_coupler_sec_carrier"]          # standard_clearance_1_5mm
        self.ring_to_chamfer_clearance                  = self.design_params["ring_to_chamfer_clearance"]                  # clearance_planet
        self.tight_clearance_3DP                        = self.design_params["tight_clearance_3DP"]        
        self.loose_clearance_3DP                        = self.design_params["loose_clearance_3DP"]

        #-----------Motor----------------------------
        self.motor_OD                   = self.motorDiaMM                     # 86.8
        self.motor_height               = self.motorLengthMM                  # 26.5
        self.motor_mount_hole_PCD       = self.motor.motor_mount_hole_PCD     # 32
        self.motor_mount_hole_dia       = self.motor.motor_mount_hole_dia     # 4
        self.motor_mount_hole_num       = self.motor.motor_mount_hole_num     # 4
        self.motor_output_hole_PCD      = self.motor.motor_output_hole_PCD    # 23
        self.motor_output_hole_dia      = self.motor.motor_output_hole_dia    # 4
        self.motor_output_hole_num      = self.motor.motor_output_hole_num    # 4
        self.wire_slot_dist_from_center = self.motor.wire_slot_dist_from_center # 30
        self.wire_slot_length           = self.motor.wire_slot_length         # 10
        self.wire_slot_radius           = self.motor.wire_slot_radius         # 4

        self.driver_upper_holes_dist_from_center = self.motor_driver_params["driver_upper_holes_dist_from_center"] # 23
        self.driver_lower_holes_dist_from_center = self.motor_driver_params["driver_lower_holes_dist_from_center"] # 15
        self.driver_side_holes_dist_from_center  = self.motor_driver_params["driver_side_holes_dist_from_center"]  # 20
        self.driver_mount_holes_dia              = self.motor_driver_params["driver_mount_holes_dia"]  # 2.5
        self.driver_mount_inserts_OD             = self.motor_driver_params["driver_mount_inserts_OD"] # 3.5
        self.driver_mount_thickness              = self.motor_driver_params["driver_mount_thickness"]  # 1.5
        self.driver_mount_height                 = self.motor_driver_params["driver_mount_height"]     # 4

        self.central_hole_offset_from_motor_mount_PCD = self.design_params["central_hole_offset_from_motor_mount_PCD"] # 5

        # --- Planet pin and bearing ---
        self.planet_pin_bolt_dia      = self.design_params["planet_pin_bolt_dia"] # 5
        self.planet_shaft_dia         = self.design_params["planet_shaft_dia"] # 8
        self.planet_shaft_step_offset = self.design_params["planet_shaft_step_offset"] # 1
        self.planet_bearing_OD        = self.design_params["planet_bearing_OD"] # 12
        self.planet_bearing_width     = self.design_params["planet_bearing_width"] # 3
        self.planet_bore              = self.design_params["planet_bore"] # 10

        # --- Sun coupler and sun central bolt ---
        self.sun_shaft_bearing_ID      = self.design_params["sun_shaft_bearing_ID"] # 8
        self.sun_shaft_bearing_OD      = self.design_params["sun_shaft_bearing_OD"] # 16
        self.sun_coupler_hub_thickness = self.design_params["sun_coupler_hub_thickness"] # 4
        self.sun_shaft_bearing_width   = self.design_params["sun_shaft_bearing_width"] # 4
        self.sun_central_bolt_dia      = self.design_params["sun_central_bolt_dia"] # 5

        # --- Bearings ---         
        self.bearing_retainer_thickness = self.design_params["bearing_retainer_thickness"] # 2

        # --- Carrier & Sec Carrier ---
        self.sec_carrier_thickness = self.design_params["sec_carrier_thickness"] # 5

        self.carrier_trapezoidal_support_sun_offset                 = self.design_params["carrier_trapezoidal_support_sun_offset"]# 5
        self.carrier_trapezoidal_support_hole_PCD_offset_bearing_ID = self.design_params["carrier_trapezoidal_support_hole_PCD_offset_bearing_ID"]# 4
        self.carrier_trapezoidal_support_hole_dia                   = self.design_params["carrier_trapezoidal_support_hole_dia"]# 3
        self.carrier_bearing_step_width                             = self.design_params["carrier_bearing_step_width"]# 1.5

        # --- Casings ---
        self.case_mounting_surface_height = self.design_params["case_mounting_surface_height"] # 4
        self.case_mounting_hole_dia       = self.design_params["case_mounting_hole_dia"] # 3
        self.case_mounting_bolt_depth     = self.design_params["case_mounting_bolt_depth"] # 4.5

        self.base_plate_thickness = self.design_params["base_plate_thickness"] # 4
        self.Motor_case_thickness = self.design_params["Motor_case_thickness"] # 2.5
        self.air_flow_hole_offset = self.design_params["air_flow_hole_offset"] # 3

        self.output_mounting_hole_dia  = self.design_params["output_mounting_hole_dia"]  # 4
        self.output_mounting_nut_depth = self.design_params["output_mounting_nut_depth"] # 3
        self.output_mounting_hole_num  = self.design_params["output_mounting_hole_num"]  # 4

        self.Motor_case_OD_base_to_chamfer          = self.design_params["Motor_case_OD_base_to_chamfer"] # 5
        self.pattern_offset_from_motor_case_OD_base = self.design_params["pattern_offset_from_motor_case_OD_base"] # 3
        self.pattern_bulge_dia                      = self.design_params["pattern_bulge_dia"] # 3
        self.pattern_num_bulge                      = self.design_params["pattern_num_bulge"] # 18
        self.pattern_depth                          = self.design_params["pattern_depth"] # 2

        #------------------------------------------------------
        # Dependent variables
        #------------------------------------------------------
        #---------------------------------------------------
        # Gear 
        #---------------------------------------------------
        # --- Gear Profile ---
        self.h_a          = 1 * self.module
        self.h_b          = 1.25 * self.module
        self.h_f          = 1.25 * self.module
        self.clr_tip_root = self.h_f - self.h_a

        self.dp_s      = self.module * self.Ns
        self.db_s      = self.dp_s * np.cos((self.pressure_angle))
        self.alpha_s   = (np.sqrt(self.dp_s ** 2 - self.db_s ** 2) / self.db_s) * 180 / np.pi - self.pressure_angle_deg
        self.beta_s    = (360 / (4 * self.Ns) - self.alpha_s) * 2
        self.fw_s_calc = self.compoundPlanetaryGearbox.fwSunMM

        self.dp_p_b    = self.module * self.Np_b
        self.db_p_b    = self.dp_p_b * np.cos((self.pressure_angle))
        self.alpha_p_b = (np.sqrt(self.dp_p_b ** 2 - self.db_p_b ** 2) / self.db_p_b) * 180 / np.pi - self.pressure_angle_deg
        self.beta_p_b  = (360 / (4 * self.Np_b) - self.alpha_p_b) * 2
        self.fw_p_b    = self.compoundPlanetaryGearbox.fwPlanetBigMM
        
        self.dp_r    = self.module * self.Nr
        self.db_r    = self.dp_r * np.cos((self.pressure_angle))
        self.alpha_r = (np.sqrt(self.dp_r ** 2 - self.db_r ** 2) / self.db_r) * 180 / np.pi - self.pressure_angle_deg
        self.beta_r  = (360 / (4 * self.Nr) + self.alpha_r) * 2
        self.fw_r    = self.compoundPlanetaryGearbox.fwRingMM

        self.dp_p_s    = self.module * self.Np_s
        self.db_p_s    = self.dp_p_s * np.cos((self.pressure_angle))
        self.alpha_p_s = (np.sqrt(self.dp_p_s ** 2 - self.db_p_s ** 2) / self.db_p_s) * 180 / np.pi - self.pressure_angle_deg
        self.beta_p_s  = (360 / (4 * self.Np_s) - self.alpha_p_s) * 2
        self.fw_p_s    = self.fw_r + self.clearance_planet

        # --- Motor ---
        motor_output_hole_bolt = nuts_and_bolts_dimensions(bolt_dia = self.motor_output_hole_dia, bolt_type="CSK")

        self.motor_output_hole_CSK_OD          = motor_output_hole_bolt.bolt_head_dia   
        self.motor_output_hole_CSK_head_height = motor_output_hole_bolt.bolt_head_height

        # --- Planet Pin and Bearing ---
        planet_pin_bolt = nuts_and_bolts_dimensions(bolt_dia=self.planet_pin_bolt_dia, bolt_type="socket_head")

        self.planet_pin_socket_head_dia  = planet_pin_bolt.bolt_head_dia # 8.5
        self.planet_pin_bolt_wrench_size = planet_pin_bolt.nut_width_across_flats # 8        

        # --- Sun coupler and sun central bolt ---
        sun_central_bolt = nuts_and_bolts_dimensions(bolt_dia = self.sun_central_bolt_dia, bolt_type="socket_head")
        self.sun_central_bolt_socket_head_dia = sun_central_bolt.bolt_head_dia # 8.5
        
        self.sun_hub_dia = self.motor_output_hole_PCD + self.motor_output_hole_dia + self.standard_clearance_1_5mm * 4

        #----------------------- Bearings------------------------------------
        IdrequiredMM = self.module * (self.Ns + self.Np_b) + self.bearingIDClearanceMM
        Bearings            = bearings_discrete(IdrequiredMM)
        self.bearing_ID     = Bearings.getBearingIDMM()
        self.bearing_OD     = Bearings.getBearingODMM()
        self.bearing_height = Bearings.getBearingWidthMM()

        #------------------- Carrier & Sec Carrier-----------------------------
        self.carrier_PCD = (self.Np_b + self.Ns) * self.module
        
        carrier_trapezoidal_support_hole = nuts_and_bolts_dimensions(bolt_dia=self.carrier_trapezoidal_support_hole_dia, bolt_type="socket_head")

        self.carrier_trapezoidal_support_hole_socket_head_dia = carrier_trapezoidal_support_hole.bolt_head_dia
        self.carrier_trapezoidal_support_hole_wrench_size     = carrier_trapezoidal_support_hole.nut_width_across_flats        

        #--------------------- Casings------------------------------------------
        case_mounting_hole_bolt = nuts_and_bolts_dimensions(bolt_dia=self.case_mounting_hole_dia, bolt_type="socket_head")

        self.case_mounting_hole_allen_socket_dia = case_mounting_hole_bolt.bolt_head_dia # 5.5
        self.case_mounting_wrench_size           = case_mounting_hole_bolt.nut_width_across_flats # 5.5
        self.case_mounting_nut_thickness         = case_mounting_hole_bolt.nut_thickness # 2.4

        output_mounting_hole_bolt = nuts_and_bolts_dimensions(bolt_dia=self.output_mounting_hole_dia, bolt_type="socket_head")

        self.output_mounting_nut_thickness   = output_mounting_hole_bolt.nut_thickness # 3.2
        self.output_mounting_nut_wrench_size = output_mounting_hole_bolt.nut_width_across_flats # 7

        self.case_dist = self.sec_carrier_thickness + self.clearance_planet * 2 + self.sun_coupler_hub_thickness + self.fw_p_b - self.case_mounting_surface_height
        self.case_mounting_hole_shift = self.case_mounting_hole_dia / 2 - 0.5

        # IIF: clearance_motor_and_case
        if (self.Ns + self.Np_b * 2) * self.module < self.motor_OD:
            self.clearance_motor_and_case = 5
        else:
            self.clearance_motor_and_case = ((self.Ns + self.Np_b * 2) * self.module - self.motor_OD) * 0.5 + 5

        self.Motor_case_ID = self.motor_OD + self.clearance_motor_and_case * 2
        self.motor_case_OD_base = self.motor_OD + self.clearance_motor_and_case * 2 + self.Motor_case_thickness * 2
        self.case_mounting_PCD = self.motor_case_OD_base + self.case_mounting_hole_shift * 2
        self.Motor_case_OD_max = self.case_mounting_PCD + self.case_mounting_hole_allen_socket_dia + self.clearance_case_mount_holes_shell_thickness * 2

        # IIF: bearing_mount_thickness
        if (self.bearing_OD + self.output_mounting_hole_dia * 4) > (self.Nr * self.module + 2 * self.h_b):
            self.bearing_mount_thickness = self.output_mounting_hole_dia * 2
        else:
            self.bearing_mount_thickness = ((self.Nr * self.module + 2 * self.h_b - (self.bearing_OD + self.output_mounting_hole_dia * 4)) / 2) + self.output_mounting_hole_dia * 2 + self.standard_clearance_1_5mm

        self.output_mounting_PCD = self.bearing_OD + self.bearing_mount_thickness

        # IIF: ring_radial_thickness
        if self.Nr * self.module + 5 * 2 > self.bearing_OD:
            self.ring_radial_thickness = 5
        else:
            self.ring_radial_thickness = (self.bearing_OD + self.standard_clearance_1_5mm * 2 - self.Nr * self.module) / 2

        self.ring_OD = self.Nr * self.module + self.ring_radial_thickness * 2

        #-----
        self.actuator_width =  (self.fw_r
                               + self.clearance_planet
                               + self.bearing_height
                               + self.clearance_planet
                               + self.case_dist
                               + self.bearing_retainer_thickness
                               + self.motor_height
                               + self.case_mounting_surface_height
                               + self.standard_clearance_1_5mm
                               + self.base_plate_thickness)
                                                               
        self.fw_s_used = self.fw_p_s + self.fw_p_b + self.clearance_planet + self.sec_carrier_thickness + self.standard_clearance_1_5mm
    def genEquationFile(self, motor_name="NO_MOTOR", gearRatioLL = 0.0, gearRatioUL = 0.0):
        # writing values into text file imported which is imported into solidworks
        self.setVariables()
        file_path = os.path.join(os.path.dirname(__file__), 'CADs', 'CPG', 'Equation_Files', motor_name, f'cpg_equations_{gearRatioLL}_{gearRatioUL}.txt')
        with open(file_path, 'w') as eqFile:
            l = [
                    f'"Ns"= {self.Ns}\n',
                    f'"Np_b"= {self.Np_b}\n',
                    f'"Np_s"= {self.Np_s}\n',
                    f'"Nr"= {self.Nr}\n',
                    f'"num_planet"= {self.num_planet}\n',
                    f'"module"= {self.module}\n',
                    f'"motor_OD"= {self.motor_OD}\n',
                    f'"motor_height"= {self.motor_height}\n',
                    f'"pressure_angle"= {self.pressure_angle_deg}\n',
                    f'"pressure angle"= {self.pressure_angle_deg}\n',
                    f'"h_a"= {self.h_a}\n',
                    f'"h_b"= {self.h_b}\n',
                    f'"clr_tip_root"= {self.clr_tip_root}\n',
                    f'"dp_s"= {self.dp_s}\n',
                    f'"db_s"= {self.db_s}\n',
                    f'"fw_s_calc"= {self.fw_s_calc}\n',
                    f'"alpha_s"= {self.alpha_s}\n',
                    f'"beta_s"= {self.beta_s}\n',
                    f'"dp_p_b"= {self.dp_p_b}\n',
                    f'"db_p_b"= {self.db_p_b}\n',
                    f'"fw_p_s"= {self.fw_p_s}\n',
                    f'"alpha_p_b"= {self.alpha_p_b}\n',
                    f'"beta_p_b"= {self.beta_p_b}\n',
                    f'"h_f"= {self.h_f}\n',
                    f'"dp_r"= {self.dp_r}\n',
                    f'"db_r"= {self.db_r}\n',
                    f'"fw_r"= {self.fw_r}\n',
                    f'"alpha_r"= {self.alpha_r}\n',
                    f'"beta_r"= {self.beta_r}\n',
                    f'"bearing_ID"= {self.bearing_ID}\n',
                    f'"bearing_OD"= {self.bearing_OD}\n',
                    f'"bearing_height"= {self.bearing_height}\n',
                    f'"clearance_planet"= {self.clearance_planet}\n',
                    f'"case_dist"= {self.case_dist}\n',
                    f'"Motor_case_OD_max"= {self.Motor_case_OD_max}\n',
                    f'"case_mounting_PCD"= {self.case_mounting_PCD}\n',
                    f'"bearing_mount_thickness"= {self.bearing_mount_thickness}\n',
                    f'"case_mounting_hole_dia"= {self.case_mounting_hole_dia}\n',
                    f'"output_mounting_PCD"= {self.output_mounting_PCD}\n',
                    f'"output_mounting_hole_dia"= {self.output_mounting_hole_dia}\n',
                    f'"clearance_case_mount_holes_shell_thickness"= {self.clearance_case_mount_holes_shell_thickness}\n',
                    f'"motor_case_OD_base"= {self.motor_case_OD_base}\n',
                    f'"sec_carrier_thickness"= {self.sec_carrier_thickness}\n',
                    f'"sun_coupler_hub_thickness"= {self.sun_coupler_hub_thickness}\n',
                    f'"clearance_sun_coupler_sec_carrier"= {self.clearance_sun_coupler_sec_carrier}\n',
                    f'"clearance_motor_and_case"= {self.clearance_motor_and_case}\n',
                    f'"Motor_case_thickness"= {self.Motor_case_thickness}\n',
                    f'"Motor_case_ID"= {self.Motor_case_ID}\n',
                    f'"case_mounting_hole_shift"= {self.case_mounting_hole_shift}\n',
                    f'"output_mounting_nut_wrench_size"= {self.output_mounting_nut_wrench_size}\n',
                    f'"output_mounting_nut_thickness"= {self.output_mounting_nut_thickness}\n',
                    f'"case_mounting_hole_allen_socket_dia"= {self.case_mounting_hole_allen_socket_dia}\n',
                    f'"output_mounting_nut_depth"= {self.output_mounting_nut_depth}\n',
                    f'"case_mounting_bolt_depth"= {self.case_mounting_bolt_depth}\n',
                    f'"ring_radial_thickness"= {self.ring_radial_thickness}\n',
                    f'"ring_OD"= {self.ring_OD}\n',
                    f'"ring_to_chamfer_clearance"= {self.ring_to_chamfer_clearance}\n',
                    f'"Motor_case_OD_base_to_chamfer"= {self.Motor_case_OD_base_to_chamfer}\n',
                    f'"pattern_offset_from_motor_case_OD_base"= {self.pattern_offset_from_motor_case_OD_base}\n',
                    f'"pattern_bulge_dia"= {self.pattern_bulge_dia}\n',
                    f'"pattern_num_bulge"= {self.pattern_num_bulge}\n',
                    f'"pattern_depth"= {self.pattern_depth}\n',
                    f'"case_mounting_wrench_size"= {self.case_mounting_wrench_size}\n',
                    f'"case_mounting_nut_clearance"= {self.case_mounting_nut_clearance}\n',
                    f'"base_plate_thickness"= {self.base_plate_thickness}\n',
                    f'"case_mounting_nut_thickness"= {self.case_mounting_nut_thickness}\n',
                    f'"case_mounting_surface_height"= {self.case_mounting_surface_height}\n',
                    f'"motor_mount_hole_PCD"= {self.motor_mount_hole_PCD}\n',
                    f'"motor_mount_hole_dia"= {self.motor_mount_hole_dia}\n',
                    f'"motor_mount_hole_num"= {self.motor_mount_hole_num}\n',
                    f'"central_hole_offset_from_motor_mount_PCD"= {self.central_hole_offset_from_motor_mount_PCD}\n',
                    f'"wire_slot_dist_from_center"= {self.wire_slot_dist_from_center}\n',
                    f'"wire_slot_length"= {self.wire_slot_length}\n',
                    f'"wire_slot_radius"= {self.wire_slot_radius}\n',
                    f'"driver_upper_holes_dist_from_center"= {self.driver_upper_holes_dist_from_center}\n',
                    f'"driver_lower_holes_dist_from_center"= {self.driver_lower_holes_dist_from_center}\n',
                    f'"driver_side_holes_dist_from_center"= {self.driver_side_holes_dist_from_center}\n',
                    f'"driver_mount_holes_dia"= {self.driver_mount_holes_dia}\n',
                    f'"driver_mount_inserts_OD"= {self.driver_mount_inserts_OD}\n',
                    f'"driver_mount_thickness"= {self.driver_mount_thickness}\n',
                    f'"driver_mount_height"= {self.driver_mount_height}\n',
                    f'"air_flow_hole_offset"= {self.air_flow_hole_offset}\n',
                    f'"planet_pin_bolt_dia"= {self.planet_pin_bolt_dia}\n',
                    f'"planet_pin_socket_head_dia"= {self.planet_pin_socket_head_dia}\n',
                    f'"carrier_PCD"= {self.carrier_PCD}\n',
                    f'"planet_shaft_dia"= {self.planet_shaft_dia}\n',
                    f'"planet_shaft_step_offset"= {self.planet_shaft_step_offset}\n',
                    f'"carrier_trapezoidal_support_sun_offset"= {self.carrier_trapezoidal_support_sun_offset}\n',
                    f'"carrier_trapezoidal_support_hole_PCD_offset_bearing_ID"= {self.carrier_trapezoidal_support_hole_PCD_offset_bearing_ID}\n',
                    f'"carrier_trapezoidal_support_hole_dia"= {self.carrier_trapezoidal_support_hole_dia}\n',
                    f'"carrier_trapezoidal_support_hole_socket_head_dia"= {self.carrier_trapezoidal_support_hole_socket_head_dia}\n',
                    f'"carrier_bearing_step_width"= {self.carrier_bearing_step_width}\n',
                    f'"standard_clearance_1_5mm"= {self.standard_clearance_1_5mm}\n',
                    f'"standard_fillet_1_5mm"= {self.standard_fillet_1_5mm}\n',
                    f'"sun_shaft_bearing_OD"= {self.sun_shaft_bearing_OD}\n',
                    f'"sun_shaft_bearing_width"= {self.sun_shaft_bearing_width}\n',
                    f'"standard_bearing_insertion_chamfer"= {self.standard_bearing_insertion_chamfer}\n',
                    f'"carrier_trapezoidal_support_hole_wrench_size"= {self.carrier_trapezoidal_support_hole_wrench_size}\n',
                    f'"planet_pin_bolt_wrench_size"= {self.planet_pin_bolt_wrench_size}\n',
                    f'"planet_bearing_OD"= {self.planet_bearing_OD}\n',
                    f'"planet_bearing_width"= {self.planet_bearing_width}\n',
                    f'"planet_bore"= {self.planet_bore}\n',
                    f'"motor_output_hole_PCD"= {self.motor_output_hole_PCD}\n',
                    f'"motor_output_hole_dia"= {self.motor_output_hole_dia}\n',
                    f'"motor_output_hole_num"= {self.motor_output_hole_num}\n',
                    f'"sun_shaft_bearing_ID"= {self.sun_shaft_bearing_ID}\n',
                    f'"sun_hub_dia"= {self.sun_hub_dia}\n',
                    f'"sun_central_bolt_dia"= {self.sun_central_bolt_dia}\n',
                    f'"sun_central_bolt_socket_head_dia"= {self.sun_central_bolt_socket_head_dia}\n',
                    f'"fw_s_used"= {self.fw_s_used}\n',
                    f'"motor_output_hole_CSK_OD"= {self.motor_output_hole_CSK_OD}\n',
                    f'"motor_output_hole_CSK_head_height"= {self.motor_output_hole_CSK_head_height}\n',
                    f'"bearing_retainer_thickness"= {self.bearing_retainer_thickness}\n',
                    f'"fw_p_b"= {self.fw_p_b}\n',
                    f'"dp_p_s"= {self.dp_p_s}\n',
                    f'"db_p_s"= {self.db_p_s}\n',
                    f'"alpha_p_s"= {self.alpha_p_s}\n',
                    f'"beta_p_s"= {self.beta_p_s}\n',
                    f'"tight_clearance_3DP" = {self.tight_clearance_3DP}\n',
                    f'"loose_clearance_3DP" = {self.loose_clearance_3DP}\n' 
            ]
            eqFile.writelines(l)
        eqFile.close()

    def genEquationFile_editCADdirectly(self):
        # writing values into text file imported which is imported into solidworks
        self.setVariables()
        file_path = os.path.join(os.path.dirname(__file__), 'CADs', 'CPG', 'cpg_equations.txt')
        with open(file_path, 'w') as eqFile:
            l = [
                    f'"Ns"= {self.Ns}\n',
                    f'"Np_b"= {self.Np_b}\n',
                    f'"Np_s"= {self.Np_s}\n',
                    f'"Nr"= {self.Nr}\n',
                    f'"num_planet"= {self.num_planet}\n',
                    f'"module"= {self.module}\n',
                    f'"motor_OD"= {self.motor_OD}\n',
                    f'"motor_height"= {self.motor_height}\n',
                    f'"pressure_angle"= {self.pressure_angle_deg}\n',
                    f'"pressure angle"= {self.pressure_angle_deg}\n',
                    f'"h_a"= {self.h_a}\n',
                    f'"h_b"= {self.h_b}\n',
                    f'"clr_tip_root"= {self.clr_tip_root}\n',
                    f'"dp_s"= {self.dp_s}\n',
                    f'"db_s"= {self.db_s}\n',
                    f'"fw_s_calc"= {self.fw_s_calc}\n',
                    f'"alpha_s"= {self.alpha_s}\n',
                    f'"beta_s"= {self.beta_s}\n',
                    f'"dp_p_b"= {self.dp_p_b}\n',
                    f'"db_p_b"= {self.db_p_b}\n',
                    f'"fw_p_s"= {self.fw_p_s}\n',
                    f'"alpha_p_b"= {self.alpha_p_b}\n',
                    f'"beta_p_b"= {self.beta_p_b}\n',
                    f'"h_f"= {self.h_f}\n',
                    f'"dp_r"= {self.dp_r}\n',
                    f'"db_r"= {self.db_r}\n',
                    f'"fw_r"= {self.fw_r}\n',
                    f'"alpha_r"= {self.alpha_r}\n',
                    f'"beta_r"= {self.beta_r}\n',
                    f'"bearing_ID"= {self.bearing_ID}\n',
                    f'"bearing_OD"= {self.bearing_OD}\n',
                    f'"bearing_height"= {self.bearing_height}\n',
                    f'"clearance_planet"= {self.clearance_planet}\n',
                    f'"case_dist"= {self.case_dist}\n',
                    f'"Motor_case_OD_max"= {self.Motor_case_OD_max}\n',
                    f'"case_mounting_PCD"= {self.case_mounting_PCD}\n',
                    f'"bearing_mount_thickness"= {self.bearing_mount_thickness}\n',
                    f'"case_mounting_hole_dia"= {self.case_mounting_hole_dia}\n',
                    f'"output_mounting_PCD"= {self.output_mounting_PCD}\n',
                    f'"output_mounting_hole_dia"= {self.output_mounting_hole_dia}\n',
                    f'"clearance_case_mount_holes_shell_thickness"= {self.clearance_case_mount_holes_shell_thickness}\n',
                    f'"motor_case_OD_base"= {self.motor_case_OD_base}\n',
                    f'"sec_carrier_thickness"= {self.sec_carrier_thickness}\n',
                    f'"sun_coupler_hub_thickness"= {self.sun_coupler_hub_thickness}\n',
                    f'"clearance_sun_coupler_sec_carrier"= {self.clearance_sun_coupler_sec_carrier}\n',
                    f'"clearance_motor_and_case"= {self.clearance_motor_and_case}\n',
                    f'"Motor_case_thickness"= {self.Motor_case_thickness}\n',
                    f'"Motor_case_ID"= {self.Motor_case_ID}\n',
                    f'"case_mounting_hole_shift"= {self.case_mounting_hole_shift}\n',
                    f'"output_mounting_nut_wrench_size"= {self.output_mounting_nut_wrench_size}\n',
                    f'"output_mounting_nut_thickness"= {self.output_mounting_nut_thickness}\n',
                    f'"case_mounting_hole_allen_socket_dia"= {self.case_mounting_hole_allen_socket_dia}\n',
                    f'"output_mounting_nut_depth"= {self.output_mounting_nut_depth}\n',
                    f'"case_mounting_bolt_depth"= {self.case_mounting_bolt_depth}\n',
                    f'"ring_radial_thickness"= {self.ring_radial_thickness}\n',
                    f'"ring_OD"= {self.ring_OD}\n',
                    f'"ring_to_chamfer_clearance"= {self.ring_to_chamfer_clearance}\n',
                    f'"Motor_case_OD_base_to_chamfer"= {self.Motor_case_OD_base_to_chamfer}\n',
                    f'"pattern_offset_from_motor_case_OD_base"= {self.pattern_offset_from_motor_case_OD_base}\n',
                    f'"pattern_bulge_dia"= {self.pattern_bulge_dia}\n',
                    f'"pattern_num_bulge"= {self.pattern_num_bulge}\n',
                    f'"pattern_depth"= {self.pattern_depth}\n',
                    f'"case_mounting_wrench_size"= {self.case_mounting_wrench_size}\n',
                    f'"case_mounting_nut_clearance"= {self.case_mounting_nut_clearance}\n',
                    f'"base_plate_thickness"= {self.base_plate_thickness}\n',
                    f'"case_mounting_nut_thickness"= {self.case_mounting_nut_thickness}\n',
                    f'"case_mounting_surface_height"= {self.case_mounting_surface_height}\n',
                    f'"motor_mount_hole_PCD"= {self.motor_mount_hole_PCD}\n',
                    f'"motor_mount_hole_dia"= {self.motor_mount_hole_dia}\n',
                    f'"motor_mount_hole_num"= {self.motor_mount_hole_num}\n',
                    f'"central_hole_offset_from_motor_mount_PCD"= {self.central_hole_offset_from_motor_mount_PCD}\n',
                    f'"wire_slot_dist_from_center"= {self.wire_slot_dist_from_center}\n',
                    f'"wire_slot_length"= {self.wire_slot_length}\n',
                    f'"wire_slot_radius"= {self.wire_slot_radius}\n',
                    f'"driver_upper_holes_dist_from_center"= {self.driver_upper_holes_dist_from_center}\n',
                    f'"driver_lower_holes_dist_from_center"= {self.driver_lower_holes_dist_from_center}\n',
                    f'"driver_side_holes_dist_from_center"= {self.driver_side_holes_dist_from_center}\n',
                    f'"driver_mount_holes_dia"= {self.driver_mount_holes_dia}\n',
                    f'"driver_mount_inserts_OD"= {self.driver_mount_inserts_OD}\n',
                    f'"driver_mount_thickness"= {self.driver_mount_thickness}\n',
                    f'"driver_mount_height"= {self.driver_mount_height}\n',
                    f'"air_flow_hole_offset"= {self.air_flow_hole_offset}\n',
                    f'"planet_pin_bolt_dia"= {self.planet_pin_bolt_dia}\n',
                    f'"planet_pin_socket_head_dia"= {self.planet_pin_socket_head_dia}\n',
                    f'"carrier_PCD"= {self.carrier_PCD}\n',
                    f'"planet_shaft_dia"= {self.planet_shaft_dia}\n',
                    f'"planet_shaft_step_offset"= {self.planet_shaft_step_offset}\n',
                    f'"carrier_trapezoidal_support_sun_offset"= {self.carrier_trapezoidal_support_sun_offset}\n',
                    f'"carrier_trapezoidal_support_hole_PCD_offset_bearing_ID"= {self.carrier_trapezoidal_support_hole_PCD_offset_bearing_ID}\n',
                    f'"carrier_trapezoidal_support_hole_dia"= {self.carrier_trapezoidal_support_hole_dia}\n',
                    f'"carrier_trapezoidal_support_hole_socket_head_dia"= {self.carrier_trapezoidal_support_hole_socket_head_dia}\n',
                    f'"carrier_bearing_step_width"= {self.carrier_bearing_step_width}\n',
                    f'"standard_clearance_1_5mm"= {self.standard_clearance_1_5mm}\n',
                    f'"standard_fillet_1_5mm"= {self.standard_fillet_1_5mm}\n',
                    f'"sun_shaft_bearing_OD"= {self.sun_shaft_bearing_OD}\n',
                    f'"sun_shaft_bearing_width"= {self.sun_shaft_bearing_width}\n',
                    f'"standard_bearing_insertion_chamfer"= {self.standard_bearing_insertion_chamfer}\n',
                    f'"carrier_trapezoidal_support_hole_wrench_size"= {self.carrier_trapezoidal_support_hole_wrench_size}\n',
                    f'"planet_pin_bolt_wrench_size"= {self.planet_pin_bolt_wrench_size}\n',
                    f'"planet_bearing_OD"= {self.planet_bearing_OD}\n',
                    f'"planet_bearing_width"= {self.planet_bearing_width}\n',
                    f'"planet_bore"= {self.planet_bore}\n',
                    f'"motor_output_hole_PCD"= {self.motor_output_hole_PCD}\n',
                    f'"motor_output_hole_dia"= {self.motor_output_hole_dia}\n',
                    f'"motor_output_hole_num"= {self.motor_output_hole_num}\n',
                    f'"sun_shaft_bearing_ID"= {self.sun_shaft_bearing_ID}\n',
                    f'"sun_hub_dia"= {self.sun_hub_dia}\n',
                    f'"sun_central_bolt_dia"= {self.sun_central_bolt_dia}\n',
                    f'"sun_central_bolt_socket_head_dia"= {self.sun_central_bolt_socket_head_dia}\n',
                    f'"fw_s_used"= {self.fw_s_used}\n',
                    f'"motor_output_hole_CSK_OD"= {self.motor_output_hole_CSK_OD}\n',
                    f'"motor_output_hole_CSK_head_height"= {self.motor_output_hole_CSK_head_height}\n',
                    f'"bearing_retainer_thickness"= {self.bearing_retainer_thickness}\n',
                    f'"fw_p_b"= {self.fw_p_b}\n',
                    f'"dp_p_s"= {self.dp_p_s}\n',
                    f'"db_p_s"= {self.db_p_s}\n',
                    f'"alpha_p_s"= {self.alpha_p_s}\n',
                    f'"beta_p_s"= {self.beta_p_s}\n',
                    f'"tight_clearance_3DP" = {self.tight_clearance_3DP}\n',
                    f'"loose_clearance_3DP" = {self.loose_clearance_3DP}\n' 
            ]
            eqFile.writelines(l)
        eqFile.close()

    #--------------------------------------------
    # Gear tooth stress analysis
    #--------------------------------------------
    def getToothForces(self, constraintCheck=True):
        if constraintCheck:
            # Check if the constraints are satisfied
            if not self.compoundPlanetaryGearbox.geometricConstraint():
                print("Geometric constraint not satisfied")
                return
            if not self.compoundPlanetaryGearbox.meshingConstraint():
                print("Meshing constraint not satisfied")
                return
            if not self.compoundPlanetaryGearbox.noPlanetInterferenceConstraint():
                print("No planet interference constraint not satisfied")
                return

        Ns          = self.compoundPlanetaryGearbox.Ns
        NpBig       = self.compoundPlanetaryGearbox.NpBig
        NpSmall     = self.compoundPlanetaryGearbox.NpSmall
        Nr          = self.compoundPlanetaryGearbox.Nr
        numPlanet   = self.compoundPlanetaryGearbox.numPlanet
        moduleBig   = self.compoundPlanetaryGearbox.moduleBig
        moduleSmall = self.compoundPlanetaryGearbox.moduleSmall

        Rs_Mt = self.compoundPlanetaryGearbox.getPCRadiusSunM()
        RpBig_Mt = self.compoundPlanetaryGearbox.getPCRadiusPlanetBigM()
        RpSmall_Mt = self.compoundPlanetaryGearbox.getPCRadiusPlanetSmallM()
        Rr_Mt = self.compoundPlanetaryGearbox.getPCRadiusRingM()

        wSun     = self.motor.getMaxMotorAngVelRadPerSec()
        wPlanet  = (-Ns / (NpBig + NpSmall) ) * wSun
        wCarrier = wSun/self.compoundPlanetaryGearbox.gearRatio()

        Ft_sp = (self.serviceFactor*self.motor.getMaxMotorTorque()) / (numPlanet * Rs_Mt)
        Ft_rp = ((self.serviceFactor*self.motor.getMaxMotorTorque()) * RpBig_Mt) / (numPlanet * 2 * Rs_Mt * RpSmall_Mt)

        Ft = [Ft_sp, Ft_rp]
        return Ft

    def lewisStressAnalysisMinFacewidth(self):
        # Check if the constraints are satisfied
        if not self.compoundPlanetaryGearbox.geometricConstraint():
            print("Geometric constraint not satisfied")
            return
        if not self.compoundPlanetaryGearbox.meshingConstraint():
            print("Meshing constraint not satisfied")
            return
        if not self.compoundPlanetaryGearbox.noPlanetInterferenceConstraint():
            print("No planet interference constraint not satisfied")
            return

        Ns          = self.compoundPlanetaryGearbox.Ns
        NpBig       = self.compoundPlanetaryGearbox.NpBig
        NpSmall     = self.compoundPlanetaryGearbox.NpSmall
        Nr          = self.compoundPlanetaryGearbox.Nr
        numPlanet   = self.compoundPlanetaryGearbox.numPlanet
        moduleBig   = self.compoundPlanetaryGearbox.moduleBig
        moduleSmall = self.compoundPlanetaryGearbox.moduleSmall

        wSun     = self.motor.getMaxMotorAngVelRadPerSec()
        wPlanet  = (-Ns / (NpBig + NpSmall) ) * wSun
        wCarrier = wSun/self.compoundPlanetaryGearbox.gearRatio()

        [Ft_sp, Ft_rp] = self.getToothForces(constraintCheck=False)

        ySun         = 0.154 - 0.912/Ns
        yPlanetBig   = 0.154 - 0.912/NpBig
        yPlanetSmall = 0.154 - 0.912/NpSmall
        yRing        = 0.154 - 0.912/Nr

        V_sp = (self.compoundPlanetaryGearbox.getPCRadiusSunM() * wSun)
        V_rp = (wCarrier*(self.compoundPlanetaryGearbox.getPCRadiusSunM() + self.compoundPlanetaryGearbox.getPCRadiusPlanetBigM()) + 
                wPlanet*(self.compoundPlanetaryGearbox.getPCRadiusPlanetSmallM()))
        
        if V_sp <= 7.5:
            Kv_sun = 3/(3+V_sp)
            Kv_planetBig = 3/(3+V_sp)
        # elif V_sp > 7.5 and V_sp <= 12.5:
        else:
            Kv_sun = 4.5/(4.5 + V_sp)
            Kv_planetBig = 4.5/(4.5 + V_sp)

        if V_rp <= 7.5:
            Kv_planetSmall = 3/(3+V_rp)
            Kv_ring = 3/(3+V_rp)
        elif V_rp > 7.5 and V_rp <= 12.5:
            Kv_planetSmall = 4.5/(4.5 + V_rp)
            Kv_ring = 4.5/(4.5 + V_rp)

        P_big   = np.pi*moduleBig*0.001 # m
        P_small = np.pi*moduleSmall*0.001 # m

        # Lewis static load capacity
        bMin_sun         = (self.FOS * Ft_sp / (self.compoundPlanetaryGearbox.maxGearAllowableStressPa * ySun * Kv_sun * P_big)) # m
        bMin_planetBig   = (self.FOS * Ft_sp / (self.compoundPlanetaryGearbox.maxGearAllowableStressPa * yPlanetBig * Kv_planetBig * P_big))
        bMin_planetSmall = (self.FOS * Ft_rp / (self.compoundPlanetaryGearbox.maxGearAllowableStressPa * yPlanetSmall * Kv_planetSmall * P_small))
        bMin_ring        = (self.FOS * Ft_rp / (self.compoundPlanetaryGearbox.maxGearAllowableStressPa * yRing * Kv_ring * P_small))

        if bMin_ring < bMin_planetSmall:
            bMin_ring = bMin_planetSmall
        else:
            bMin_planetSmall = bMin_ring

        self.compoundPlanetaryGearbox.setfwSunMM(bMin_sun*1000)
        self.compoundPlanetaryGearbox.setfwPlanetBigMM(bMin_planetBig*1000)
        self.compoundPlanetaryGearbox.setfwPlanetSmallMM(bMin_planetSmall*1000)
        self.compoundPlanetaryGearbox.setfwRingMM(bMin_ring*1000)

        # print(f"Lewis:")
        # print(f"bMin_planetSmall = {bMin_planetSmall}")
        # print(f"bMin_planetBig = {bMin_planetBig}")
        # print(f"bMin_sun = {bMin_sun}")
        # print(f"bMin_ring = {bMin_ring}")

    def mitStressAnalysisMinFacewidth(self):
        if not self.compoundPlanetaryGearbox.geometricConstraint():
            print("Geometric constraint not satisfied")
            return
        if not self.compoundPlanetaryGearbox.meshingConstraint():
            print("Meshing constraint not satisfied")
            return
        if not self.compoundPlanetaryGearbox.noPlanetInterferenceConstraint():
            print("No planet interference constraint not satisfied")
            return

        Ns          = self.compoundPlanetaryGearbox.Ns
        NpBig       = self.compoundPlanetaryGearbox.NpBig
        NpSmall     = self.compoundPlanetaryGearbox.NpSmall
        Nr          = self.compoundPlanetaryGearbox.Nr
        numPlanet   = self.compoundPlanetaryGearbox.numPlanet
        moduleBig   = self.compoundPlanetaryGearbox.moduleBig
        moduleSmall = self.compoundPlanetaryGearbox.moduleSmall

        wSun     = self.motor.getMaxMotorAngVelRadPerSec()
        wPlanet  = (-Ns / (NpBig + NpSmall) ) * wSun
        wCarrier = wSun/self.compoundPlanetaryGearbox.gearRatio()

        [Ft_sp, Ft_rp] = self.getToothForces(constraintCheck=False)

        # Lewis static load capacity
        _,_,CR_SP = self.compoundPlanetaryGearbox.contactRatio_sunPlanet()
        _,_,CR_PR = self.compoundPlanetaryGearbox.contactRatio_planetRing()

        qe1 = 1 / CR_SP
        qe2 = 1 / CR_PR

        # qk = 1.85 + 0.35 * (np.log(Ns) / np.log(100)) 
        qk1 = (7.65734266e-08 * Ns**4
             - 2.19500130e-05 * Ns**3
             + 2.33893357e-03 * Ns**2
             - 1.13320908e-01 * Ns
             + 4.44727778)
        qk2 = (7.65734266e-08 * NpSmall**4
             - 2.19500130e-05 * NpSmall**3
             + 2.33893357e-03 * NpSmall**2
             - 1.13320908e-01 * NpSmall
             + 4.44727778)
        
        # Lewis static load capacity
        bMin_sun_mit         = (self.FOS * Ft_sp * qe1 * qk1 / (self.compoundPlanetaryGearbox.maxGearAllowableStressPa * moduleBig * 0.001)) # m
        bMin_planetBig_mit   = (self.FOS * Ft_sp * qe1 * qk1 / (self.compoundPlanetaryGearbox.maxGearAllowableStressPa * moduleBig * 0.001))
        bMin_planetSmall_mit = (self.FOS * Ft_rp * qe2 * qk2 / (self.compoundPlanetaryGearbox.maxGearAllowableStressPa * moduleSmall * 0.001))
        bMin_ring_mit        = (self.FOS * Ft_rp * qe2 * qk2 / (self.compoundPlanetaryGearbox.maxGearAllowableStressPa * moduleSmall * 0.001))

        #------------- Contraint in planet to accomodate its bearings------------------------------------------
        if ((bMin_planetBig_mit + bMin_planetSmall_mit) * 1000 < (self.planet_bearing_width*2 + self.standard_clearance_1_5mm * 2 / 3)) : 
            if ((bMin_planetBig_mit) * 1000 < (self.planet_bearing_width + self.standard_clearance_1_5mm * 1 / 3)): 
                bMin_planetBig_mit = (self.planet_bearing_width + self.standard_clearance_1_5mm * 1 / 3) / 1000
            if ((bMin_planetSmall_mit) * 1000 < (self.planet_bearing_width + self.standard_clearance_1_5mm * 1 / 3)): 
                bMin_planetSmall_mit = (self.planet_bearing_width + self.standard_clearance_1_5mm * 1 / 3) / 1000
            bMin_ring_mit = bMin_planetSmall_mit # FT on both are same

        bMin_sun_mitMM         = bMin_sun_mit * 1000
        bMin_planetBig_mitMM   = bMin_planetBig_mit * 1000
        bMin_planetSmall_mitMM = bMin_planetSmall_mit * 1000
        bMin_ring_mitMM        = bMin_ring_mit * 1000


        self.compoundPlanetaryGearbox.setfwSunMM         ( bMin_sun_mit         * 1000)
        self.compoundPlanetaryGearbox.setfwPlanetBigMM   ( bMin_planetBig_mit   * 1000)
        self.compoundPlanetaryGearbox.setfwPlanetSmallMM ( bMin_planetSmall_mit * 1000)
        self.compoundPlanetaryGearbox.setfwRingMM        ( bMin_ring_mit        * 1000)

        return bMin_sun_mitMM, bMin_planetBig_mitMM, bMin_planetSmall_mitMM, bMin_ring_mitMM

    def AGMAStressAnalysisMinFacewidth(self):
        # Check if the constraints are satisfied
        if not self.compoundPlanetaryGearbox.geometricConstraint():
            print("Geometric constraint not satisfied")
            return
        if not self.compoundPlanetaryGearbox.meshingConstraint():
            print("Meshing constraint not satisfied")
            return
        if not self.compoundPlanetaryGearbox.noPlanetInterferenceConstraint():
            print("No planet interference constraint not satisfied")
            return

        Ns          = self.compoundPlanetaryGearbox.Ns
        NpBig       = self.compoundPlanetaryGearbox.NpBig
        NpSmall     = self.compoundPlanetaryGearbox.NpSmall
        Nr          = self.compoundPlanetaryGearbox.Nr
        numPlanet   = self.compoundPlanetaryGearbox.numPlanet
        moduleBig   = self.compoundPlanetaryGearbox.moduleBig
        moduleSmall = self.compoundPlanetaryGearbox.moduleSmall

        wSun     = self.motor.getMaxMotorAngVelRadPerSec()
        wPlanet  = (-Ns / (NpBig + NpSmall) ) * wSun
        wCarrier = wSun/self.compoundPlanetaryGearbox.gearRatio()

        pressureAngle = self.compoundPlanetaryGearbox.pressureAngleDEG

        [Wt_sp, Wt_rp] = self.getToothForces(constraintCheck=False)

        # T Krishna Rao - Design of Machine Elements - II pg.191
        # Modified Lewis Form Factor Y = pi*y for pressure angle = 20
        Y_sun         = (0.154 - 0.912 / Ns) * np.pi
        Y_planetBig   = (0.154 - 0.912 / NpBig) * np.pi
        Y_planetSmall = (0.154 - 0.912 / NpSmall) * np.pi
        Y_ring        = (0.154 - 0.912 / Nr) * np.pi

        V_sp = abs(self.compoundPlanetaryGearbox.getPCRadiusSunM() * wSun)
        V_rp = abs(wCarrier*(self.compoundPlanetaryGearbox.getPCRadiusSunM() + self.compoundPlanetaryGearbox.getPCRadiusPlanetBigM()) + 
                wPlanet*(self.compoundPlanetaryGearbox.getPCRadiusPlanetSmallM()))
        
        # AGMA 908-B89 pg.16
        # Kf Fatigue stress concentration factor
        H = 0.331 - (0.436 * np.pi * pressureAngle / 180)
        L = 0.324 - (0.492 * np.pi * pressureAngle / 180)
        M = 0.261 + (0.545 * np.pi * pressureAngle / 180)  
        # t -> tooth thickness, r -> fillet radius and l -> tooth height
        t_planetSmall = (13.5 * Y_planetSmall)**(1/2) * moduleSmall
        r_planetSmall = 0.3 * moduleSmall
        l_planetSmall = 2.25 * moduleSmall
        Kf_planetSmall = H + (t_planetSmall / r_planetSmall)**(L) * (t_planetSmall / l_planetSmall)**(M)

        t_planetBig = (13.5 * Y_planetBig)**(1/2) * moduleBig
        r_planetBig = 0.3 * moduleBig
        l_planetBig = 2.25 * moduleBig
        Kf_planetBig = H + (t_planetBig / r_planetBig)**(L) * (t_planetBig / l_planetBig)**(M)

        t_sun = (13.5 * Y_sun)**(1/2) * moduleBig
        r_sun = 0.3 * moduleBig
        l_sun = 2.25 * moduleBig
        Kf_sun = H + (t_sun / r_sun)**(L) * (t_sun / l_sun)**(M)

        t_ring = (13.5 * Y_ring)**(1/2) * moduleSmall
        r_ring = 0.3 * moduleSmall 
        l_ring = 2.25 * moduleSmall
        Kf_ring = H + (t_ring / r_ring)**(L) * (t_ring / l_ring)**(M)

        # Shigley's Mechanical Engineering Design 9th Edition pg.752
        # Yj Geometry factor
        Yj_planetSmall = Y_planetSmall/Kf_planetSmall
        Yj_planetBig = Y_planetBig/Kf_planetBig
        Yj_sun = Y_sun/Kf_sun
        Yj_ring = Y_ring/Kf_ring
        
        # Kv Dynamic factor
        # Shigley's Mechanical Engineering Design 9th Edition pg.756
        Qv = 7      # Quality numbers 3 to 7 will include most commercial-quality gears.
        B_planetSmall =  0.25*(12-Qv)**(2/3)
        A_planetSmall = 50 + 56*(1-B_planetSmall)
        Kv_planetSmall = ((A_planetSmall+np.sqrt(200*V_rp))/A_planetSmall)**B_planetSmall

        B_planetBig =  0.25*(12-Qv)**(2/3)
        A_planetBig = 50 + 56*(1-B_planetBig)
        Kv_planetBig = ((A_planetBig+np.sqrt(200*V_sp))/A_planetBig)**B_planetBig

        B_sun =  0.25*(12-Qv)**(2/3)
        A_sun = 50 + 56*(1-B_sun)
        Kv_sun = ((A_sun+np.sqrt(200*V_sp))/A_sun)**B_sun

        B_ring =  0.25*(12-Qv)**(2/3)
        A_ring = 50 + 56*(1-B_ring)
        Kv_ring = ((A_ring+np.sqrt(200*V_rp))/A_ring)**B_ring

        # Shigley's Mechanical Engineering Design 9th Edition pg.764
        # Ks Size factor (can be omitted if enough information is not available)
        Ks = 1
        
        # NPTEL Fatigue Consideration in Design lecture-7 pg.10 Table-7.4 (https://archive.nptel.ac.in/courses/112/106/112106137/)
        # Kh Load-distribution factor (0-50mm, less rigid mountings, less accurate gears)
        Kh_planet = 1.3
        Kh_sun = 1.3
        Kh_ring = 1.3

        # Shigley's Mechanical Engineering Design 9th Edition pg.764
        # Kb Rim-thickness factor (the gears have a uniform thickness)
        Kb = 1
        
        # AGMA bending stress equation (Shigley's Mechanical Engineering Design 9th Edition pg.746)  
        bMin_planetSmall = (self.FOS * Wt_rp * Kv_planetSmall * Ks * Kh_planet * Kb)/(moduleSmall * Yj_planetSmall * self.compoundPlanetaryGearbox.maxGearAllowableStressPa * 0.001)
        bMin_planetBig = (self.FOS * Wt_sp * Kv_planetBig * Ks * Kh_planet * Kb)/(moduleBig * Yj_planetBig * self.compoundPlanetaryGearbox.maxGearAllowableStressPa * 0.001)
        bMin_sun = (self.FOS * Wt_sp * Kv_sun * Ks * Kh_sun * Kb) / (moduleBig * Yj_sun * self.compoundPlanetaryGearbox.maxGearAllowableStressPa * 0.001)
        bMin_ring = (self.FOS * Wt_rp * Kv_ring * Ks * Kh_ring * Kb) / (moduleSmall * Yj_ring * self.compoundPlanetaryGearbox.maxGearAllowableStressPa * 0.001)

        if bMin_ring < bMin_planetSmall:
            bMin_ring = bMin_planetSmall
        else:
            bMin_planetSmall = bMin_ring

        self.compoundPlanetaryGearbox.setfwSunMM(bMin_sun*1000)
        self.compoundPlanetaryGearbox.setfwPlanetBigMM(bMin_planetBig*1000)
        self.compoundPlanetaryGearbox.setfwPlanetSmallMM(bMin_planetSmall*1000)
        self.compoundPlanetaryGearbox.setfwRingMM(bMin_ring*1000)

    def updateFacewidth(self):
        if self.stressAnalysisMethodName == "Lewis":
            self.lewisStressAnalysisMinFacewidth()
        elif self.stressAnalysisMethodName == "AGMA":
            self.AGMAStressAnalysisMinFacewidth()
        elif self.stressAnalysisMethodName == "MIT":
            self.mitStressAnalysisMinFacewidth()

    def getMassKG_3DP(self):
        module1   = self.compoundPlanetaryGearbox.moduleBig  # Module of the gear
        module2   = self.compoundPlanetaryGearbox.moduleSmall  # Module of the gear
        Ns        = self.compoundPlanetaryGearbox.Ns
        Np1       = self.compoundPlanetaryGearbox.NpBig
        Np2       = self.compoundPlanetaryGearbox.NpSmall
        Nr        = self.compoundPlanetaryGearbox.Nr
        numPlanet = self.compoundPlanetaryGearbox.numPlanet

        #-----------------------------------------
        # Density
        #-----------------------------------------
        density_gear = self.compoundPlanetaryGearbox.densityGears
        density_structure = self.compoundPlanetaryGearbox.densityStructure

        #-----------------------------------------
        # Face Width
        #-----------------------------------------
        sunFwMM     = self.compoundPlanetaryGearbox.fwSunMM
        planet1FwMM = self.compoundPlanetaryGearbox.fwPlanetBigMM
        planet2FwMM = self.compoundPlanetaryGearbox.fwPlanetSmallMM
        ringFwMM    = self.compoundPlanetaryGearbox.fwRingMM

        sunFwM     = sunFwMM     / 1000.0 # TODO: check the order of the index order should be always sun, planet1, planet2, ring
        planet1FwM = planet1FwMM / 1000.0
        planet2FwM = planet2FwMM / 1000.0
        ringFwM    = ringFwMM    / 1000.0

        #-----------------------------------------
        # Diameter and Radius
        #-----------------------------------------
        DiaSunMM        = Ns  * module1
        DiaPlanet1MM    = Np1 * module1
        DiaPlanet2MM    = Np2 * module2
        DiaRingMM       = Nr  * module2

        RadiusSunMM     = DiaSunMM     * 0.5
        RadiusPlanet1MM = DiaPlanet1MM * 0.5
        RadiusPlanet2MM = DiaPlanet2MM * 0.5
        RadiusRingMM    = DiaRingMM    * 0.5

        RingOuterRadiusMM = RadiusRingMM + self.compoundPlanetaryGearbox.ringRadialWidthMM

        #-----------------------------------------
        # Bearing Selection
        #-----------------------------------------
        IdrequiredMM      = module1 * (Ns + Np1) + self.bearingIDClearanceMM
        Bearings          = bearings_discrete(IdrequiredMM)
        InnerDiaBearingMM = Bearings.getBearingIDMM()
        OuterDiaBearingMM = Bearings.getBearingODMM()
        WidthBearingMM    = Bearings.getBearingWidthMM()
        BearingMassKG     = Bearings.getBearingMassKG()

        #======================================
        # Mass Calculation
        #======================================
        #--------------------------------------
        # Independent variables
        #--------------------------------------
        # To be written in Gearbox(cpg) JSON files
        case_mounting_surface_height   = self.case_mounting_surface_height
        standard_clearance_1_5mm       = self.standard_clearance_1_5mm    
        base_plate_thickness           = self.base_plate_thickness        
        Motor_case_thickness           = self.Motor_case_thickness        
        clearance_planet               = self.clearance_planet            
        output_mounting_hole_dia       = self.output_mounting_hole_dia    
        sec_carrier_thickness          = self.sec_carrier_thickness       
        sun_coupler_hub_thickness      = self.sun_coupler_hub_thickness   
        sun_shaft_bearing_OD           = self.sun_shaft_bearing_OD        
        carrier_bearing_step_width     = self.carrier_bearing_step_width  
        planet_shaft_dia               = self.planet_shaft_dia            
        sun_shaft_bearing_ID           = self.sun_shaft_bearing_ID        
        sun_shaft_bearing_width        = self.sun_shaft_bearing_width     
        planet_bore                    = self.planet_bore                 
        bearing_retainer_thickness     = self.bearing_retainer_thickness
        Motor_case_OD_base_to_chamfer  = self.Motor_case_OD_base_to_chamfer #5

        # To be written in Motor JSON files
        motor_output_hole_PCD = self.motor.motor_output_hole_PCD
        motor_output_hole_dia = self.motor.motor_output_hole_dia

        planet2FwMM += standard_clearance_1_5mm #clearnce to ensure big planet doesnt rub against the ring

        #--------------------------------------
        # Dependent variables
        #--------------------------------------
        h_b1 = 1.25 * module1
        h_b2 = 1.25 * module2

        #--------------------------------------
        # Mass: cpg_motor_casing
        #--------------------------------------
        ring_radial_thickness = self.ringRadialWidthMM
        ring_OD  = Nr * module2 + ring_radial_thickness*2


        gearbox_OD =  (Ns + Np1 * 2) * module1
        motor_OD = self.motorDiaMM

        if (gearbox_OD < motor_OD):
            clearance_motor_and_case = 5
        else: 
            clearance_motor_and_case = (gearbox_OD - motor_OD)/2 + 5

        Motor_case_ID     = motor_OD + clearance_motor_and_case * 2
        motor_height      = self.motorLengthMM
        Motor_case_height = motor_height + case_mounting_surface_height + standard_clearance_1_5mm

        Motor_case_OD = Motor_case_ID + Motor_case_thickness * 2

        Motor_case_volume = (  np.pi * ((Motor_case_OD * 0.5)**2) * base_plate_thickness 
                            + np.pi * ((Motor_case_OD * 0.5)**2 - (Motor_case_ID * 0.5)**2) * Motor_case_height
        ) * 1e-9

        Motor_case_mass = Motor_case_volume * density_structure

        #--------------------------------------
        # Mass: cpg_gearbox_casing
        #--------------------------------------
        # Mass of the gearbox includes the mass of:
        # 1. Ring gear
        # 2. Bearing holding structure
        # 3. Case mounting structure
        #--------------------------------------
        ring_ID      = Nr * module2
        ringFwUsedMM = ringFwMM + clearance_planet

        bearing_ID     = InnerDiaBearingMM 
        bearing_OD     = OuterDiaBearingMM 
        bearing_height = WidthBearingMM    
        bearing_mass   = BearingMassKG      

        if ((bearing_OD + output_mounting_hole_dia * 4) > (Nr * module2 + 2 * h_b2)):
            bearing_mount_thickness  = output_mounting_hole_dia * 2
        else:
            bearing_mount_thickness = ((((Nr * module2 + 2 * h_b2) - (bearing_OD + output_mounting_hole_dia * 4))/2) 
                                    + output_mounting_hole_dia * 2 + standard_clearance_1_5mm)        

        bearing_holding_structure_OD     = bearing_OD + bearing_mount_thickness * 2
        bearing_holding_structure_ID     = bearing_OD
        bearing_holding_structure_height = bearing_height + standard_clearance_1_5mm

        case_dist                      = sec_carrier_thickness + clearance_planet * 2 + sun_coupler_hub_thickness + planet1FwMM - case_mounting_surface_height
        case_mounting_structure_OD     = Motor_case_OD
        case_mounting_structure_ID     = case_mounting_structure_OD - Motor_case_OD_base_to_chamfer *  2
        case_mounting_structure_height = case_dist

        ring_volume                      = np.pi * (((ring_OD*0.5)**2) - ((ring_ID)*0.5)**2) * ringFwUsedMM * 1e-9
        bearing_holding_structure_volume = np.pi * (((bearing_holding_structure_OD*0.5)**2) - 
                                                    ((bearing_holding_structure_ID*0.5)**2)) * bearing_holding_structure_height * 1e-9
        case_mounting_structure_volume   = np.pi * (((case_mounting_structure_OD*0.5)**2) - 
                                                    ((case_mounting_structure_ID*0.5)**2)) * case_mounting_structure_height * 1e-9
        
        large_fillet_ID     = ring_OD
        large_fillet_OD     = Motor_case_OD
        large_fillet_height = ringFwMM
        large_fillet_volume = 0.5 * (np.pi * (((large_fillet_OD*0.5)**2) - ((large_fillet_ID)*0.5)**2) * large_fillet_height) * 1e-9

        ring_mass = ring_volume * density_gear

        if (density_gear != density_structure):
            gearbox_casing_mass = ring_volume * (density_structure + density_gear) + (bearing_holding_structure_volume + case_mounting_structure_volume + large_fillet_volume) * density_structure
        else: gearbox_casing_mass = ring_volume * density_gear + (bearing_holding_structure_volume + case_mounting_structure_volume + large_fillet_volume) * density_structure

        #----------------------------------
        # Mass: cpg_carrier
        #----------------------------------
        carrier_OD     = bearing_ID
        carrier_ID     = sun_shaft_bearing_OD - standard_clearance_1_5mm * 2
        carrier_height = bearing_height + carrier_bearing_step_width

        carrier_shaft_OD = planet_shaft_dia
        carrier_shaft_height = planet1FwMM  + planet2FwMM + clearance_planet * 2
        carrier_shaft_num = numPlanet * 2 + numPlanet # assuming triangular support is twice the mass of shaft

        carrier_volume = (np.pi * (((carrier_OD*0.5)**2) - ((carrier_ID)*0.5)**2) * carrier_height
                        + np.pi * ((carrier_shaft_OD*0.5)**2) * carrier_shaft_height * carrier_shaft_num) * 1e-9

        carrier_mass = carrier_volume * density_structure

        #----------------------------------
        # Mass: cpg_sun
        #----------------------------------
        sun_hub_dia = motor_output_hole_PCD + motor_output_hole_dia + standard_clearance_1_5mm * 4

        sun_shaft_dia    = sun_shaft_bearing_ID
        sun_shaft_height = sun_shaft_bearing_width + 2 * standard_clearance_1_5mm

        fw_s_used        = planet1FwMM + planet2FwMM + clearance_planet + sec_carrier_thickness + standard_clearance_1_5mm

        sun_hub_volume   = np.pi * ((sun_hub_dia*0.5) ** 2) * sun_coupler_hub_thickness * 1e-9
        sun_gear_volume  = np.pi * ((DiaSunMM * 0.5) ** 2) * fw_s_used * 1e-9
        sun_shaft_volume = np.pi * ((sun_shaft_dia*0.5) ** 2) * sun_shaft_height * 1e-9

        sun_volume       = sun_hub_volume + sun_gear_volume + sun_shaft_volume
        sun_mass         = sun_volume * density_gear

        #--------------------------------------
        # Mass: cpg_planet
        #--------------------------------------
        planet1_volume = (np.pi * ((DiaPlanet1MM*0.5)**2 - (planet_bore*0.5)**2) * planet1FwMM) * 1e-9
        planet2_volume = (np.pi * ((DiaPlanet2MM*0.5)**2 - (planet_bore*0.5)**2) * planet2FwMM) * 1e-9
        sun_dummy_dia_mm = (Nr - 2*Np2) * module2
        sun_dummy_volume = (np.pi * ((sun_dummy_dia_mm*0.5) ** 2) * (planet2FwMM * 0.45) * 1e-9)
        planet_mass   = (planet1_volume + planet2_volume * 2 + sun_dummy_volume) * density_gear ## for pancake

        #--------------------------------------
        # Mass: cpg_sec_carrier
        #--------------------------------------
        sec_carrier_OD = bearing_ID
        sec_carrier_ID = (DiaSunMM + DiaPlanet1MM) - planet_shaft_dia - 2 * standard_clearance_1_5mm

        sec_carrier_volume = (np.pi * ((sec_carrier_OD*0.5)**2 - (sec_carrier_ID*0.5)**2) * sec_carrier_thickness) * 1e-9
        sec_carrier_mass   = sec_carrier_volume * density_structure

        #--------------------------------------
        # Mass: cpg_sun_shaft_bearing
        #--------------------------------------
        sun_shaft_bearing_mass       = 4 * 0.001 # kg

        #--------------------------------------
        # Mass: cpg_planet_bearing
        #--------------------------------------
        planet_bearing_mass          = 1 * 0.001 # kg
        planet_bearing_num           = numPlanet * 2
        planet_bearing_combined_mass = planet_bearing_mass * planet_bearing_num

        #--------------------------------------
        # Mass: cpg_bearing
        #--------------------------------------
        bearing_mass = BearingMassKG # kg

        #--------------------------------------
        # Mass: cpg_bearing_retainer
        #--------------------------------------
        bearing_retainer_OD        = bearing_holding_structure_OD
        bearing_retainer_ID        = bearing_OD - standard_clearance_1_5mm * 2

        bearing_retainer_volume = (np.pi * ((bearing_retainer_OD*0.5)**2 - (bearing_retainer_ID*0.5)**2) * bearing_retainer_thickness) * 1e-9

        bearing_retainer_mass   = bearing_retainer_volume * density_structure

        self.Motor_case_mass              = Motor_case_mass
        self.gearbox_casing_mass          = gearbox_casing_mass
        self.ring_mass                    = ring_mass
        self.carrier_mass                 = carrier_mass
        self.sun_mass                     = sun_mass
        self.sec_carrier_mass             = sec_carrier_mass
        self.planet_mass                  = planet_mass
        self.planet_bearing_combined_mass = planet_bearing_combined_mass
        self.sun_shaft_bearing_mass       = sun_shaft_bearing_mass
        self.bearing_mass                 = bearing_mass
        self.bearing_retainer_mass        = bearing_retainer_mass

        #----------------------------------------
        # Total Actuator Mass
        #----------------------------------------

        Actuator_mass = (self.motorMassKG 
                        + self.Motor_case_mass 
                        + self.gearbox_casing_mass 
                        + self.carrier_mass 
                        + self.sun_mass 
                        + self.sec_carrier_mass 
                        + self.planet_mass * numPlanet 
                        + self.planet_bearing_combined_mass 
                        + self.sun_shaft_bearing_mass 
                        + self.bearing_mass 
                        + self.bearing_retainer_mass)

        return Actuator_mass

    def print_mass_of_parts_3DP(self):
        print("Motor_case_mass: ",              1000 * self.Motor_case_mass)
        print("gearbox_casing_mass: ",          1000 * self.gearbox_casing_mass)
        print("ring_mass: ",                    1000 * self.ring_mass)
        print("carrier_mass: ",                 1000 * self.carrier_mass)
        print("sun_mass: ",                     1000 * self.sun_mass)
        print("sec_carrier_mass: ",             1000 * self.sec_carrier_mass)
        print("planet_mass: ",                  1000 * self.planet_mass)
        print("planet_bearing_combined_mass: ", 1000 * self.planet_bearing_combined_mass)
        print("sun_shaft_bearing_mass: ",       1000 * self.sun_shaft_bearing_mass)
        print("bearing_mass: ",                 1000 * self.bearing_mass)
        print("bearing_retainer_mass: ",        1000 * self.bearing_retainer_mass)
        print("Motor mass:",                    1000 * self.motorMassKG)
        print("---------------------------------------------------")
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
