deepak-kapa/PancakeActuator/Opt_compoundPlanetaryGBOptimization.py

import sys
import numpy as np
from ActuatorAndGearbox import motor
from ActuatorAndGearbox import material
from ActuatorAndGearbox import compoundPlanetaryGearbox
from ActuatorAndGearbox import pancakeCompoundActuator
from ActuatorAndGearbox import compoundPlanetaryActuator
from ActuatorAndGearbox import optimizationCompoundPlanetaryActuator
import os
import json

#--------------------------------------------------------
# Importing motor data
#--------------------------------------------------------
# Get the current directory
current_dir = os.path.dirname(__file__)

# Build the file path
config_path = os.path.join(current_dir, "config_files/config.json")
cpg_params_path = os.path.join(current_dir, "config_files/cpg_params.json")

# Load the JSON file
with open(config_path, "r") as config_file:
    config_data = json.load(config_file)

with open(cpg_params_path, "r") as cpg_params_file:
    cpg_params = json.load(cpg_params_file)

#---------------------------------------------------
# Transferring relevant data to individual variables
#---------------------------------------------------
motor_data          = config_data["Motors"]
material_properties = config_data["Material_properties"]

Gear_standard_parameters = config_data["Gear_standard_parameters"]
Lewis_params             = config_data["Lewis_params"]
MIT_params               = config_data["MIT_params"]

Steel    = material_properties["Steel"]
Aluminum = material_properties["Aluminum"]
PLA      = material_properties["PLA"]

cpg_design_params       = cpg_params["cpg_3DP_design_parameters"]
cpg_optimization_params = cpg_params["cpg_optimization_parameters"]

motor_driver_data = config_data["Motor_drivers"]

#--------------------------------------------------------
# Motors Drivers
#--------------------------------------------------------
Motor_Driver_Moteus_params    = motor_driver_data["Moteus"]
Motor_Driver_OdrivePro_params = motor_driver_data["OdrivePro"]

#--------------------------------------------------------
# Motors
#--------------------------------------------------------
# T motor U8
MotorU8_Kv                         = motor_data["MotorU8_framed"]["Kv"]                   # rpm/V
MotorU8_maxContinuousCurrent       = motor_data["MotorU8_framed"]["maxContinuousCurrent"] # A

MotorU8_maxTorque                  = MotorU8_maxContinuousCurrent / (MotorU8_Kv * 2 * np.pi / 60)
MotorU8_power                      = motor_data["MotorU8_framed"]["power"]                 # W 
MotorU8_ratedVoltage               = motor_data["MotorU8_framed"]["ratedVoltage"]   
MotorU8_maxMotorAngVelRPM          = MotorU8_Kv * MotorU8_ratedVoltage # RPM 
MotorU8_mass                       = motor_data["MotorU8_framed"]["mass"]                  # kg 
MotorU8_dia                        = motor_data["MotorU8_framed"]["dia"]                   # mm 
MotorU8_length                     = motor_data["MotorU8_framed"]["length"]                # mm
MotorU8_motor_mount_hole_PCD       = motor_data["MotorU8_framed"]["motor_mount_hole_PCD"]
MotorU8_motor_mount_hole_dia       = motor_data["MotorU8_framed"]["motor_mount_hole_dia"]
MotorU8_motor_mount_hole_num       = motor_data["MotorU8_framed"]["motor_mount_hole_num"]
MotorU8_motor_output_hole_PCD      = motor_data["MotorU8_framed"]["motor_output_hole_PCD"]
MotorU8_motor_output_hole_dia      = motor_data["MotorU8_framed"]["motor_output_hole_dia"]
MotorU8_motor_output_hole_num      = motor_data["MotorU8_framed"]["motor_output_hole_num"]
MotorU8_wire_slot_dist_from_center = motor_data["MotorU8_framed"]["wire_slot_dist_from_center"]
MotorU8_wire_slot_length           = motor_data["MotorU8_framed"]["wire_slot_length"]
MotorU8_wire_slot_radius           = motor_data["MotorU8_framed"]["wire_slot_radius"]

# U10 Motor
MotorU10_Kv                         = motor_data["MotorU10_framed"]["Kv"]                   # rpm/V
MotorU10_maxContinuousCurrent       = motor_data["MotorU10_framed"]["maxContinuousCurrent"] # A

MotorU10_maxTorque                  = MotorU10_maxContinuousCurrent / (MotorU10_Kv * 2 * np.pi / 60)
MotorU10_power                      = motor_data["MotorU10_framed"]["power"]                  # W
MotorU10_ratedVoltage               = motor_data["MotorU10_framed"]["ratedVoltage"]   
MotorU10_maxMotorAngVelRPM          = MotorU10_Kv * MotorU10_ratedVoltage   # RPM
MotorU10_mass                       = motor_data["MotorU10_framed"]["mass"]                   # Kg 
MotorU10_dia                        = motor_data["MotorU10_framed"]["dia"]                    # mm
MotorU10_length                     = motor_data["MotorU10_framed"]["length"]                 # mm
MotorU10_motor_mount_hole_PCD       = motor_data["MotorU10_framed"]["motor_mount_hole_PCD"]
MotorU10_motor_mount_hole_dia       = motor_data["MotorU10_framed"]["motor_mount_hole_dia"]
MotorU10_motor_mount_hole_num       = motor_data["MotorU10_framed"]["motor_mount_hole_num"]
MotorU10_motor_output_hole_PCD      = motor_data["MotorU10_framed"]["motor_output_hole_PCD"]
MotorU10_motor_output_hole_dia      = motor_data["MotorU10_framed"]["motor_output_hole_dia"]
MotorU10_motor_output_hole_num      = motor_data["MotorU10_framed"]["motor_output_hole_num"]
MotorU10_wire_slot_dist_from_center = motor_data["MotorU10_framed"]["wire_slot_dist_from_center"]
MotorU10_wire_slot_length           = motor_data["MotorU10_framed"]["wire_slot_length"]
MotorU10_wire_slot_radius           = motor_data["MotorU10_framed"]["wire_slot_radius"]

# MN8014 Motor
MotorMN8014_Kv                         = motor_data["MotorMN8014_framed"]["Kv"]                   # rpm/V
MotorMN8014_maxContinuousCurrent       = motor_data["MotorMN8014_framed"]["maxContinuousCurrent"] # A

MotorMN8014_maxTorque                  = MotorMN8014_maxContinuousCurrent / (MotorMN8014_Kv * 2 * np.pi / 60)
MotorMN8014_power                      = motor_data["MotorMN8014_framed"]["power"]                  # W
MotorMN8014_ratedVoltage               = motor_data["MotorMN8014_framed"]["ratedVoltage"]   
MotorMN8014_maxMotorAngVelRPM          = MotorMN8014_Kv * MotorMN8014_ratedVoltage   # RPM
MotorMN8014_mass                       = motor_data["MotorMN8014_framed"]["mass"]                   # Kg 
MotorMN8014_dia                        = motor_data["MotorMN8014_framed"]["dia"]                    # mm
MotorMN8014_length                     = motor_data["MotorMN8014_framed"]["length"]                 # mm
MotorMN8014_motor_mount_hole_PCD       = motor_data["MotorMN8014_framed"]["motor_mount_hole_PCD"]
MotorMN8014_motor_mount_hole_dia       = motor_data["MotorMN8014_framed"]["motor_mount_hole_dia"]
MotorMN8014_motor_mount_hole_num       = motor_data["MotorMN8014_framed"]["motor_mount_hole_num"]
MotorMN8014_motor_output_hole_PCD      = motor_data["MotorMN8014_framed"]["motor_output_hole_PCD"]
MotorMN8014_motor_output_hole_dia      = motor_data["MotorMN8014_framed"]["motor_output_hole_dia"]
MotorMN8014_motor_output_hole_num      = motor_data["MotorMN8014_framed"]["motor_output_hole_num"]
MotorMN8014_wire_slot_dist_from_center = motor_data["MotorMN8014_framed"]["wire_slot_dist_from_center"]
MotorMN8014_wire_slot_length           = motor_data["MotorMN8014_framed"]["wire_slot_length"]
MotorMN8014_wire_slot_radius           = motor_data["MotorMN8014_framed"]["wire_slot_radius"]

# 8020 Motor
Motor8020_Kv                         = motor_data["Motor8020_framed"]["Kv"]                   # rpm/V
Motor8020_maxContinuousCurrent       = motor_data["Motor8020_framed"]["maxContinuousCurrent"] # A

Motor8020_maxTorque                  = Motor8020_maxContinuousCurrent / (Motor8020_Kv * 2 * np.pi / 60)
Motor8020_power                      = motor_data["Motor8020_framed"]["power"]                  # W
Motor8020_ratedVoltage               = motor_data["Motor8020_framed"]["ratedVoltage"]   
Motor8020_maxMotorAngVelRPM          = Motor8020_Kv * Motor8020_ratedVoltage   # RPM
Motor8020_mass                       = motor_data["Motor8020_framed"]["mass"]                   # Kg 
Motor8020_dia                        = motor_data["Motor8020_framed"]["dia"]                    # mm
Motor8020_length                     = motor_data["Motor8020_framed"]["length"]                 # mm
Motor8020_motor_mount_hole_PCD       = motor_data["Motor8020_framed"]["motor_mount_hole_PCD"]
Motor8020_motor_mount_hole_dia       = motor_data["Motor8020_framed"]["motor_mount_hole_dia"]
Motor8020_motor_mount_hole_num       = motor_data["Motor8020_framed"]["motor_mount_hole_num"]
Motor8020_motor_output_hole_PCD      = motor_data["Motor8020_framed"]["motor_output_hole_PCD"]
Motor8020_motor_output_hole_dia      = motor_data["Motor8020_framed"]["motor_output_hole_dia"]
Motor8020_motor_output_hole_num      = motor_data["Motor8020_framed"]["motor_output_hole_num"]
Motor8020_wire_slot_dist_from_center = motor_data["Motor8020_framed"]["wire_slot_dist_from_center"]
Motor8020_wire_slot_length           = motor_data["Motor8020_framed"]["wire_slot_length"]
Motor8020_wire_slot_radius           = motor_data["Motor8020_framed"]["wire_slot_radius"]

# T motor U12
MotorU12_Kv                         = motor_data["MotorU12_framed"]["Kv"]                   # rpm/V
MotorU12_maxContinuousCurrent       = motor_data["MotorU12_framed"]["maxContinuousCurrent"] # A

MotorU12_maxTorque                  = MotorU12_maxContinuousCurrent / (MotorU12_Kv * 2 * np.pi / 60)
MotorU12_power                      = motor_data["MotorU12_framed"]["power"]                 # W 
MotorU12_ratedVoltage               = motor_data["MotorU12_framed"]["ratedVoltage"]   
MotorU12_maxMotorAngVelRPM          = MotorU12_Kv * MotorU12_ratedVoltage   # RPM
MotorU12_mass                       = motor_data["MotorU12_framed"]["mass"]                  # kg 
MotorU12_dia                        = motor_data["MotorU12_framed"]["dia"]                   # mm 
MotorU12_length                     = motor_data["MotorU12_framed"]["length"]                # mm
MotorU12_motor_mount_hole_PCD       = motor_data["MotorU12_framed"]["motor_mount_hole_PCD"]
MotorU12_motor_mount_hole_dia       = motor_data["MotorU12_framed"]["motor_mount_hole_dia"]
MotorU12_motor_mount_hole_num       = motor_data["MotorU12_framed"]["motor_mount_hole_num"]
MotorU12_motor_output_hole_PCD      = motor_data["MotorU12_framed"]["motor_output_hole_PCD"]
MotorU12_motor_output_hole_dia      = motor_data["MotorU12_framed"]["motor_output_hole_dia"]
MotorU12_motor_output_hole_num      = motor_data["MotorU12_framed"]["motor_output_hole_num"]
MotorU12_wire_slot_dist_from_center = motor_data["MotorU12_framed"]["wire_slot_dist_from_center"]
MotorU12_wire_slot_length           = motor_data["MotorU12_framed"]["wire_slot_length"]
MotorU12_wire_slot_radius           = motor_data["MotorU12_framed"]["wire_slot_radius"]

# T motor MAD_M6C12
MotorMAD_M6C12_Kv                         = motor_data["MotorMAD_M6C12_framed"]["Kv"]                   # rpm/V
MotorMAD_M6C12_maxContinuousCurrent       = motor_data["MotorMAD_M6C12_framed"]["maxContinuousCurrent"] # A

MotorMAD_M6C12_maxTorque                  = MotorMAD_M6C12_maxContinuousCurrent / (MotorMAD_M6C12_Kv * 2 * np.pi / 60)
MotorMAD_M6C12_power                      = motor_data["MotorMAD_M6C12_framed"]["power"]                 # W 
MotorMAD_M6C12_ratedVoltage               = motor_data["MotorMAD_M6C12_framed"]["ratedVoltage"]   
MotorMAD_M6C12_maxMotorAngVelRPM          = MotorMAD_M6C12_Kv * MotorMAD_M6C12_ratedVoltage   # RPM
MotorMAD_M6C12_mass                       = motor_data["MotorMAD_M6C12_framed"]["mass"]                  # kg 
MotorMAD_M6C12_dia                        = motor_data["MotorMAD_M6C12_framed"]["dia"]                   # mm 
MotorMAD_M6C12_length                     = motor_data["MotorMAD_M6C12_framed"]["length"]                # mm
MotorMAD_M6C12_motor_mount_hole_PCD       = motor_data["MotorMAD_M6C12_framed"]["motor_mount_hole_PCD"]
MotorMAD_M6C12_motor_mount_hole_dia       = motor_data["MotorMAD_M6C12_framed"]["motor_mount_hole_dia"]
MotorMAD_M6C12_motor_mount_hole_num       = motor_data["MotorMAD_M6C12_framed"]["motor_mount_hole_num"]
MotorMAD_M6C12_motor_output_hole_PCD      = motor_data["MotorMAD_M6C12_framed"]["motor_output_hole_PCD"]
MotorMAD_M6C12_motor_output_hole_dia      = motor_data["MotorMAD_M6C12_framed"]["motor_output_hole_dia"]
MotorMAD_M6C12_motor_output_hole_num      = motor_data["MotorMAD_M6C12_framed"]["motor_output_hole_num"]
MotorMAD_M6C12_wire_slot_dist_from_center = motor_data["MotorMAD_M6C12_framed"]["wire_slot_dist_from_center"]
MotorMAD_M6C12_wire_slot_length           = motor_data["MotorMAD_M6C12_framed"]["wire_slot_length"]
MotorMAD_M6C12_wire_slot_radius           = motor_data["MotorMAD_M6C12_framed"]["wire_slot_radius"]


# Motor-U8
MotorU8 = motor(maxMotorAngVelRPM           = MotorU8_maxMotorAngVelRPM, 
                 maxMotorTorque             = MotorU8_maxTorque,
                 maxMotorPower              = MotorU8_power,
                 motorMass                  = MotorU8_mass,
                 motorDia                   = MotorU8_dia,
                 motorLength                = MotorU8_length,
                 motor_mount_hole_PCD       = MotorU8_motor_mount_hole_PCD,
                 motor_mount_hole_dia       = MotorU8_motor_mount_hole_dia,
                 motor_mount_hole_num       = MotorU8_motor_mount_hole_num,
                 motor_output_hole_PCD      = MotorU8_motor_output_hole_PCD,
                 motor_output_hole_dia      = MotorU8_motor_output_hole_dia,
                 motor_output_hole_num      = MotorU8_motor_output_hole_num,
                 wire_slot_dist_from_center = MotorU8_wire_slot_dist_from_center,
                 wire_slot_length           = MotorU8_wire_slot_length,
                 wire_slot_radius           = MotorU8_wire_slot_radius,
                 motorName                  = "U8")

# Motor-U10
MotorU10  = motor(maxMotorAngVelRPM          = MotorU10_maxMotorAngVelRPM, # RPM 
                  maxMotorTorque             = MotorU10_maxTorque,         # Nm 
                  maxMotorPower              = MotorU10_power,             # W 
                  motorMass                  = MotorU10_mass,              # kg 
                  motorDia                   = MotorU10_dia,               # mm 
                  motorLength                = MotorU10_length,    
                  motor_mount_hole_PCD       = MotorU10_motor_mount_hole_PCD,
                  motor_mount_hole_dia       = MotorU10_motor_mount_hole_dia,
                  motor_mount_hole_num       = MotorU10_motor_mount_hole_num,
                  motor_output_hole_PCD      = MotorU10_motor_output_hole_PCD,
                  motor_output_hole_dia      = MotorU10_motor_output_hole_dia,
                  motor_output_hole_num      = MotorU10_motor_output_hole_num,
                  wire_slot_dist_from_center = MotorU10_wire_slot_dist_from_center,
                  wire_slot_length           = MotorU10_wire_slot_length,
                  wire_slot_radius           = MotorU10_wire_slot_radius, 
                  motorName                  = "U10") 

# Motor-MN8014
MotorMN8014 = motor(maxMotorAngVelRPM          = MotorMN8014_maxMotorAngVelRPM, #RPM 
                    maxMotorTorque             = MotorMN8014_maxTorque      , # Nm 
                    maxMotorPower              = MotorMN8014_power          , # W 
                    motorMass                  = MotorMN8014_mass           , # kg 
                    motorDia                   = MotorMN8014_dia            , # mm 
                    motorLength                = MotorMN8014_length         ,     
                    motor_mount_hole_PCD       = MotorMN8014_motor_mount_hole_PCD,
                    motor_mount_hole_dia       = MotorMN8014_motor_mount_hole_dia,
                    motor_mount_hole_num       = MotorMN8014_motor_mount_hole_num,
                    motor_output_hole_PCD      = MotorMN8014_motor_output_hole_PCD,
                    motor_output_hole_dia      = MotorMN8014_motor_output_hole_dia,
                    motor_output_hole_num      = MotorMN8014_motor_output_hole_num,
                    wire_slot_dist_from_center = MotorMN8014_wire_slot_dist_from_center,
                    wire_slot_length           = MotorMN8014_wire_slot_length,
                    wire_slot_radius           = MotorMN8014_wire_slot_radius, 
                    motorName                  = "MN8014") 

# Motor-VT8020
Motor8020 = motor(maxMotorAngVelRPM          = Motor8020_maxMotorAngVelRPM, # RPM 
                  maxMotorTorque             = Motor8020_maxTorque        , # Nm 
                  maxMotorPower              = Motor8020_power            , # W 
                  motorMass                  = Motor8020_mass             , # kg 
                  motorDia                   = Motor8020_dia              , # mm 
                  motorLength                = Motor8020_length           ,     
                  motor_mount_hole_PCD       = Motor8020_motor_mount_hole_PCD,
                  motor_mount_hole_dia       = Motor8020_motor_mount_hole_dia,
                  motor_mount_hole_num       = Motor8020_motor_mount_hole_num,
                  motor_output_hole_PCD      = Motor8020_motor_output_hole_PCD,
                  motor_output_hole_dia      = Motor8020_motor_output_hole_dia,
                  motor_output_hole_num      = Motor8020_motor_output_hole_num,
                  wire_slot_dist_from_center = Motor8020_wire_slot_dist_from_center,
                  wire_slot_length           = Motor8020_wire_slot_length,
                  wire_slot_radius           = Motor8020_wire_slot_radius, 
                  motorName                  = "VT8020")

# Motor-U12
MotorU12 = motor(maxMotorAngVelRPM          = MotorU12_maxMotorAngVelRPM,
                 maxMotorTorque             = MotorU12_maxTorque        ,
                 maxMotorPower              = MotorU12_power            ,
                 motorMass                  = MotorU12_mass             , 
                 motorDia                   = MotorU12_dia              ,
                 motorLength                = MotorU12_length           ,
                 motor_mount_hole_PCD       = MotorU12_motor_mount_hole_PCD,
                 motor_mount_hole_dia       = MotorU12_motor_mount_hole_dia,
                 motor_mount_hole_num       = MotorU12_motor_mount_hole_num,
                 motor_output_hole_PCD      = MotorU12_motor_output_hole_PCD,
                 motor_output_hole_dia      = MotorU12_motor_output_hole_dia,
                 motor_output_hole_num      = MotorU12_motor_output_hole_num,
                 wire_slot_dist_from_center = MotorU12_wire_slot_dist_from_center,
                 wire_slot_length           = MotorU12_wire_slot_length,
                 wire_slot_radius           = MotorU12_wire_slot_radius, 
                 motorName                  = "U12")

# Motor-MAD_M6C12
MotorMAD_M6C12 = motor(maxMotorAngVelRPM          = MotorMAD_M6C12_maxMotorAngVelRPM,
                       maxMotorTorque             = MotorMAD_M6C12_maxTorque        ,
                       maxMotorPower              = MotorMAD_M6C12_power            ,
                       motorMass                  = MotorMAD_M6C12_mass             , 
                       motorDia                   = MotorMAD_M6C12_dia              ,
                       motorLength                = MotorMAD_M6C12_length           ,
                       motor_mount_hole_PCD       = MotorMAD_M6C12_motor_mount_hole_PCD,
                       motor_mount_hole_dia       = MotorMAD_M6C12_motor_mount_hole_dia,
                       motor_mount_hole_num       = MotorMAD_M6C12_motor_mount_hole_num,
                       motor_output_hole_PCD      = MotorMAD_M6C12_motor_output_hole_PCD,
                       motor_output_hole_dia      = MotorMAD_M6C12_motor_output_hole_dia,
                       motor_output_hole_num      = MotorMAD_M6C12_motor_output_hole_num,
                       wire_slot_dist_from_center = MotorMAD_M6C12_wire_slot_dist_from_center,
                       wire_slot_length           = MotorMAD_M6C12_wire_slot_length,
                       wire_slot_radius           = MotorMAD_M6C12_wire_slot_radius, 
                       motorName                  = "MAD_M6C12")

#-------------------------------------------------------
# Gearbox 
#-------------------------------------------------------
compoundPlanetaryGearboxInstance = compoundPlanetaryGearbox(design_parameters         = cpg_design_params,
                                                            gear_standard_parameters  = Gear_standard_parameters,
                                                            densityGears              = PLA["density"],
                                                            densityStructure          = PLA["density"],
                                                            maxGearAllowableStressMPa = PLA["maxAllowableStressMPa"])

compoundPlanetaryGearboxInstance_pancake = compoundPlanetaryGearbox(design_parameters         = cpg_design_params,
                                                                    gear_standard_parameters  = Gear_standard_parameters,
                                                                    densityGears              = PLA["density"],
                                                                    densityStructure          = PLA["density"],
                                                                    maxGearAllowableStressMPa = PLA["maxAllowableStressMPa"])

#-----------------------------------------------------
# Actuator
#-----------------------------------------------------
maxGBDia_multFactor           = 1.25 #cpg_optimization_params["MAX_GB_DIA_MULT_FACTOR"] # 1
maxGBDia_multFactor_MAD_M6C12 = cpg_optimization_params["MAX_GB_DIA_MULT_FACTOR_MAD_M6C12"] # 1.25

maxGearboxDiameter_U8         = maxGBDia_multFactor * MotorU8.motorDiaMM       
maxGearboxDiameter_U10        = maxGBDia_multFactor * MotorU10.motorDiaMM    
maxGearboxDiameter_MN8014     = maxGBDia_multFactor * MotorMN8014.motorDiaMM 
maxGearboxDiameter_VT8020     = maxGBDia_multFactor * Motor8020.motorDiaMM   
maxGearboxDiameter_U12        = maxGBDia_multFactor * MotorU12.motorDiaMM     
maxGearboxDiameter_MAD_M6C12  = maxGBDia_multFactor_MAD_M6C12 * MotorMAD_M6C12.motorDiaMM

#-------------------------------------------------------
# Material options
#-------------------------------------------------------
MATERIAL_SETTINGS = {
    "3dp": {
        "densityGears": PLA["density"],
        "densityStructure": PLA["density"],
        "maxGearAllowableStressMPa": PLA["maxAllowableStressMPa"]
    },
    "metal": {
        "densityGears": Steel["density"],
        "densityStructure": Aluminum["density"],
        "maxGearAllowableStressMPa": Steel["maxAllowableStressMPa"]
    }
}

def build_actuator(motor_obj, maxGearboxDiameter, material_mode, style):
    material_mode = material_mode.lower()
    if material_mode not in MATERIAL_SETTINGS:
        raise ValueError("material_mode must be '3dp' or 'metal'")
    if style not in ["normal", "pancake"]:
        raise ValueError("style must be 'normal' or 'pancake'")

    material_settings = MATERIAL_SETTINGS[material_mode]
    gearbox = compoundPlanetaryGearbox(design_parameters         = cpg_design_params,
                                      gear_standard_parameters  = Gear_standard_parameters,
                                      densityGears              = material_settings["densityGears"],
                                      densityStructure          = material_settings["densityStructure"],
                                      maxGearAllowableStressMPa = material_settings["maxGearAllowableStressMPa"])

    ActuatorClass = pancakeCompoundActuator if style == "pancake" else compoundPlanetaryActuator
    actuator = ActuatorClass(design_parameters        = cpg_design_params,
                              motor                    = motor_obj,
                              motor_driver_params      = Motor_Driver_OdrivePro_params,
                              compoundPlanetaryGearbox = gearbox,
                              FOS                      = MIT_params["FOS"],
                              serviceFactor            = MIT_params["serviceFactor"],
                              maxGearboxDiameter       = maxGearboxDiameter,
                              stressAnalysisMethodName = "MIT")
    actuator.materialMode = material_mode
    return actuator

#-----------------------------------------------------
# Optimization
#-----------------------------------------------------
opt_param = config_data["Cost_gain_parameters"]

K_Mass = opt_param["K_Mass"]
K_Eff  = opt_param["K_Eff"]
K_Width = opt_param["K_Width"]

GEAR_RATIO_MIN  = cpg_optimization_params["GEAR_RATIO_MIN"]  # 4
GEAR_RATIO_MAX  = cpg_optimization_params["GEAR_RATIO_MAX"]  # 30
GEAR_RATIO_STEP = cpg_optimization_params["GEAR_RATIO_STEP"] # 1

MODULE_BIG_MIN             = cpg_optimization_params["MODULE_MIN"]           # 0.8
MODULE_BIG_MAX             = cpg_optimization_params["MODULE_MAX"]           # 1.2
MODULE_SMALL_MIN           = cpg_optimization_params["MODULE_MIN"]           # 0.8
MODULE_SMALL_MAX           = cpg_optimization_params["MODULE_MAX"]           # 1.2
NUM_PLANET_MIN             = cpg_optimization_params["NUM_PLANET_MIN"]       # 3  
NUM_PLANET_MAX             = cpg_optimization_params["NUM_PLANET_MAX"]       # 5  
NUM_TEETH_SUN_MIN          = cpg_optimization_params["NUM_TEETH_SUN_MIN"]    # 20 
NUM_TEETH_PLANET_BIG_MIN   = cpg_optimization_params["NUM_TEETH_PLANET_MIN"] # 20 
NUM_TEETH_PLANET_SMALL_MIN = cpg_optimization_params["NUM_TEETH_PLANET_MIN"] # 20 

Optimizer_U8     = optimizationCompoundPlanetaryActuator(design_parameters          = cpg_design_params,
                                                         gear_standard_parameters   = Gear_standard_parameters,
                                                         K_Mass                     = K_Mass                     ,
                                                         K_Eff                      = K_Eff                      ,
                                                         K_Width                    = K_Width                    ,
                                                         MODULE_BIG_MIN             = MODULE_BIG_MIN             ,
                                                         MODULE_BIG_MAX             = MODULE_BIG_MAX             ,
                                                         MODULE_SMALL_MIN           = MODULE_SMALL_MIN           ,
                                                         MODULE_SMALL_MAX           = MODULE_SMALL_MAX           ,
                                                         NUM_PLANET_MIN             = NUM_PLANET_MIN             ,
                                                         NUM_PLANET_MAX             = NUM_PLANET_MAX             ,
                                                         NUM_TEETH_SUN_MIN          = NUM_TEETH_SUN_MIN          ,
                                                         NUM_TEETH_PLANET_BIG_MIN   = NUM_TEETH_PLANET_BIG_MIN   ,
                                                         NUM_TEETH_PLANET_SMALL_MIN = NUM_TEETH_PLANET_SMALL_MIN ,
                                                         GEAR_RATIO_MIN             = GEAR_RATIO_MIN             ,
                                                         GEAR_RATIO_MAX             = GEAR_RATIO_MAX             ,
                                                         GEAR_RATIO_STEP            = GEAR_RATIO_STEP            )

Optimizer_U10    = optimizationCompoundPlanetaryActuator(design_parameters          = cpg_design_params,
                                                         gear_standard_parameters   = Gear_standard_parameters,
                                                         K_Mass                     = K_Mass                     ,
                                                         K_Eff                      = K_Eff                      ,
                                                         K_Width                    = K_Width                    ,
                                                         MODULE_BIG_MIN             = MODULE_BIG_MIN             ,
                                                         MODULE_BIG_MAX             = MODULE_BIG_MAX             ,
                                                         MODULE_SMALL_MIN           = MODULE_SMALL_MIN           ,
                                                         MODULE_SMALL_MAX           = MODULE_SMALL_MAX           ,
                                                         NUM_PLANET_MIN             = NUM_PLANET_MIN             ,
                                                         NUM_PLANET_MAX             = NUM_PLANET_MAX             ,
                                                         NUM_TEETH_SUN_MIN          = NUM_TEETH_SUN_MIN          ,
                                                         NUM_TEETH_PLANET_BIG_MIN   = NUM_TEETH_PLANET_BIG_MIN   ,
                                                         NUM_TEETH_PLANET_SMALL_MIN = NUM_TEETH_PLANET_SMALL_MIN ,
                                                         GEAR_RATIO_MIN             = GEAR_RATIO_MIN             ,
                                                         GEAR_RATIO_MAX             = GEAR_RATIO_MAX             ,
                                                         GEAR_RATIO_STEP            = GEAR_RATIO_STEP            )

Optimizer_MN8014 = optimizationCompoundPlanetaryActuator(design_parameters          = cpg_design_params,
                                                         gear_standard_parameters   = Gear_standard_parameters,
                                                         K_Mass                     = K_Mass                     ,
                                                         K_Eff                      = K_Eff                      ,
                                                         K_Width                    = K_Width                    ,
                                                         MODULE_BIG_MIN             = MODULE_BIG_MIN             ,
                                                         MODULE_BIG_MAX             = MODULE_BIG_MAX             ,
                                                         MODULE_SMALL_MIN           = MODULE_SMALL_MIN           ,
                                                         MODULE_SMALL_MAX           = MODULE_SMALL_MAX           ,
                                                         NUM_PLANET_MIN             = NUM_PLANET_MIN             ,
                                                         NUM_PLANET_MAX             = NUM_PLANET_MAX             ,
                                                         NUM_TEETH_SUN_MIN          = NUM_TEETH_SUN_MIN          ,
                                                         NUM_TEETH_PLANET_BIG_MIN   = NUM_TEETH_PLANET_BIG_MIN   ,
                                                         NUM_TEETH_PLANET_SMALL_MIN = NUM_TEETH_PLANET_SMALL_MIN ,
                                                         GEAR_RATIO_MIN             = GEAR_RATIO_MIN             ,
                                                         GEAR_RATIO_MAX             = GEAR_RATIO_MAX             ,
                                                         GEAR_RATIO_STEP            = GEAR_RATIO_STEP            )

Optimizer_VT8020 = optimizationCompoundPlanetaryActuator(design_parameters          = cpg_design_params,
                                                         gear_standard_parameters   = Gear_standard_parameters,
                                                         K_Mass                     = K_Mass                     ,
                                                         K_Eff                      = K_Eff                      ,
                                                         K_Width                    = K_Width                    ,
                                                         MODULE_BIG_MIN             = MODULE_BIG_MIN             ,
                                                         MODULE_BIG_MAX             = MODULE_BIG_MAX             ,
                                                         MODULE_SMALL_MIN           = MODULE_SMALL_MIN           ,
                                                         MODULE_SMALL_MAX           = MODULE_SMALL_MAX           ,
                                                         NUM_PLANET_MIN             = NUM_PLANET_MIN             ,
                                                         NUM_PLANET_MAX             = NUM_PLANET_MAX             ,
                                                         NUM_TEETH_SUN_MIN          = NUM_TEETH_SUN_MIN          ,
                                                         NUM_TEETH_PLANET_BIG_MIN   = NUM_TEETH_PLANET_BIG_MIN   ,
                                                         NUM_TEETH_PLANET_SMALL_MIN = NUM_TEETH_PLANET_SMALL_MIN ,
                                                         GEAR_RATIO_MIN             = GEAR_RATIO_MIN             ,
                                                         GEAR_RATIO_MAX             = GEAR_RATIO_MAX             ,
                                                         GEAR_RATIO_STEP            = GEAR_RATIO_STEP            )

Optimizer_U12 = optimizationCompoundPlanetaryActuator(design_parameters          = cpg_design_params,
                                                      gear_standard_parameters   = Gear_standard_parameters,
                                                      K_Mass                     = K_Mass                    ,
                                                      K_Eff                      = K_Eff                     ,
                                                      K_Width                    = K_Width                   ,
                                                      MODULE_BIG_MIN             = MODULE_BIG_MIN            ,
                                                      MODULE_BIG_MAX             = MODULE_BIG_MAX            ,
                                                      MODULE_SMALL_MIN           = MODULE_SMALL_MIN          ,
                                                      MODULE_SMALL_MAX           = MODULE_SMALL_MAX          ,
                                                      NUM_PLANET_MIN             = NUM_PLANET_MIN            ,
                                                      NUM_PLANET_MAX             = NUM_PLANET_MAX            ,
                                                      NUM_TEETH_SUN_MIN          = NUM_TEETH_SUN_MIN         ,
                                                      NUM_TEETH_PLANET_BIG_MIN   = NUM_TEETH_PLANET_BIG_MIN  ,
                                                      NUM_TEETH_PLANET_SMALL_MIN = NUM_TEETH_PLANET_SMALL_MIN,
                                                      GEAR_RATIO_MIN             = GEAR_RATIO_MIN            ,
                                                      GEAR_RATIO_MAX             = GEAR_RATIO_MAX            ,
                                                      GEAR_RATIO_STEP            = GEAR_RATIO_STEP           )

Optimizer_MAD_M6C12 = optimizationCompoundPlanetaryActuator(design_parameters    = cpg_design_params,
                                                            gear_standard_parameters   = Gear_standard_parameters,
                                                            K_Mass                     = K_Mass                     ,
                                                            K_Eff                      = K_Eff                      ,
                                                            K_Width                    = K_Width                   ,
                                                            MODULE_BIG_MIN             = MODULE_BIG_MIN             ,
                                                            MODULE_BIG_MAX             = MODULE_BIG_MAX             ,
                                                            MODULE_SMALL_MIN           = MODULE_SMALL_MIN           ,
                                                            MODULE_SMALL_MAX           = MODULE_SMALL_MAX           ,
                                                            NUM_PLANET_MIN             = NUM_PLANET_MIN             ,
                                                            NUM_PLANET_MAX             = NUM_PLANET_MAX             ,
                                                            NUM_TEETH_SUN_MIN          = NUM_TEETH_SUN_MIN          ,
                                                            NUM_TEETH_PLANET_BIG_MIN   = NUM_TEETH_PLANET_BIG_MIN   ,
                                                            NUM_TEETH_PLANET_SMALL_MIN = NUM_TEETH_PLANET_SMALL_MIN ,
                                                            GEAR_RATIO_MIN             = GEAR_RATIO_MIN             ,
                                                            GEAR_RATIO_MAX             = GEAR_RATIO_MAX             ,
                                                            GEAR_RATIO_STEP            = GEAR_RATIO_STEP            )

MOTOR_LOOKUP = {
    "U8":        (MotorU8,        maxGearboxDiameter_U8,        Optimizer_U8),
    "U10":       (MotorU10,       maxGearboxDiameter_U10,       Optimizer_U10),
    "MN8014":    (MotorMN8014,    maxGearboxDiameter_MN8014,    Optimizer_MN8014),
    "VT8020":    (Motor8020,      maxGearboxDiameter_VT8020,    Optimizer_VT8020),
    "U12":       (MotorU12,       maxGearboxDiameter_U12,       Optimizer_U12),
    "MAD_M6C12": (MotorMAD_M6C12, maxGearboxDiameter_MAD_M6C12, Optimizer_MAD_M6C12),
}


#=============================================================
# run function to select the gearbox_type
#=============================================================
def run(motor_name, gear_ratio, actuator_style="pancake", material_mode="3dp"):
    actuator_style = actuator_style.lower()
    material_mode = material_mode.lower()

    if actuator_style not in ["normal", "pancake"]:
        raise ValueError("actuator_style must be 'normal' or 'pancake'")

    if material_mode not in MATERIAL_SETTINGS:
        raise ValueError("material_mode must be '3dp' or 'metal'")

    if motor_name not in MOTOR_LOOKUP:
        raise ValueError(f"Unsupported motor: {motor_name}")

    motor_obj, maxGearboxDiameter, optimizer = MOTOR_LOOKUP[motor_name]
    actuator = build_actuator(motor_obj, maxGearboxDiameter, material_mode, actuator_style)
    return optimizer.optimizeActuator(
        actuator,
        UsePSCasVariable=0,
        log=0,
        csv=1,
        printOptParams=1,
        gearRatioReq=gear_ratio
    )

#-------------------------------------------------
# Optimize for all motors, actuator styles, and material modes
#-------------------------------------------------
motors = ["MAD_M6C12"] #"U8","VT8020", "U12", "U10", "MN8014", 
styles = ["normal", "pancake"]
materials = ["3dp", "metal"]

for motor in motors:
    for style in styles:
        for material_mode in materials:
            totalTime, opt_parameters = run(motor, gear_ratio=0, actuator_style=style, material_mode=material_mode)
            print(f"Optimization Completed : CPG {style} {motor} {material_mode} : Total Time: {totalTime}")
