deepak-kapa/PancakeActuator/(commit log)

2026-04-23 Pancake Actuators framework working v1
    [1.00_10.csv, 1.00_20.csv, 1.00_30.csv, 1.00_40.csv, 1.00_50.csv, 10.00_10.csv, 10.00_20.csv, 10.00_30.csv]
2026-04-23 Add README with CAD models for CPG and Pancake-CPG
2026-04-24 added peak torque logs of all 3 actuators
    [CPG_peak_torque_37.0Nm_20260416_014758.csv, Pancake_peak_torque_37.0Nm_20260418_170953.csv, pancake_winthout_sun_peak_torque_37.0Nm_20260424_150804.csv]
2026-04-24 added stiffness logs of all 3 actuators
    [cpg_stiffness_20250908_172725.csv, pancake_stiffness_20251223_174012.csv, pancake_without_sun_stiffness_20260421_143737.csv]
2026-05-07 Added data of efficiency and endurence
    [10.00_110.csv, 10.00_140.csv, 10.00_20.csv, 10.00_50.csv, 10.00_80.csv, 12.00_110.csv, 12.00_140.csv, 12.00_20.csv]
2026-05-07 Added data of backlash and python scripts for plotting
    [sine_vel_10.000tps_2.00s.csv, sine_vel_2.500tps_2.00s.csv, sine_vel_2.500tps_2.00s_processed.csv, sine_vel_5.000tps_2.00s.csv, sine_vel_5.000tps_2.00s_processed.csv]
2026-05-12 Added Plot codes and some missing data
    [cpg_actuator.SLDASM, cpg_bearing.SLDPRT, cpg_bearing_retainer.SLDPRT, cpg_carrier.SLDPRT, cpg_driver_mount.SLDPRT, cpg_gearbox_casing.SLDPRT, cpg_motor.SLDPRT, cpg_motor_casing.SLDPRT]
2026-05-23 Remove CAD model links from README.md
2026-08-31 added data of eff test of pancake gamma of 0.6
    [10.00Nm_100rpm.csv, 10.00Nm_120rpm.csv, 10.00Nm_20rpm.csv, 10.00Nm_40rpm.csv, 10.00Nm_60rpm.csv, 10.00Nm_80rpm.csv, 12.00Nm_100rpm.csv, 12.00Nm_120rpm.csv]
2026-09-04 added stiffness and backlash data
    [backlash_20260905_002750.csv, backlash_20260905_003550.csv, backlash_20260905_005156.csv, backlash_20260905_023735.csv, backlash_20260905_024611.csv, backlash_20260905_025136.csv, backlash_20260905_025524.csv, stiffness_20260905_012513.csv]
2026-09-06 added backdrivability data
    [backdrive_0to-2.0Nm_40s_t2_opp.csv, backdrive_0to-2.0Nm_40s_t3_opp.csv, backdrive_0to-2.0Nm_40s_t4_opp.csv, backdrive_0to-2.0Nm_40s_t5_opp.csv, backdrive_0to-2.0Nm_40s_t6_opp.csv, backdrive_0to2.0Nm_40s_t1.csv, backdrive_0to2.0Nm_40s_t2.csv, backdrive_0to2.0Nm_40s_t3.csv]
2026-09-06 added backdrivability data for CPG
    [backdrive_0to-2.0Nm_40s_t1_opp.csv, backdrive_0to-2.0Nm_40s_t2_opp.csv, backdrive_0to-2.0Nm_40s_t3_opp.csv, backdrive_0to-2.0Nm_40s_t4_opp.csv, backdrive_0to-2.0Nm_40s_t5_opp.csv, backdrive_0to2.0Nm_40s_t1.csv, backdrive_0to2.0Nm_40s_t2.csv, backdrive_0to2.0Nm_40s_t3.csv]
2026-09-07 added data
    [stiffness_20260905_222038.csv, stiffness_20260905_222755.csv, stiffness_20260905_223441.csv, stiffness_20260905_224537.csv]
2026-09-10 update data
    [backlash_20260905_002750.csv, backlash_20260905_003550.csv, backlash_20260905_005156.csv, backlash_20260910_002703.csv, backlash_20260910_003038.csv, backlash_20260910_003423.csv, backlash_20260910_003717.csv, backlash_20260910_021113.csv]
